jorail/PiedPiperS/docs/PiedPiperS_261_2026_03_25.pdf

# PiedPiperS

### smartphone speed control

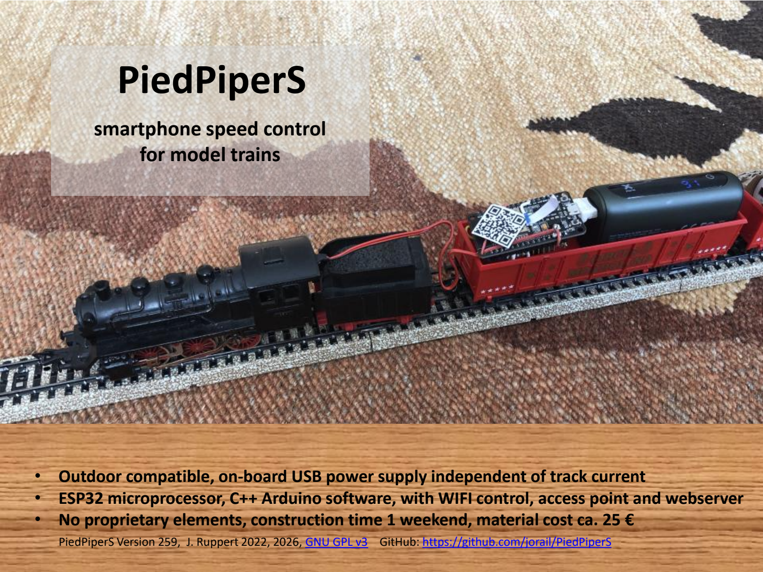
[picture p14: page 1]

### for model trains

- Outdoor compatible, on-board USB power supply independent of track current
- ESP32 microprocessor, C++ Arduino software, with WIFI control, access point and webserver
- No proprietary elements, construction time 1 weekend, material cost ca. 25 €

PiedPiperS Version 259, J. Ruppert 2022, 2026, GNU GPL v3 (https://www.gnu.org/licenses/gpl-3.0.en.html) GitHub: https://github.com/jorail/PiedPiperS

# PiedPiperS outdoor model train operation

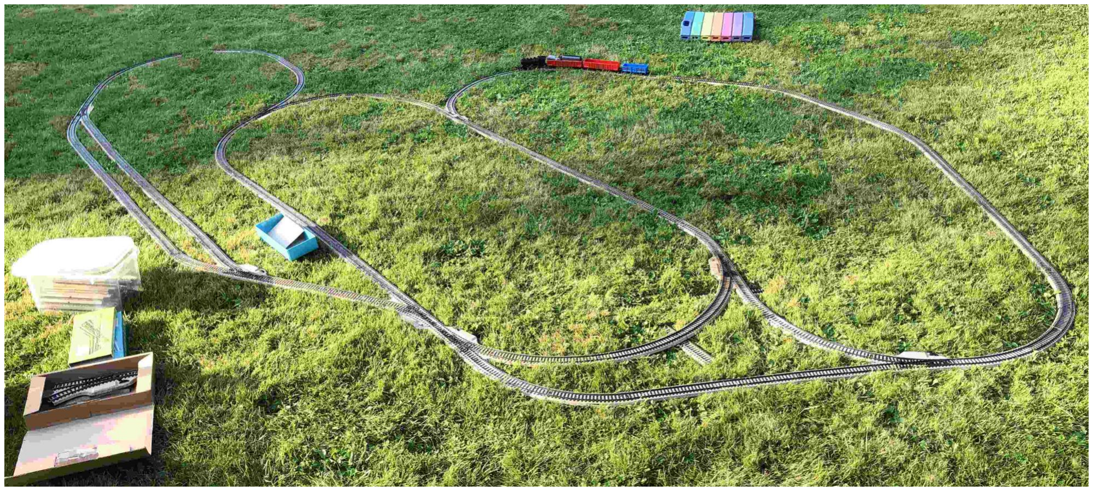
[picture p15: figure]

PiedPiperS (https://github.com/jorail/PiedPiperS) Version 244, J. Ruppert 2021-09-05, GNU GPL v3 (https://www.gnu.org/licenses/gpl-3.0.en.html)

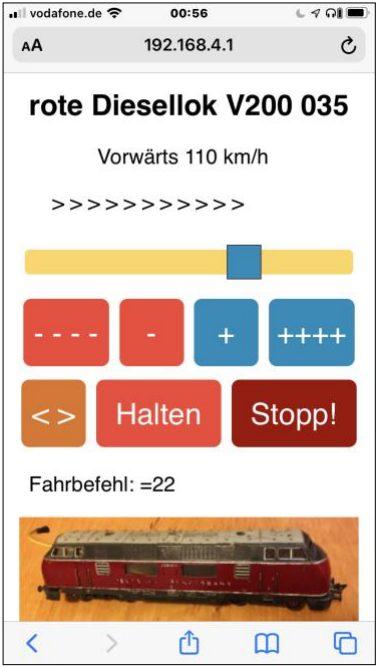
[picture p16: figure]

# Train control website on smartphone

- Compatible with every smartphone with WIFI
- ESP32 WIFI access point mounted on train
- Browser access to control panel via webserver
- Stable WIFI remote control for up to two users on HTML website with addition of simple JavaScript functions
- Additional manual control via touch pin
- Feedback from train operation on two LEDs
- Motor IC error handling, short cut protection
- ESP32 voltage spike and brownout protection
- Option for online power measurement and data display in tables and charts
- Option for true speed measurement by IR sensor detection of railway sleepers

PiedPiperS (https://github.com/jorail/PiedPiperS) Version 244, J. Ruppert 2021-09-05, GNU GPL v3 (https://www.gnu.org/licenses/gpl-3.0.en.html)

# PiedPiperS touch commands

Touch code | Command for speed level | Meaning
- | -- | decrease speed
•• | -------- | slow down
••• | -------------------------------- | brake to halt
•••• | 0 | fast brake and stop
••••• | 00< | fast stop, reverse direction
- ― | ++ | increase speed
- ― ― | ++++++++ | speed up
- ― ― ― | ++++++++++++++++ | go fast
― | 0 | fast brake and stop
― ― | 00 | fast brake and stop
| 00 | fast brake and stop
― ― ― | ? | info?

PiedPiperS (https://github.com/jorail/PiedPiperS) Version 244, J. Ruppert 2021-08-26, GNU GPL v3 (https://www.gnu.org/licenses/gpl-3.0.en.html)

# PiedPiper LED indicators

LEDs
Information on motor direction and speedlevel 0 to 32: • forward = 1 = blue LED + 0 to 16 short LED flashes • backward = 0 = red LED + 0 to 16 short LED flashes

Adjustment of motor speed: • 2 blue LED flash = speed level + 2; • 2 red LED flash = speed level - 2; • green & red LEDs long flash = fast brake, speed level = 0

Change of motor direction: • blue/red/blue + blue LED flash = forward = 1 • red/blue/red + red LED flash = backward = 0

Program running and main loop frequency: • orange flash after 5,000 main loop cycles, 200 times monitoring for input activity and up to 5 speed adjustments

PiedPiperS (https://github.com/jorail/PiedPiperS) Version 244, J. Ruppert 2021-08-26, GNU GPL v3 (https://www.gnu.org/licenses/gpl-3.0.en.html)

# PiedPiperS integrated version

## https://github.com/jorail/PiedPiperS

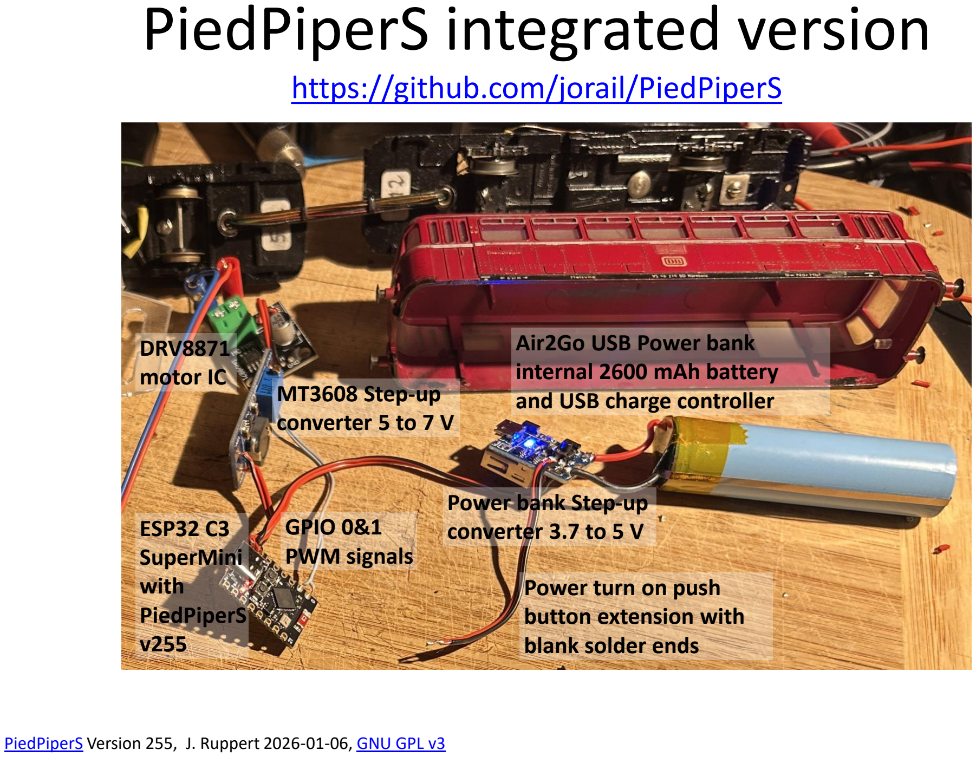
[picture p17: page 6]

PiedPiperS (https://github.com/jorail/PiedPiperS) Version 255, J. Ruppert 2026-01-06, GNU GPL v3 (https://www.gnu.org/licenses/gpl-3.0.en.html)

ESP32 C3
SuperMini
with
PiedPiperS
v255

DRV8871
motor IC
MT3608 Step-up
converter 5 to 7 V

Power bank Step-up
converter 3.7 to 5 V

Air2Go USB Power bank
internal 2600 mAh battery
and USB charge controller

Power turn on push
button extension with
blank solder ends

GPIO 0&1
PWM signals

# PiedPiperS integrated version

## https://github.com/jorail/PiedPiperS

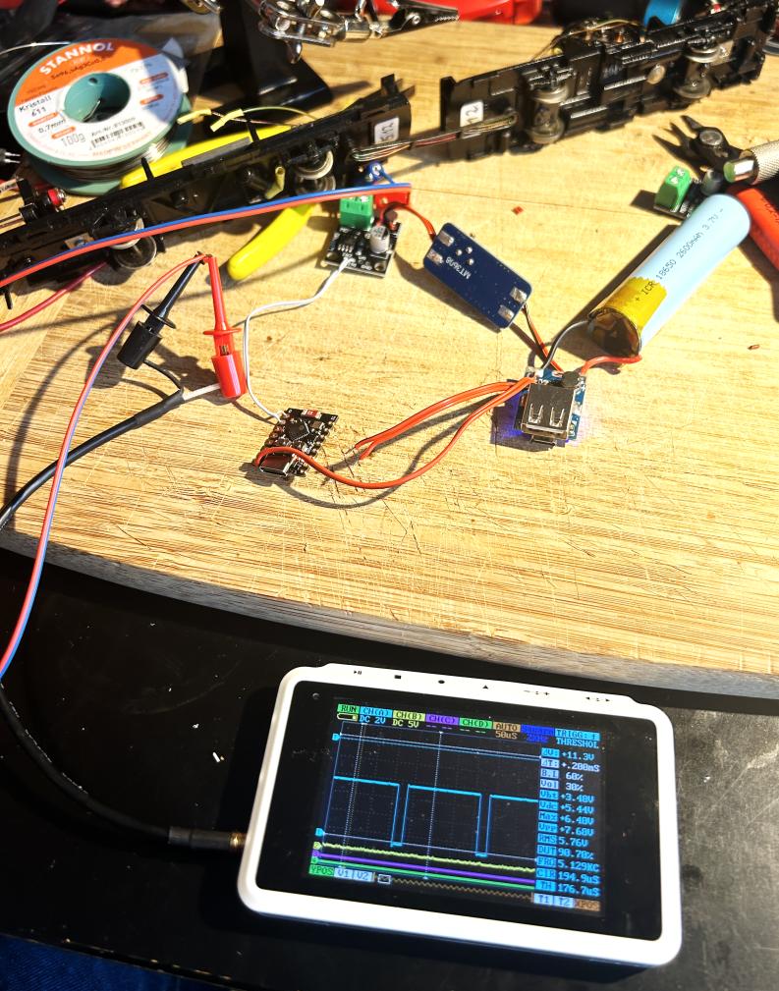
[picture p18: figure]

PiedPiperS (https://github.com/jorail/PiedPiperS) Version 255, J. Ruppert 2026-01-06, GNU GPL v3 (https://www.gnu.org/licenses/gpl-3.0.en.html)

PWM gesteuerte
Ausgangsspannung
der H-Brücke für
Motorregelung

# PiedPiperS v259 für Schienenbus VT 98

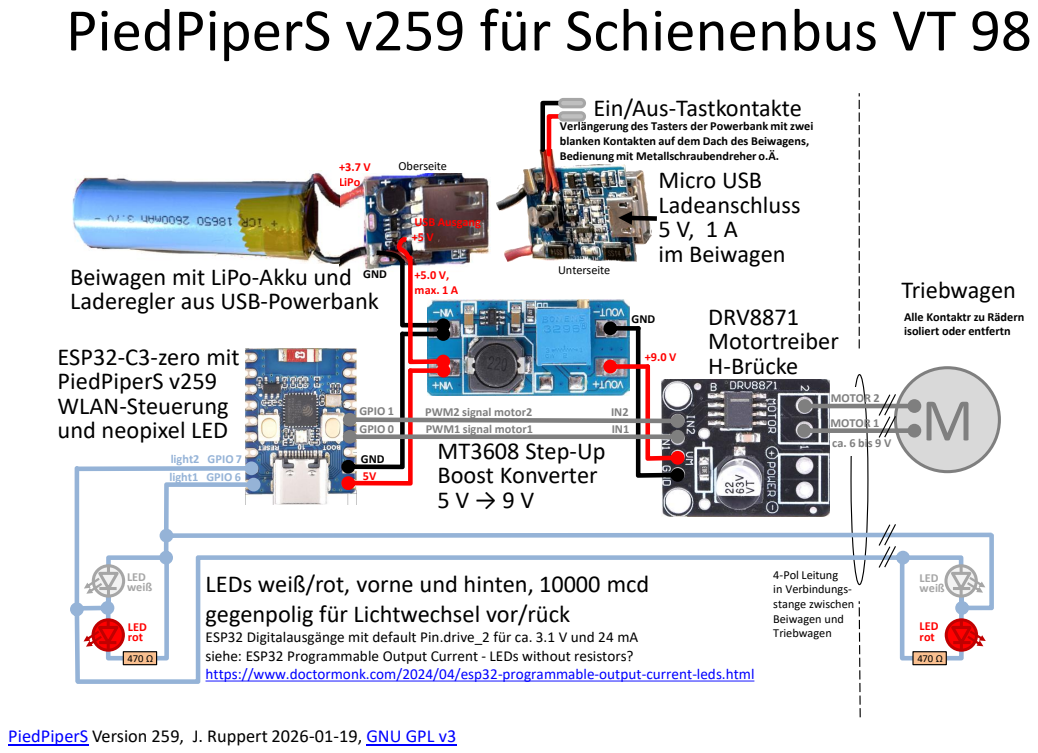
[picture p19: page 8]
GPIO 1 GPIO 0; GND 5V; PWM2 PWM1; signal signal; motor2 motor1; +5.0 V, max. 1 A; USB Ausgang +5 V; GND; +3.7 V LiPo; GPIO 7 GPIO 6; MOTOR 2; MOTOR 1; Micro USB Ladeanschluss 5 V, 1 A im Beiwagen; light2 light1; LED weiß; LED rot; ca. 6 bis 9 V; 4-Pol Leitung in Verbindungs- stange zwischen Beiwagen und Triebwagen; Triebwagen; DRV8871 Motortreiber H-Brücke; MT3608 Step-Up Boost Konverter 5 V → 9 V; Oberseite; Unterseite

Ein/Aus-Tastkontakte

Verlängerung des Tasters der Powerbank mit zwei
blanken Kontakten auf dem Dach des Beiwagens,
Bedienung mit Metallschraubendreher o.Ä.

Beiwagen mit LiPo-Akku und
Laderegler aus USB-Powerbank

Alle Kontaktr zu Rädern
isoliert oder entfertn

ESP32-C3-zero mit
PiedPiperS v259
WLAN-Steuerung
und neopixel LED

LEDs weiß/rot, vorne und hinten, 10000 mcd
gegenpolig für Lichtwechsel vor/rück
ESP32 Digitalausgänge mit default Pin.drive_2 für ca. 3.1 V und 24 mA
siehe: ESP32 Programmable Output Current - LEDs without resistors?
https://www.doctormonk.com/2024/04/esp32-programmable-output-current-leds.html

PiedPiperS (https://github.com/jorail/PiedPiperS) Version 259, J. Ruppert 2026-01-19, GNU GPL v3 (https://www.gnu.org/licenses/gpl-3.0.en.html)

# Schienenbus VT98 Beiwagen LiPo Akku und Steuerung eingebaut

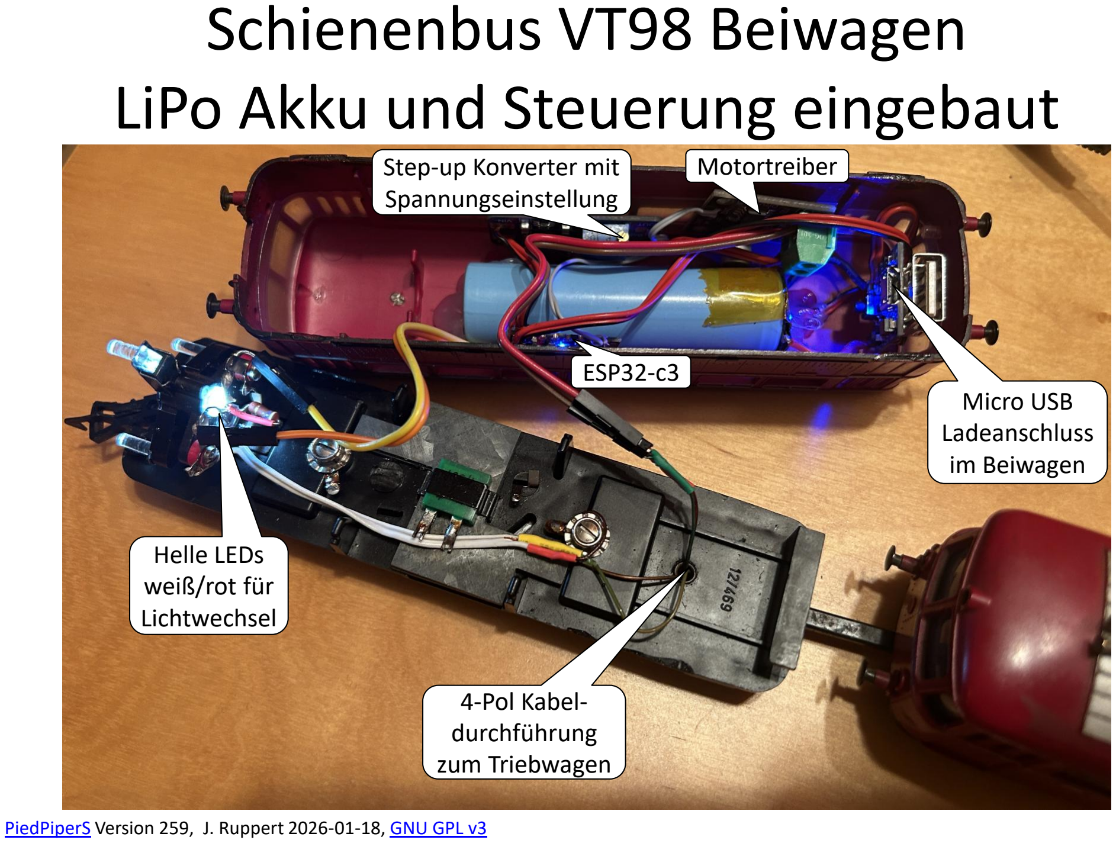
[picture p20: page 9]

PiedPiperS (https://github.com/jorail/PiedPiperS) Version 259, J. Ruppert 2026-01-18, GNU GPL v3 (https://www.gnu.org/licenses/gpl-3.0.en.html)

Micro USB
Ladeanschluss
im Beiwagen

4-Pol Kabel-durchführung
zum Triebwagen

Step-up Konverter mit
Spannungseinstellung

Motortreiber

ESP32-c3

Helle LEDs
weiß/rot für
Lichtwechsel

# Stirnlichter

## LED weiß/rot gegenpolig und mit Vorwiderstand für rote LED

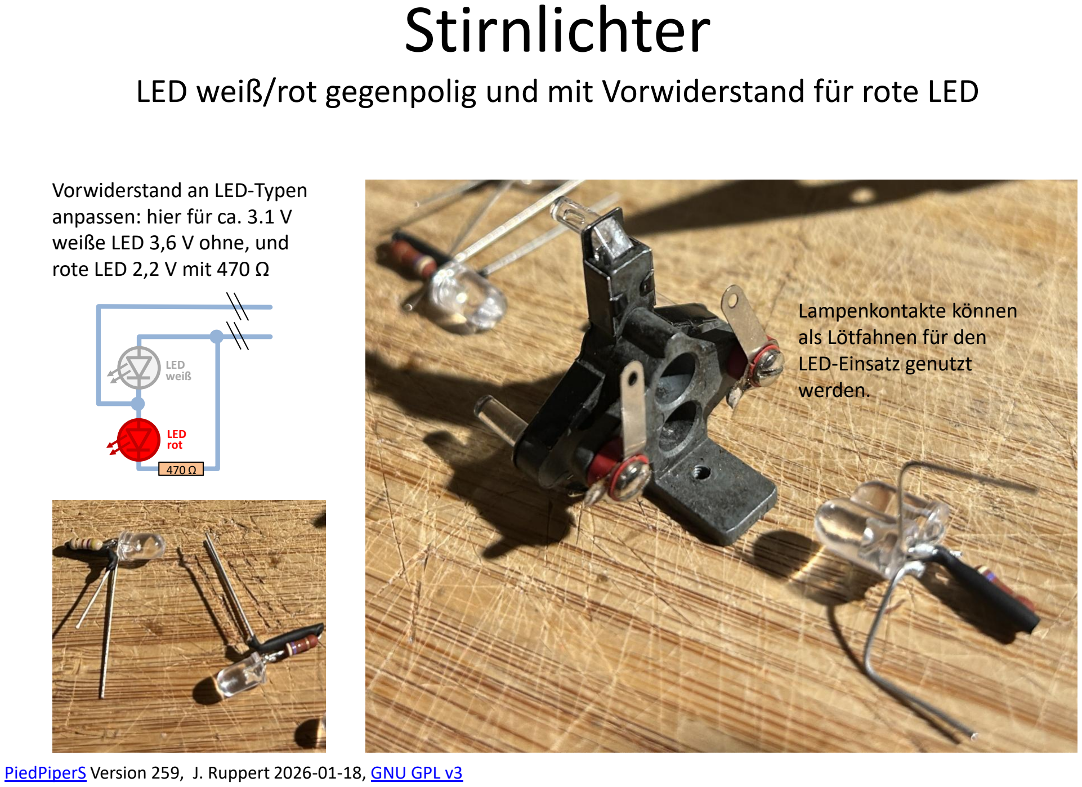
[picture p21: page 10]

470 Ω

LED
weiß

LED
rot

Vorwiderstand an LED-Typen anpassen: hier für ca. 3.1 V weiße LED 3,6 V ohne, und
rote LED 2,2 V mit 470 Ω

Lampenkontakte können
als Lötfahnen für den
LED-Einsatz genutzt
werden.

PiedPiperS (https://github.com/jorail/PiedPiperS) Version 259, J. Ruppert 2026-01-18, GNU GPL v3 (https://www.gnu.org/licenses/gpl-3.0.en.html)

# Schienenbus VT98 Triebwagen

# mit isolierten Radkontakten und LED-Beleuchtung

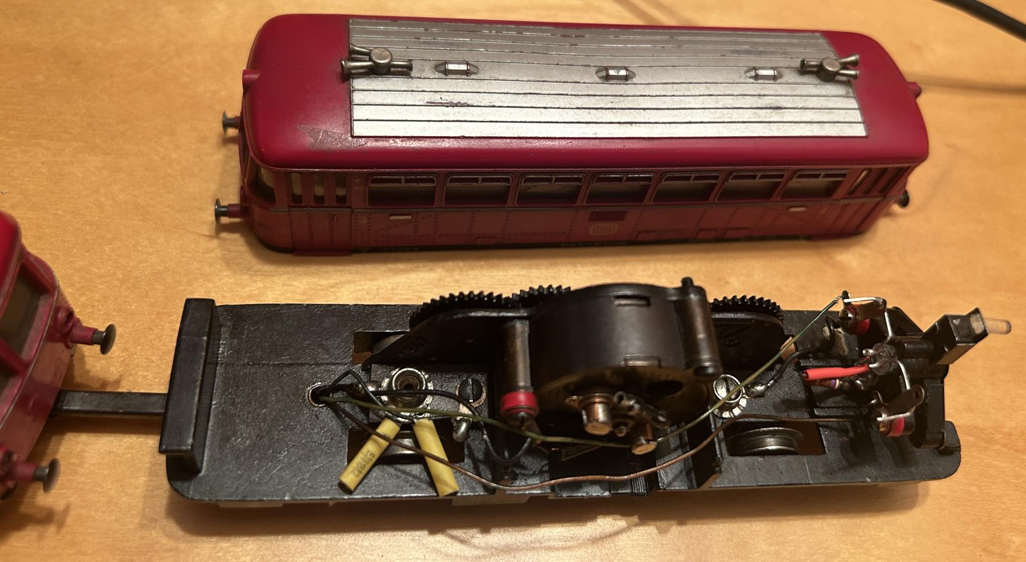
[picture p22: figure]

PiedPiperS (https://github.com/jorail/PiedPiperS) Version 259, J. Ruppert 2026-01-18, GNU GPL v3 (https://www.gnu.org/licenses/gpl-3.0.en.html)

# Schienenbus VT98 Beiwagen

# An/Aus durch Tastkontakt auf dem Dach

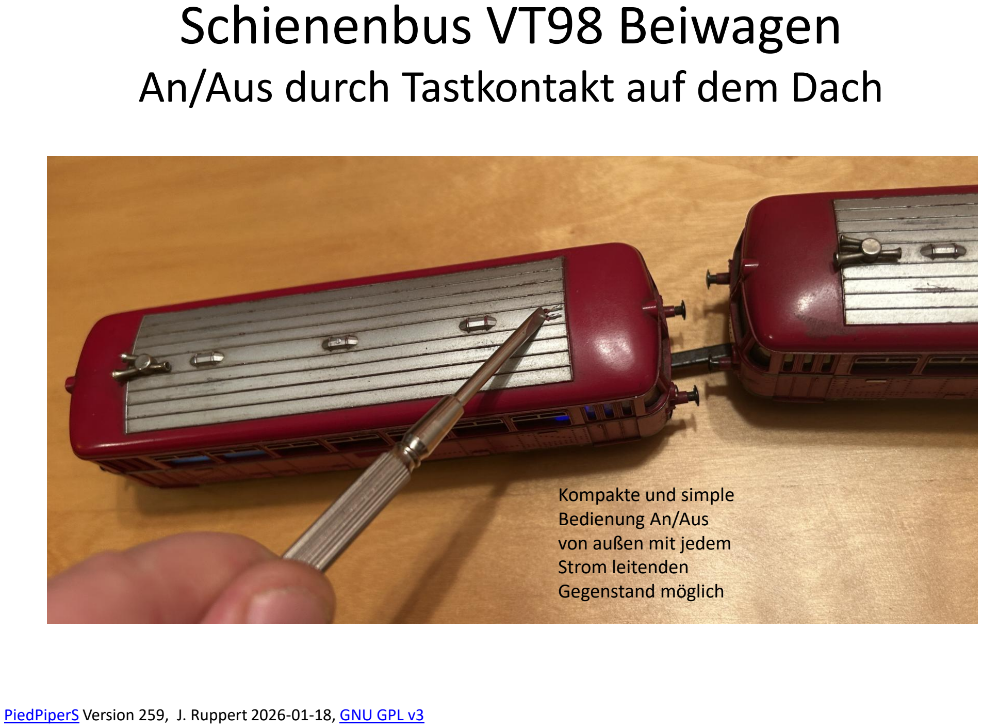
[picture p23: page 12]
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

Kompakte und simple
Bedienung An/Aus
von außen mit jedem
Strom leitenden
Gegenstand möglich

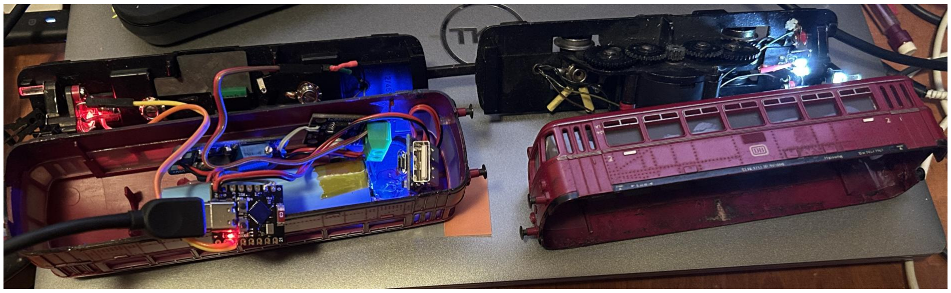
[picture p24: figure]
