jorail/PiedPiperS/docs/PiedPiperS_191_circuit.pdf

# PiedPiperS circuit

## ESP32 DevKit V1, step-up converter and TLE5206-2S

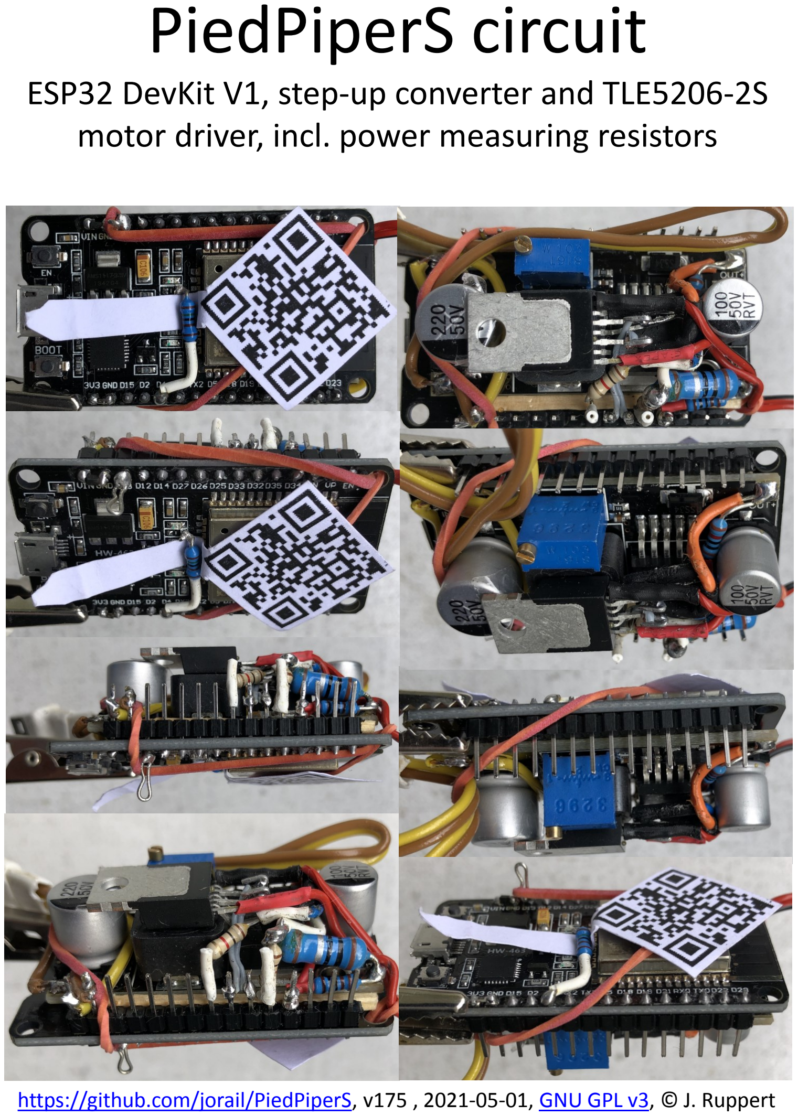
[picture p78: page 1]

## motor driver, incl. power measuring resistors

https://github.com/jorail/PiedPiperS, v175 , 2021-05-01, GNU GPL v3, (https://www.gnu.org/licenses/gpl-3.0.en.html) © J. Ruppert

# ESP32 & TLE5206-2S

integrated mounting and wiring with LDO protection,

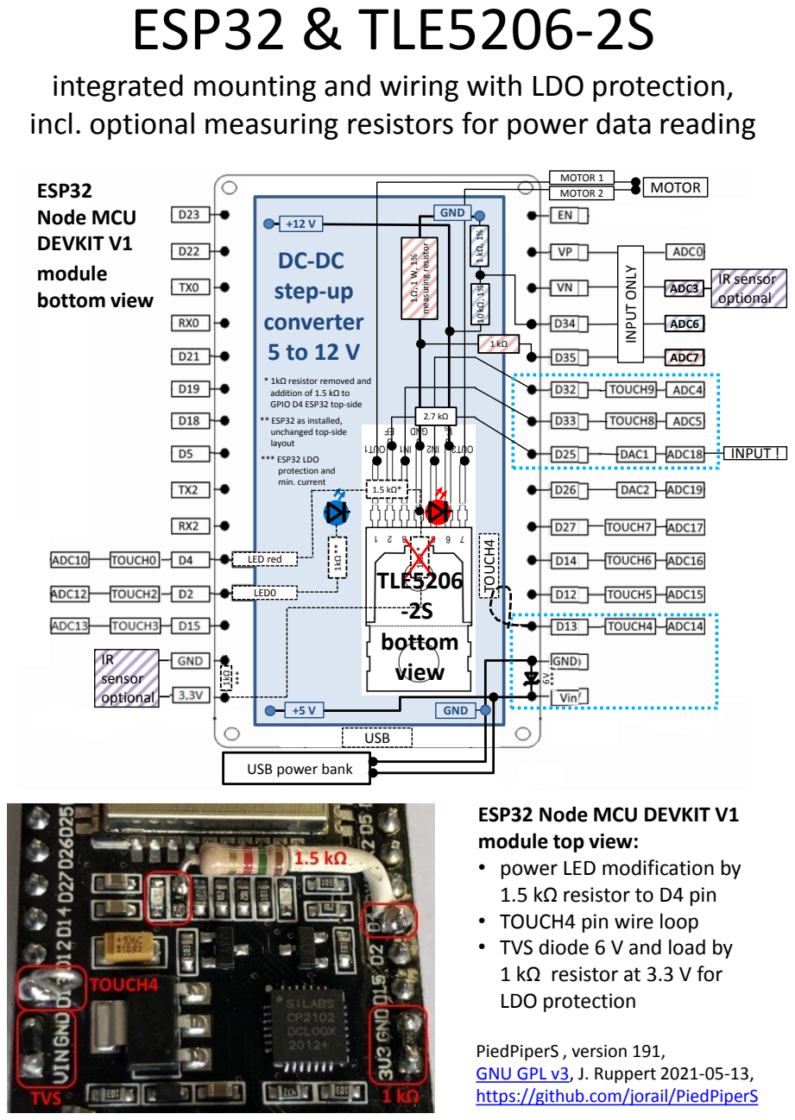
[picture p79: page 2]
ESP32 Node MCU DEVKIT V1 module bottom view; MOTOR; LED0; LED red; GND; DC-DC step-up converter; TOUCH4; TLE5206 -2S bottom view; INPUT !; MOTOR 1 MOTOR 2; USB; measuring resistor; ADC7; ADC6; IR sensor optional ADC3; IR sensor optional

incl. optional measuring resistors for power data reading
https://github.com/jorail/PiedPiperS INPUT ONLY

* 1kΩ resistor removed and
addition of 1.5 kΩ to
GPIO D4 ESP32 top-side
** ESP32 as installed,
unchanged top-side
layout
*** ESP32 LDO
protection and
min. current

USB power bank

ESP32 Node MCU DEVKIT V1
module top view:
• power LED modification by
1.5 kΩ resistor to D4 pin
• TOUCH4 pin wire loop
• TVS diode 6 V and load by
1 kΩ resistor at 3.3 V for
LDO protection

PiedPiperS , version 191,
GNU GPL v3, (https://www.gnu.org/licenses/gpl-3.0.en.html) J. Ruppert 2021-05-13,

# Reflective IR sensor optional

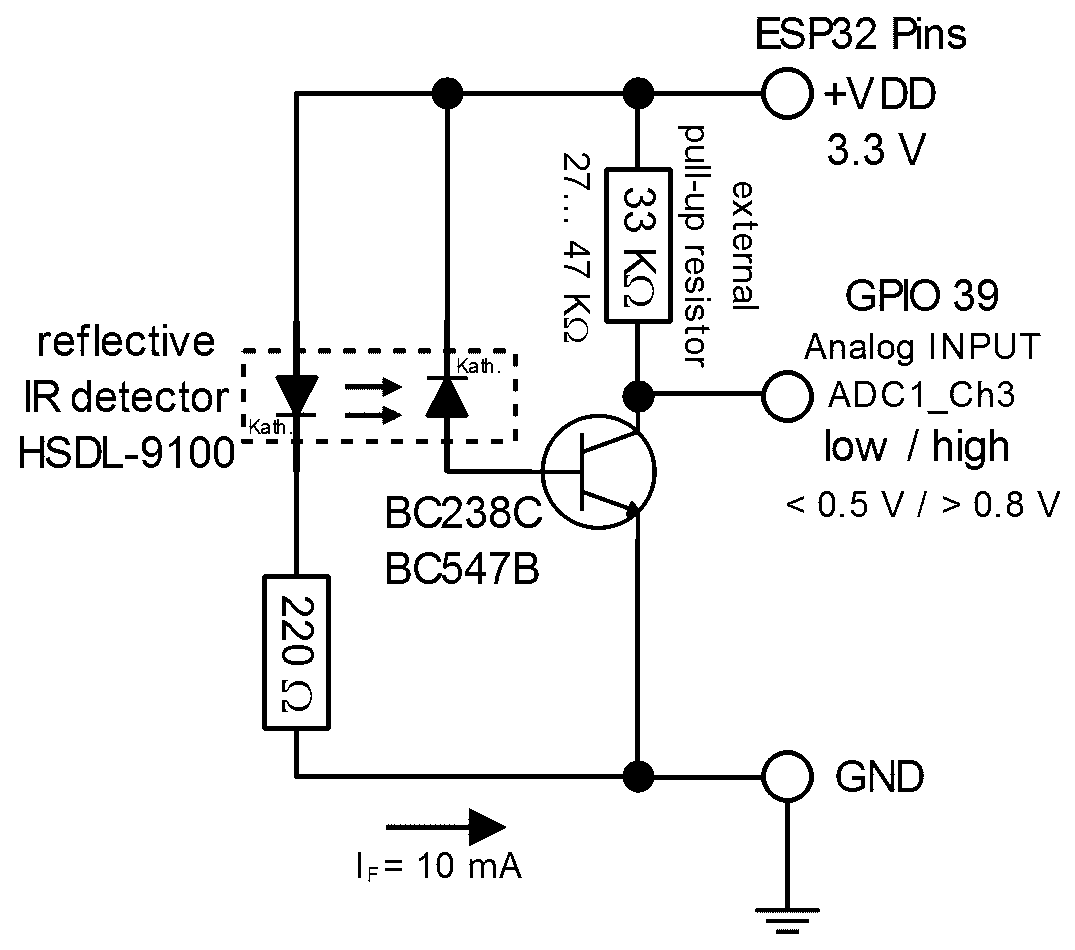
[picture p80: figure]

https://github.com/jorail/PiedPiperS, v191 , 2021-05-13, GNU GPL v3, (https://www.gnu.org/licenses/gpl-3.0.en.html) © J. Ruppert
