jorail/PiedPiperS/PiedPiperS/add_data/PiedPiper.pdf

# PiedPiper

# whistle speed control

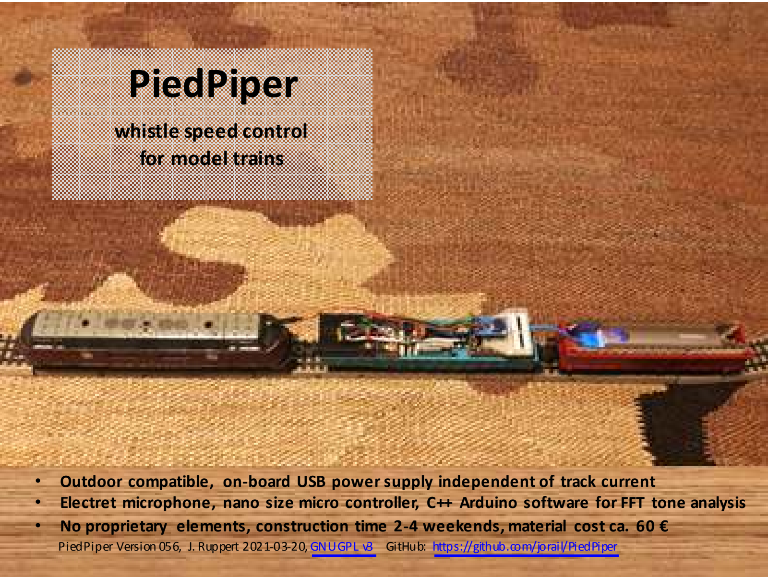
[picture p81: page 1]

# for model trains

## - Outdoor compatible, on-board USB power supply independent of track current

- Electret microphone, nano size micro controller, C++ Arduino software for FFT tone analysis

## - No proprietary elements, construction time 2-4 weekends, material cost ca. 60 €

PiedPiper Version 056, J. Ruppert 2021-03-20, GNU GPL v3 GitHub: https://github.com/jorail/PiedPiper

# Material demand

# for 1 train with whistle control

## Electronics

- Nano size microcontroller,
e.g. Teensy 4.0, but similar solutions are possible with other microcontrollers like Teensy 3.2, ESP32, etc.
– | 1 analogue in for microphone output
– | 2 PWM outputs for motor control
– | 2 digital outputs for LED indicators
– | 1 digital input for option 1 switch
- Compatible electret microphone module, 3.3 V, e.g. MAX9814, Amplifier with Auto Gain Control
- Step-up DC/DC converter module, 5 V to 12V … 16 V
- H-Bridge DC motor control IC, e.g. TLE5206-2S
- Small size USB power bank as 5 V DC power supply
it is good to have two, 2nd for replacement when 1stempty
- Small size breadboard, e.g. 170 contacts
- Solder IC pin contacts, single row, separable, total of ca. 50 contacts
- Shrink tube with diameter for holding two IC pin contacts
- Thin USB cable, old and used, but reliable for power connection
- LEDs: 1 green, 1 red, 2 yellow, 3 mm diameter
- 2 x 180 Ω resistors
- 1 kΩ resistor
- 2 pole cable, thin and flexible, ca. 40 cm, for connection to motor
- 3 pole isolated wire for microphone module, 10 cm
- 1 pole wires for breadboard and step up converter connections, ca. 60 cm in total

## Other material

- Model train locomotive with 12V … 16 V DC motor
- Flat wagon for electronics equipment
- Eaos high board open wagon for USB power bank
- Some paper cardboard
- Single and double sided adhesive tape

## Tools

- Single tone sound source: Whistle or flute, e.g. recorder
- Fine tip solder iron with equipment
- Cutter, fine pincers
- Multi-meter tool

## Option 1 addition

- Micro switch for testing and manual commands
- 10 kΩ resistor
- 1 pole wire, ca. 15 cm

## Option 2 addition

- Small left/right sound balance meter from old equipment, e.g. 270 Ω
- Suitable set of resistors, e.g. 10 kΩ + several 1 to 5 kΩ resistors
- 2 pole cable, thin and flexible, ca. 10 cm

## Estimated material cost ca. 60 € excl. other material, tools and additions

### PiedPiper Version 034, J. Ruppert 2020-11-17, GNU GPL v3

# Soldered IC base contacts and small breadboard

# Nano size micro

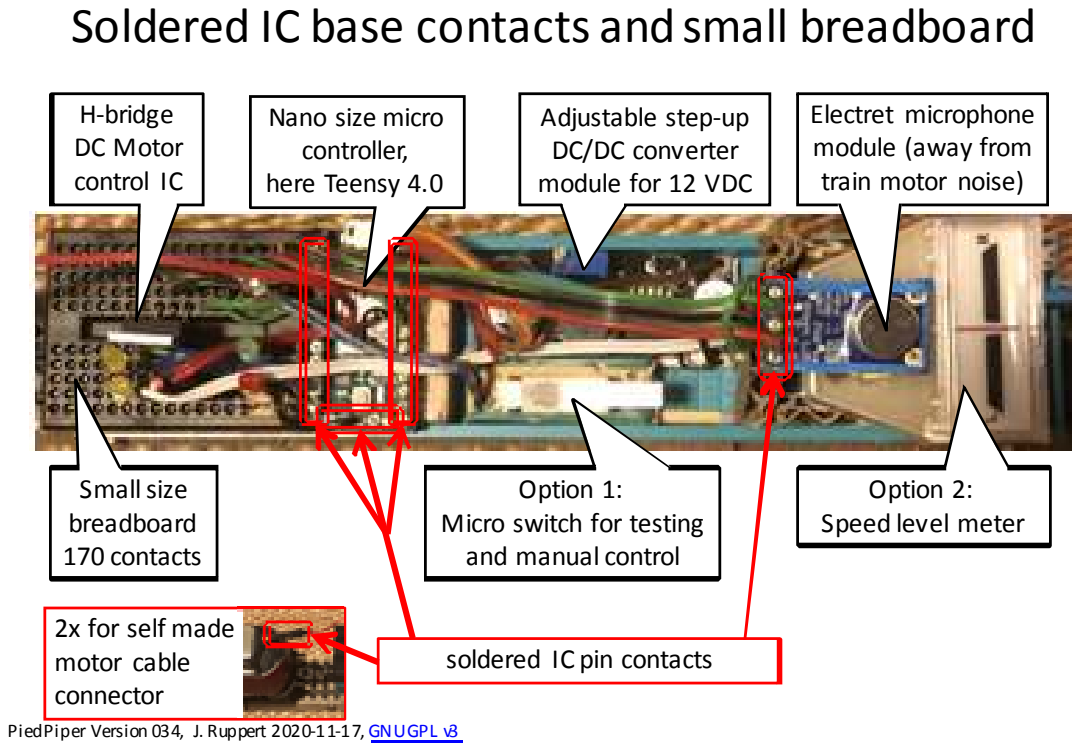
[picture p82: page 3]
controller, here Teensy 4.0; Option 1:; Small size breadboard 170 contacts; H-bridge DC Motor control IC

Electret microphone
module (away from
train motor noise)

Adjustable step-up
DC/DC converter
module for 12 VDC

Option 2:
Speed level meter

Micro switch for testing
and manual control

2x for self made
motor cable
connector

soldered IC pin contacts

# Circuit, parts and connections

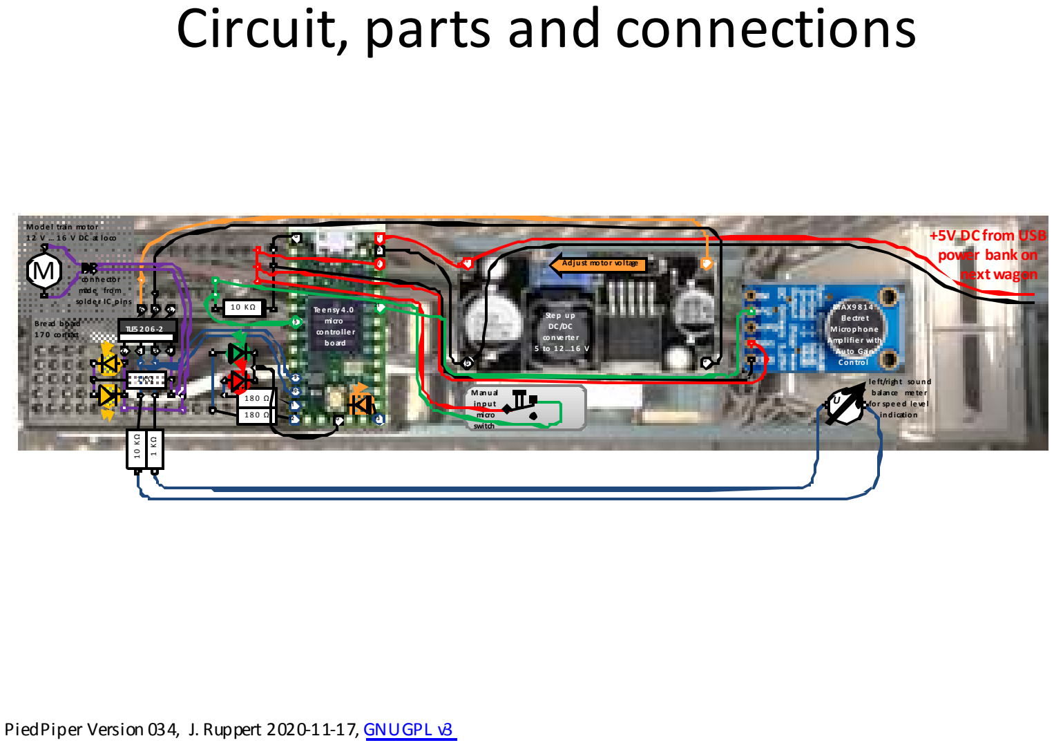
[picture p83: page 4]
TLE5 2 0 6 -2; M an u al in p u t micro switch

M o d e l train mo to r

+5V DC from USB
power bank on
next wagon

Ad ju st mo to r vo ltage

co n n e cto r
mad e fro m

Ele ctre t
M icro p h o n e
Amp lifie r with
Au to Gain
C o n tro l

micro
co n tro lle r
b o ard

Ste p u p
co n ve rte r

Bre ad b o ard
1 7 0 co n tact

le ft/righ t so u n d
b alan ce me te r
in d icatio n

# PiedPiper whistle tone commands

Morse code | Command for speed level | Meaning
- | -- | decrease speed
•• | -------- | slow down
••• | -------------------------------- | break to halt
•••• | 0 | fast brake and stop
••••• | 00< | fast stop, reverse direction
- ― | ++ | increase speed
- ― ― | ++++++++ | speed up
- ― ― ― | ++++++++++++++++ | go fast
― | 0 | fast brake and stop
― ― | 00 | fast brake and stop
| 00 fast brake and stop
― ― ― | ? | info?
? | ? | info?

# PiedPiper LED indicators

## LEDs

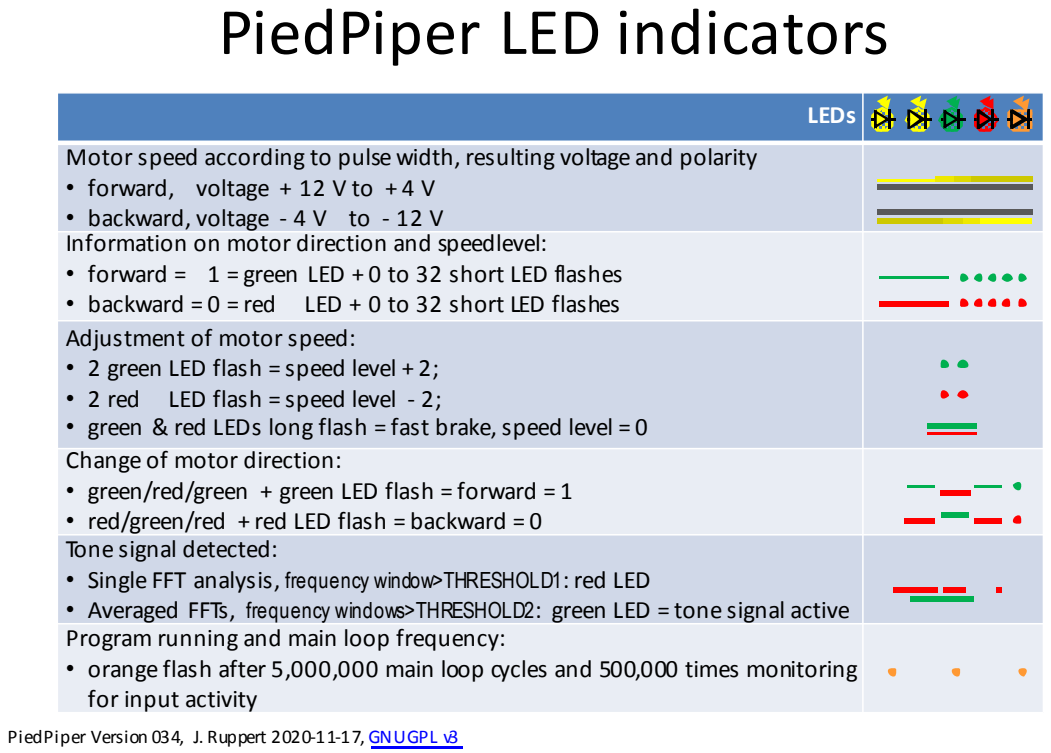
[picture p84: page 6]

Motor speed according to pulse width, resulting voltage and polarity • forward, voltage + 12 V to + 4 V • backward, voltage - 4 V to - 12 V

Information on motor direction and speedlevel: • forward = 1 = green LED + 0 to 32 short LED flashes • backward = 0 = red LED + 0 to 32 short LED flashes

Adjustment of motor speed: • 2 green LED flash = speed level + 2; • 2 red LED flash = speed level - 2; • green & red LEDs long flash = fast brake, speed level = 0

Change of motor direction: • green/red/green + green LED flash = forward = 1 • red/green/red + red LED flash = backward = 0

Tone signal detected: • Single FFT analysis, frequency window>THRESHOLD1: red LED • Averaged FFTs, frequency windows>THRESHOLD2: green LED = tone signal active

Program running and main loop frequency: • orange flash after 5,000,000 main loop cycles and 500,000 times monitoring for input activity

# Tone frequency table

Tone Hertz | Tone Hertz | Tone Hertz | Tone Hertz | Tone Hertz
''A 27,50 | C 65,41 | c' | 261,63 | c''' 1.046,50 | c''''' 4.186,01
''B 29,14 | Des 69,30 | des' 277,18 | des''' 1.108,73
''H 30,87 | D 73,42 | d' | 293,66 | d''' 1.174,66
'C 32,70 | Es 77,78 | es' 311,13 | es''' 1.244,51
'Des 34,65 | E 82,41 | e' | 329,63 | e''' | 1.318,51
'D 36,71 | F 87,31 | f' | 349,23 | f''' 1.396,91
'Es 38,89 | Ges 92,50 | ges' 369,99 | ges''' 1.479,98
'E 41,20 | G 98,00 | g' | 392,00 | g''' | 1.567,98
'F 43,65 | As 103,83 | as' 415,30 | as''' 1.661,22
'Ges 46,25 | A 110,00 | a' | 440,00 | a''' | 1.760,00
'G 49,00 | B 116,54 | b' | 466,16 | b''' 1.864,66
'As 51,91 | H 123,47 | h' | 493,88 | h''' 1.975,53
'A 55,00 | c 130,81 | c'' 523,25 | c'''' 2.093,00
'B 58,27 | des 138,59 | des'' 554,37 | des'''' 2.217,46
'H 61,74 | d 146,83 | d'' 587,33 | d'''' 2.349,32
es 155,56 | es'' 622,25 | es'''' 2.489,02
e 164,81 | e'' 659,26 | e'''' 2.637,02
f 174,61 | f'' 698,46 | f'''' 2.793,83
ges 185,00 | ges'' 739,99 | ges'''' 2.959,96
g 196,00 | g'' 783,99 | g'''' 3.135,96
as 207,65 | as'' 830,61 | as'''' 3.322,44
a 220,00 | a'' 880,00 | a'''' 3.520,00
b 233,08 | b'' 932,33 | b'''' 3.729,31
h 246,94 | h'' 987,77 =default h'''' 3.951,07
