jorail/PiedPiperS/docs/PiedPiperS_095_indoor_9398.JPG

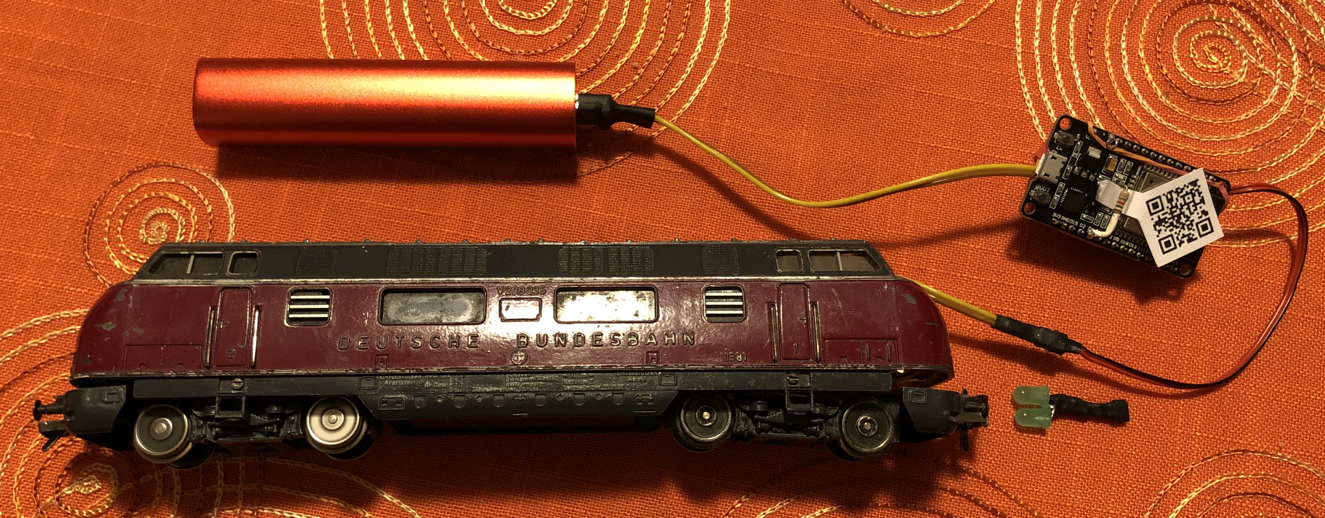
docs/PiedPiperS_095_indoor_9398.JPG
