jorail/PiedPiperS/docs/PiedPiperS_095_indoor_9456.JPG

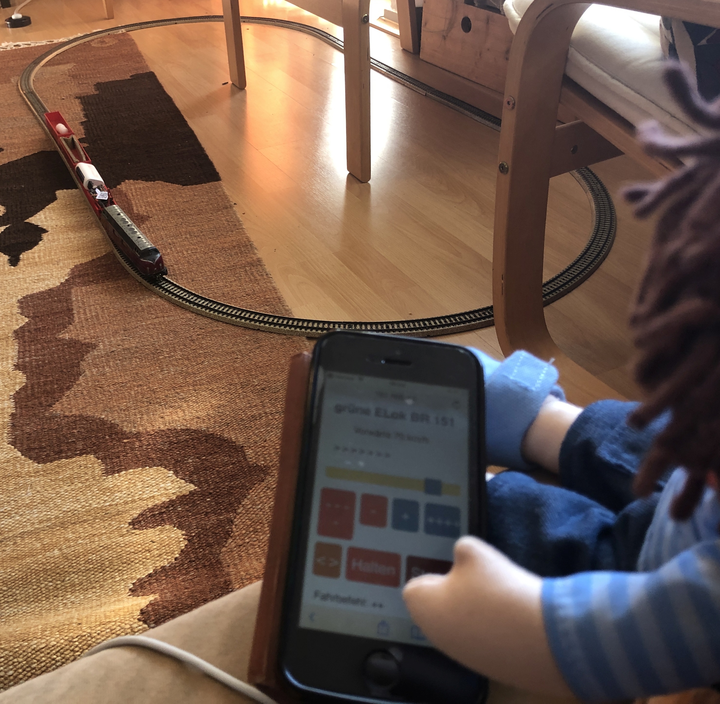
docs/PiedPiperS_095_indoor_9456.JPG
