jorail/PiedPiperS/docs/PiedPiperS_095_indoor_9461.JPG

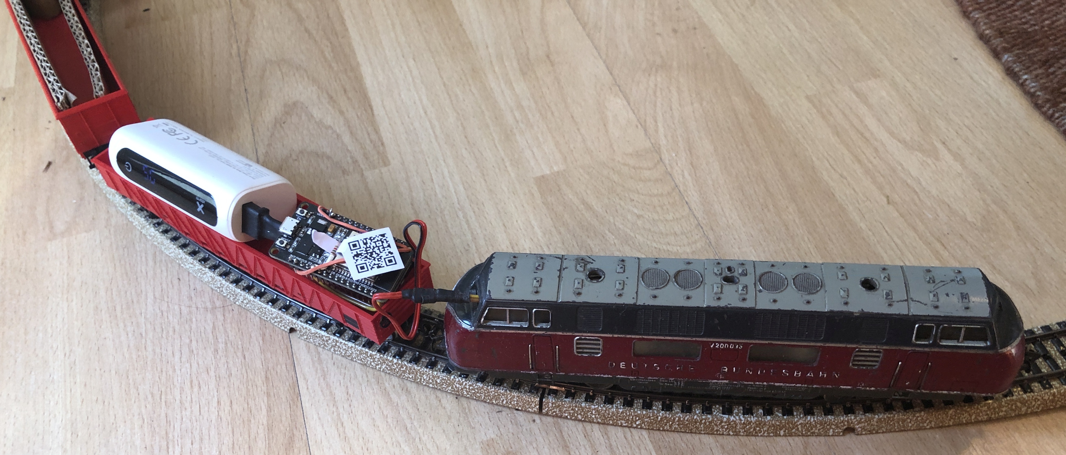
docs/PiedPiperS_095_indoor_9461.JPG
