jorail/PiedPiperS/docs/PiedPiperS_168_measuring_resistors.jpg

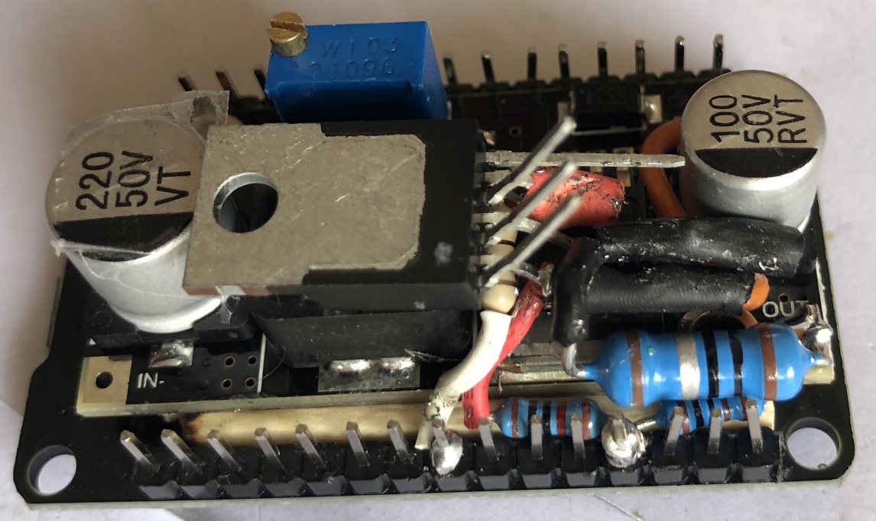
docs/PiedPiperS_168_measuring_resistors.jpg
