jorail/PiedPiperS/docs/PiedPiperS_168_uC_bottomview.jpg

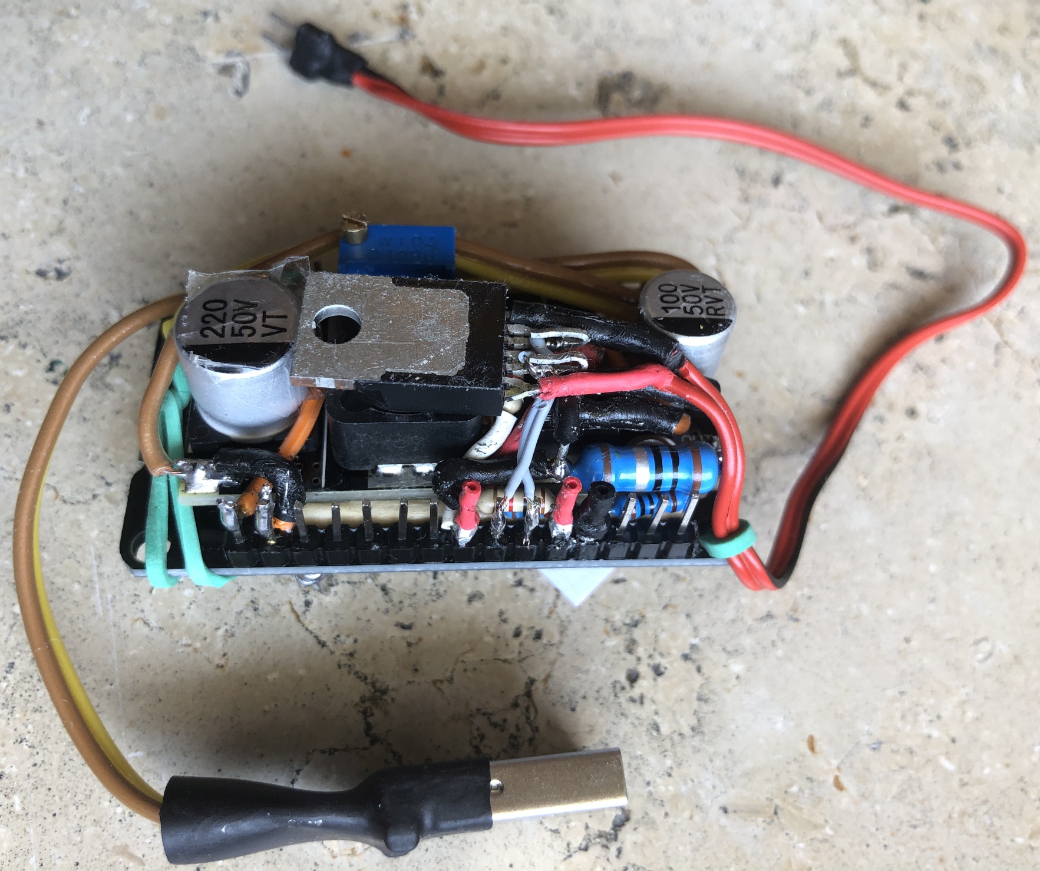
docs/PiedPiperS_168_uC_bottomview.jpg
