jorail/PiedPiperS/docs/PiedPiperS_168_uC_topview.jpg

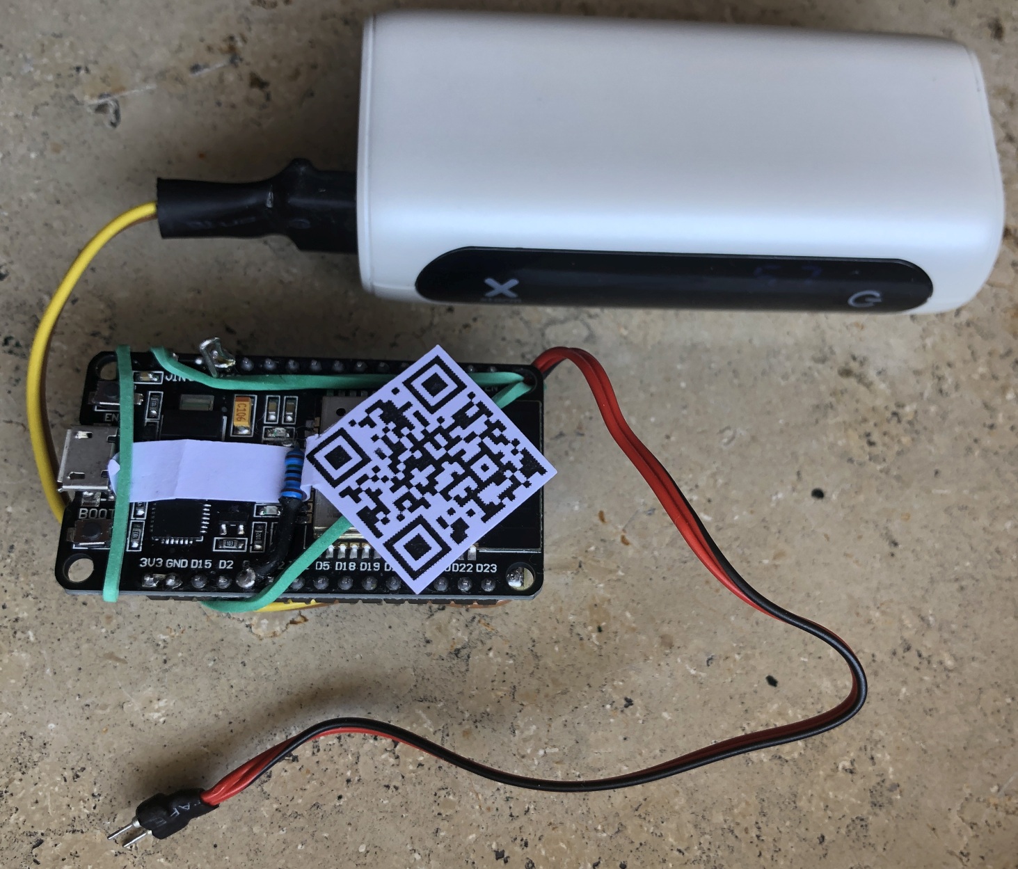
docs/PiedPiperS_168_uC_topview.jpg
