jorail/PiedPiperS/docs/PiedPiperS_173_3examples_bottom.jpg

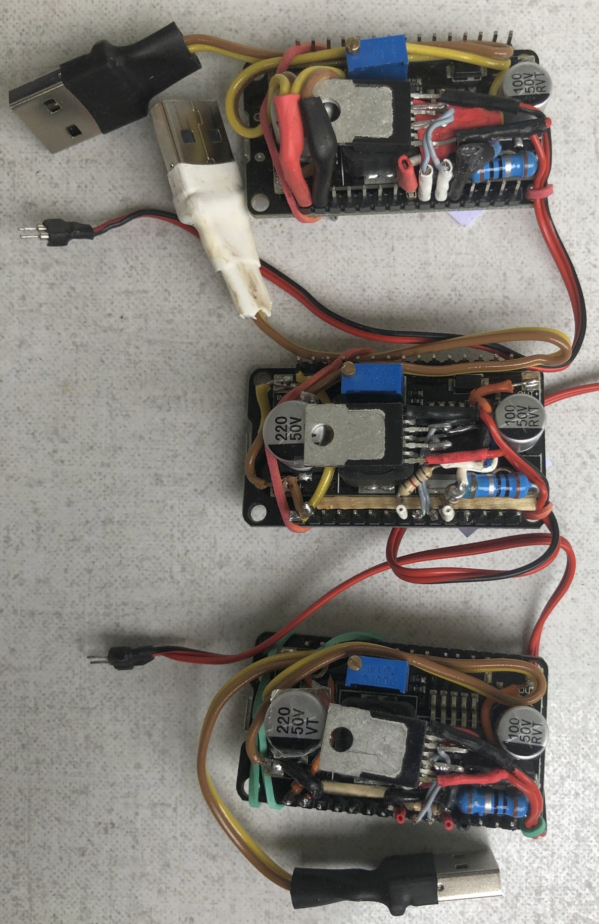
docs/PiedPiperS_173_3examples_bottom.jpg
