jorail/PiedPiperS/docs/PiedPiperS_173_3examples_top.jpg

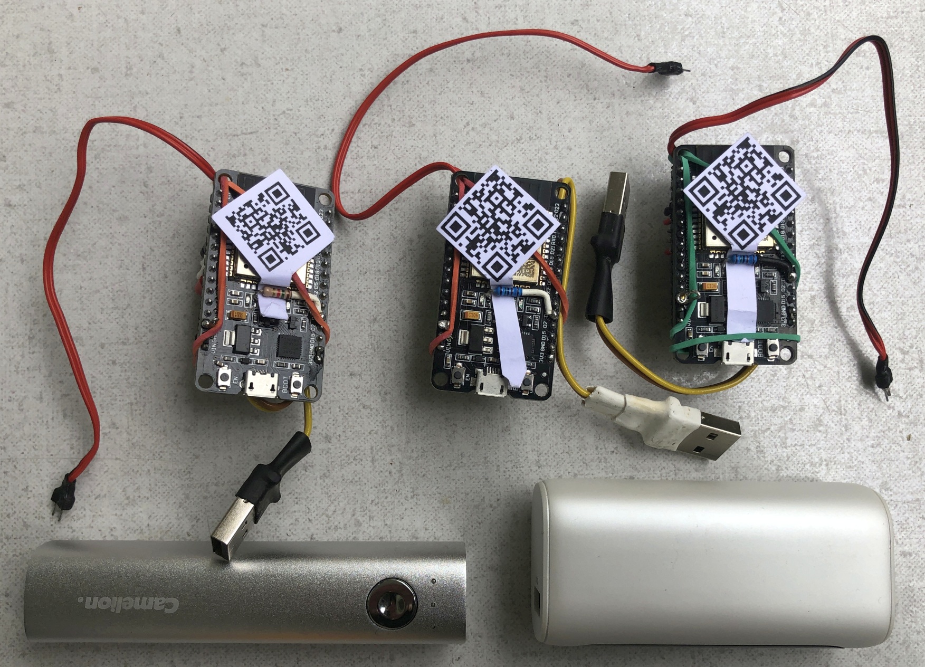
docs/PiedPiperS_173_3examples_top.jpg
