jorail/PiedPiperS/docs/PiedPiperS_175_indoor_9819.JPG

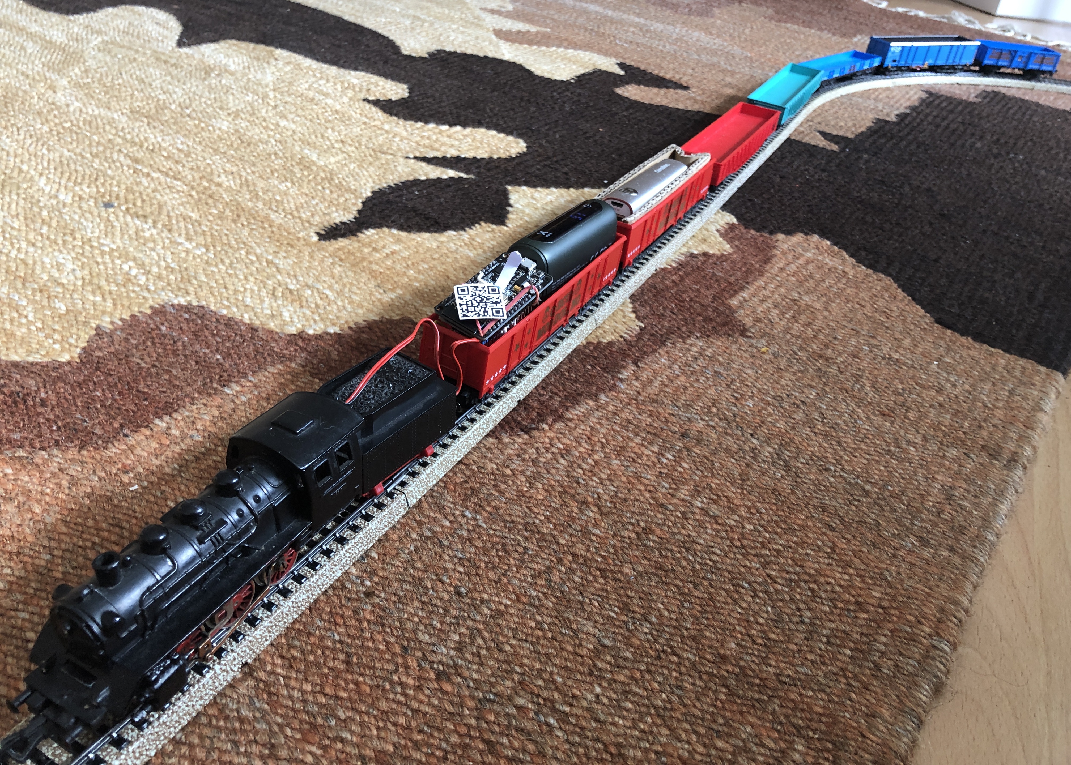
docs/PiedPiperS_175_indoor_9819.JPG
