jorail/PiedPiperS/docs/PiedPiperS_177_SteamLoco_9917.jpg

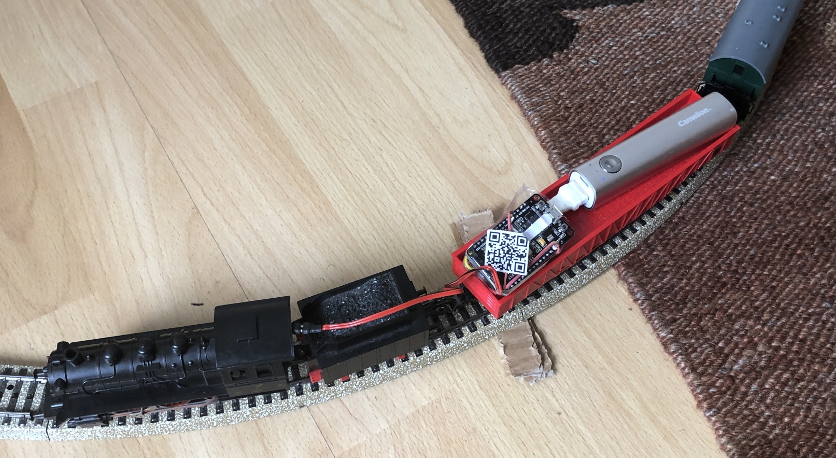
docs/PiedPiperS_177_SteamLoco_9917.jpg
