jorail/PiedPiperS/docs/PiedPiperS_177_SteamLoco_9927.jpg

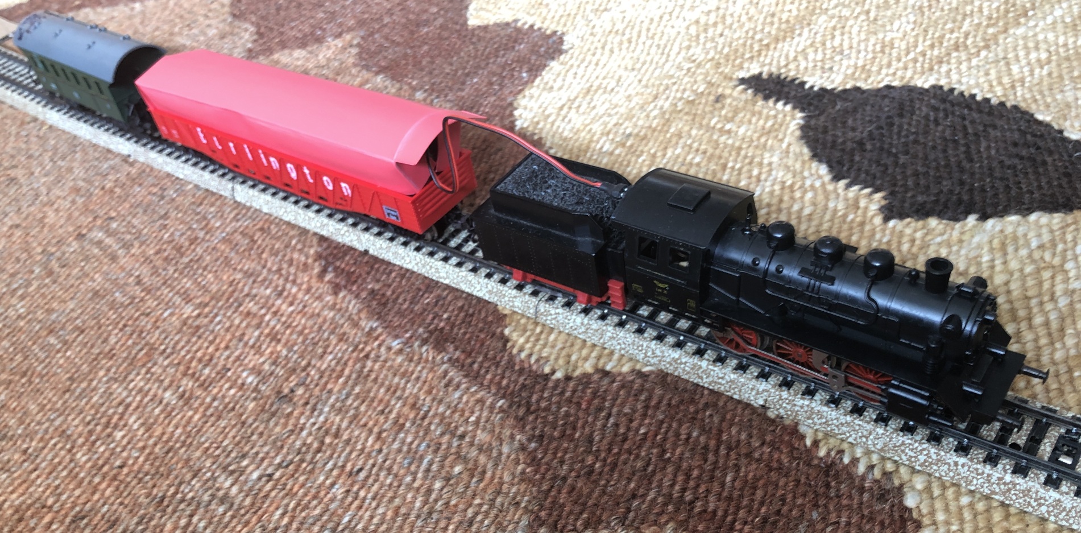
docs/PiedPiperS_177_SteamLoco_9927.jpg
