jorail/PiedPiperS/docs/PiedPiperS_192_circuit.jpg

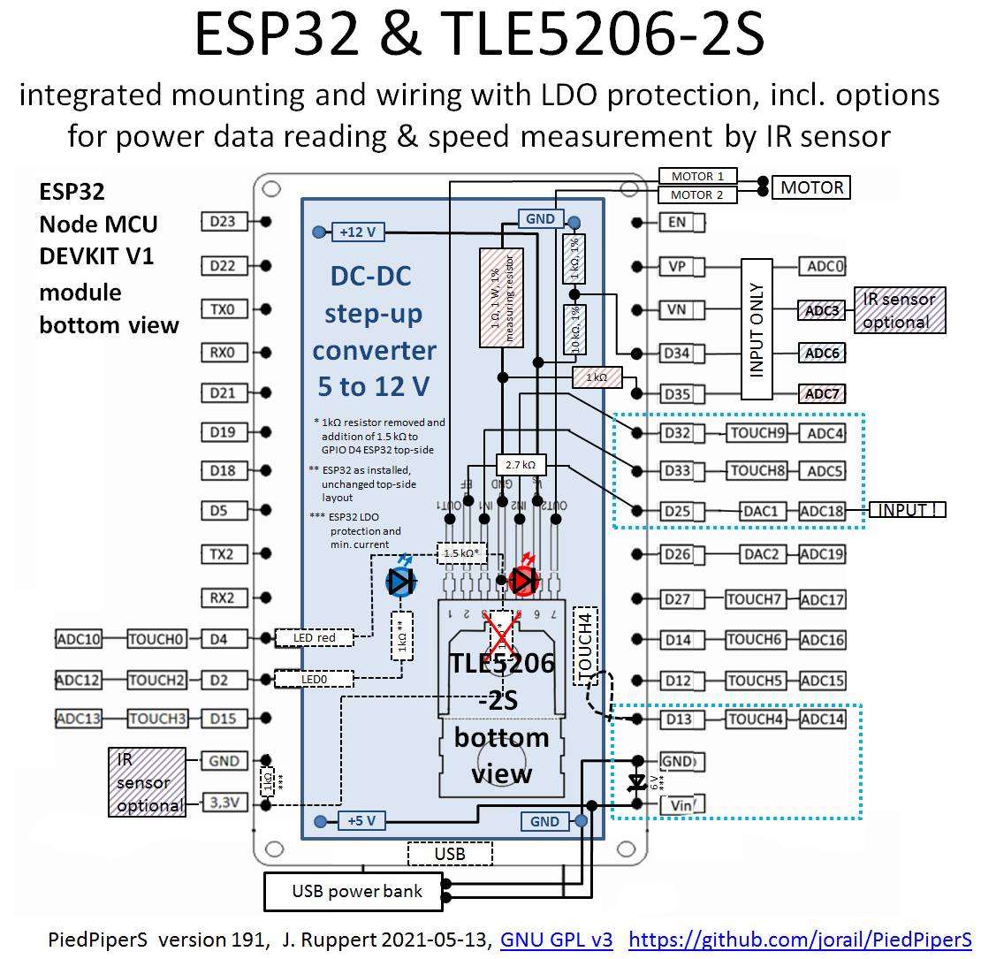
docs/PiedPiperS_192_circuit.jpg
