jorail/PiedPiperS/docs/PiedPiperS_244a.jpg

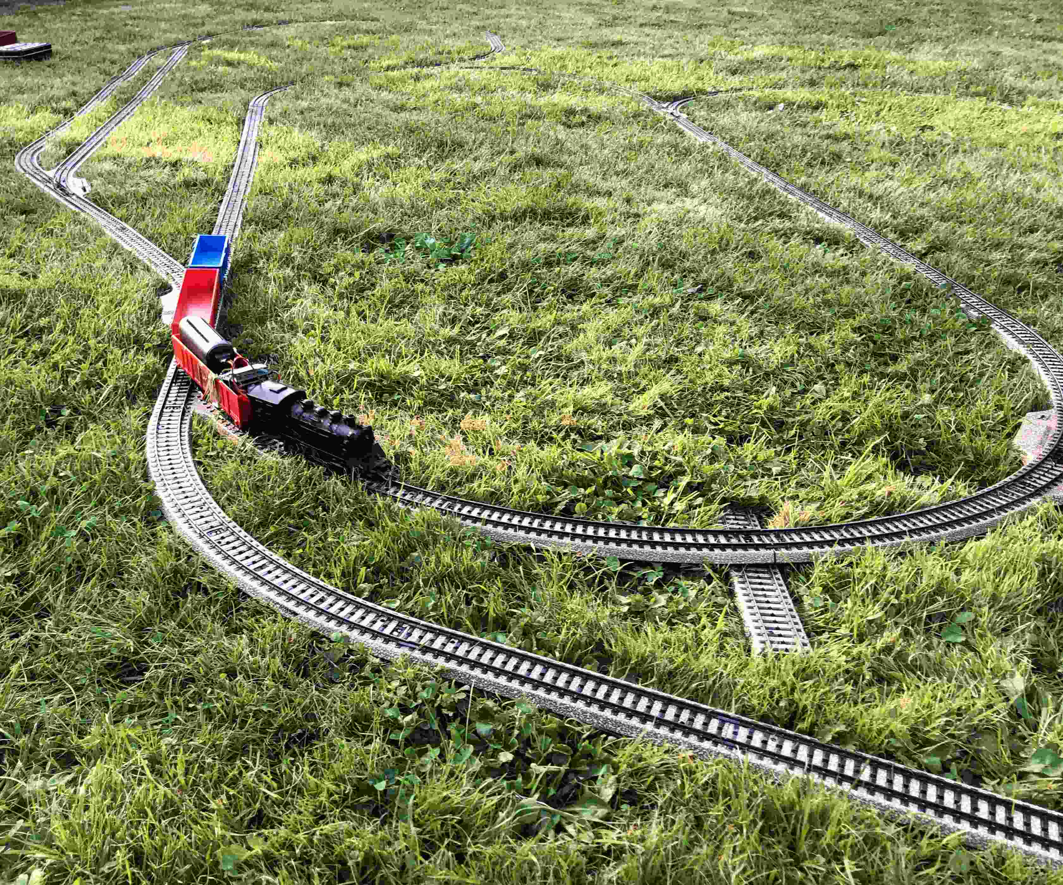
docs/PiedPiperS_244a.jpg
