jorail/PiedPiperS/docs/PiedPiperS_244c.jpg

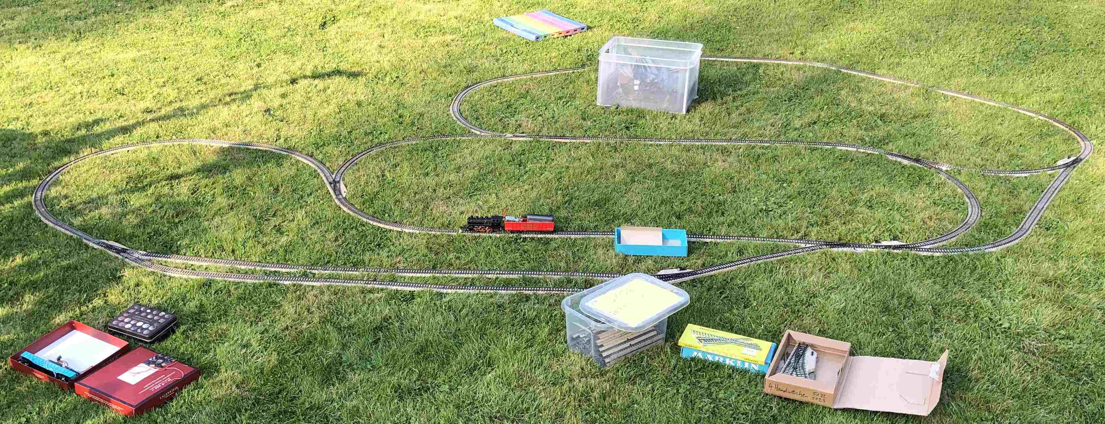
docs/PiedPiperS_244c.jpg
