jorail/PiedPiperS/PiedPiperS/add_data/image/002.jpg

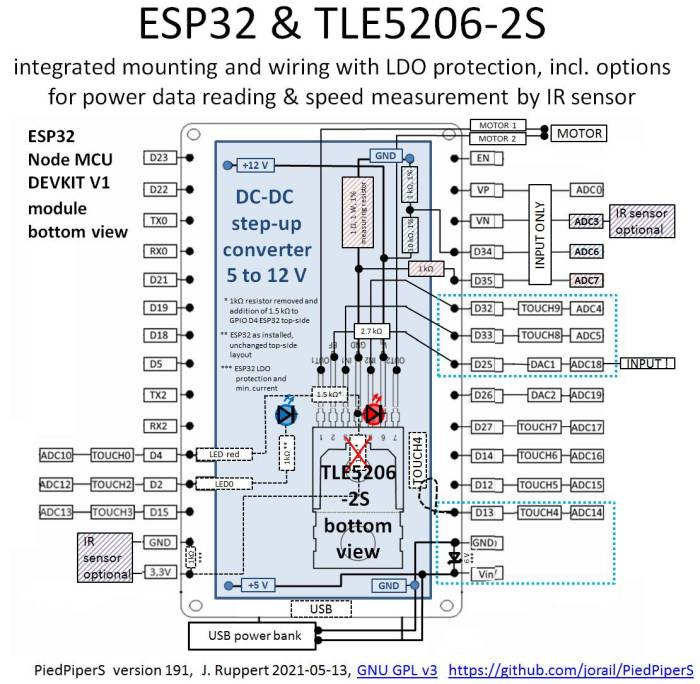
PiedPiperS/add_data/image/002.jpg
