jorail/PiedPiperS/PiedPiperS/add_data/image/005.jpg

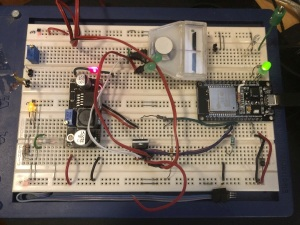
PiedPiperS/add_data/image/005.jpg
