jorail/PiedPiperS/PiedPiperS/add_data/image/006.jpg

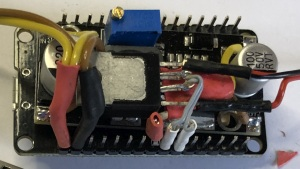
PiedPiperS/add_data/image/006.jpg
