jorail/PiedPiperS/PiedPiperS/add_data/image/007.jpg

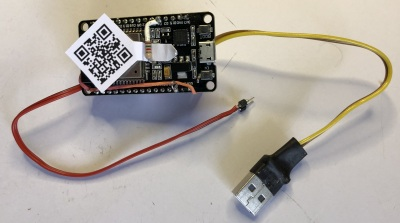
PiedPiperS/add_data/image/007.jpg
