jorail/PiedPiperS/PiedPiperS/add_data/image/009.jpg

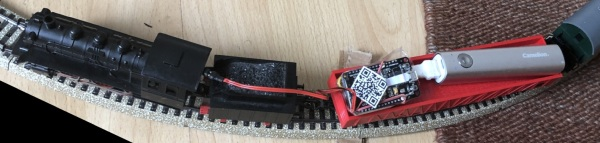
PiedPiperS/add_data/image/009.jpg
