jorail/PiedPiperS/PiedPiperS/add_data/IMG_7513-5.jpg

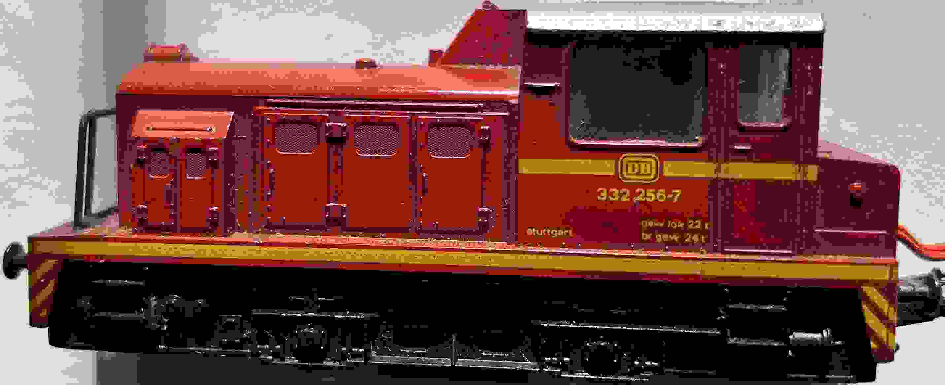
PiedPiperS/add_data/IMG_7513-5.jpg
