jorail/PiedPiperS/PiedPiperS/add_data/IMG_7513-5.png

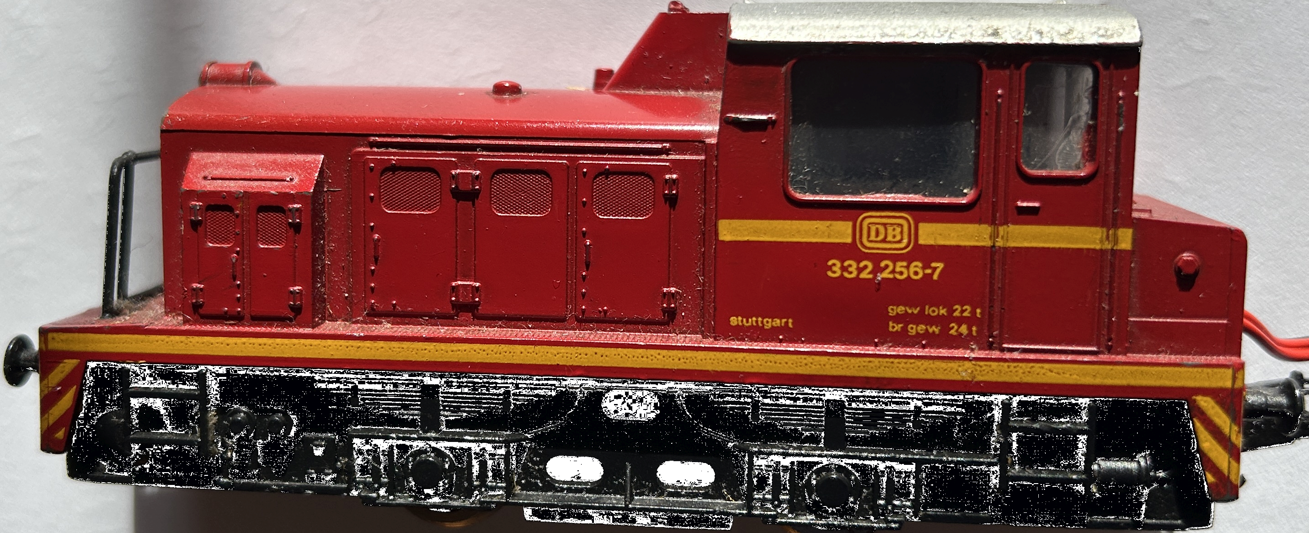
PiedPiperS/add_data/IMG_7513-5.png
