jorail/PiedPiperS/PiedPiperS/add_data/lok.png

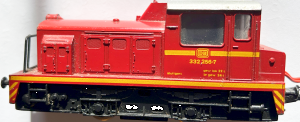
PiedPiperS/add_data/lok.png
