jorail/PiedPiperS/PiedPiperS/data/image/005.jpg

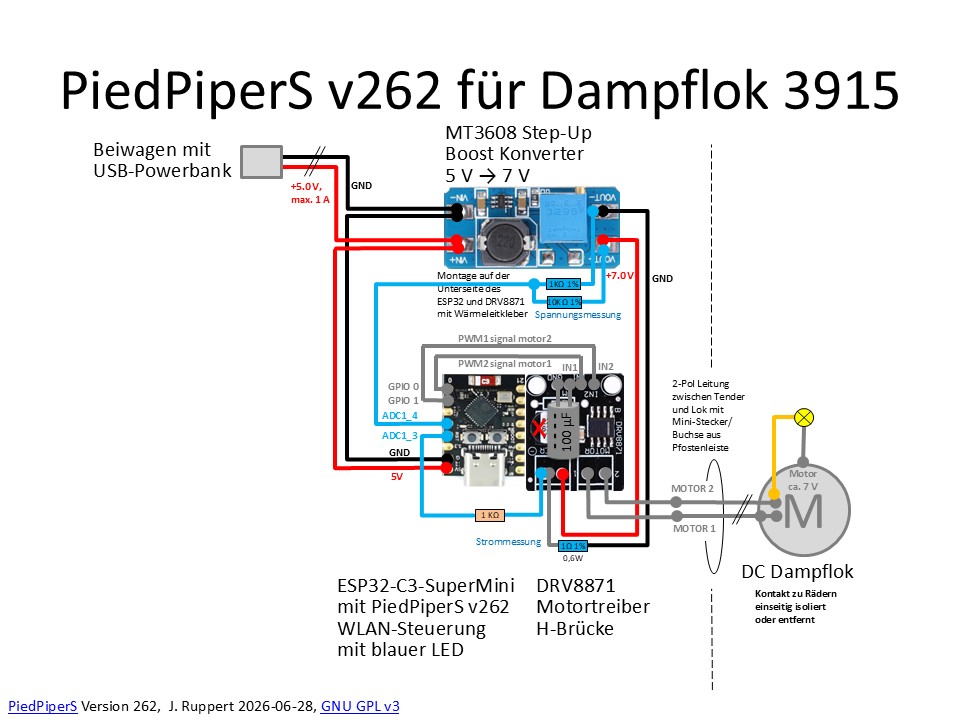
PiedPiperS/data/image/005.jpg
