jorail/PiedPiperS/PiedPiperS/data/image/006.jpg

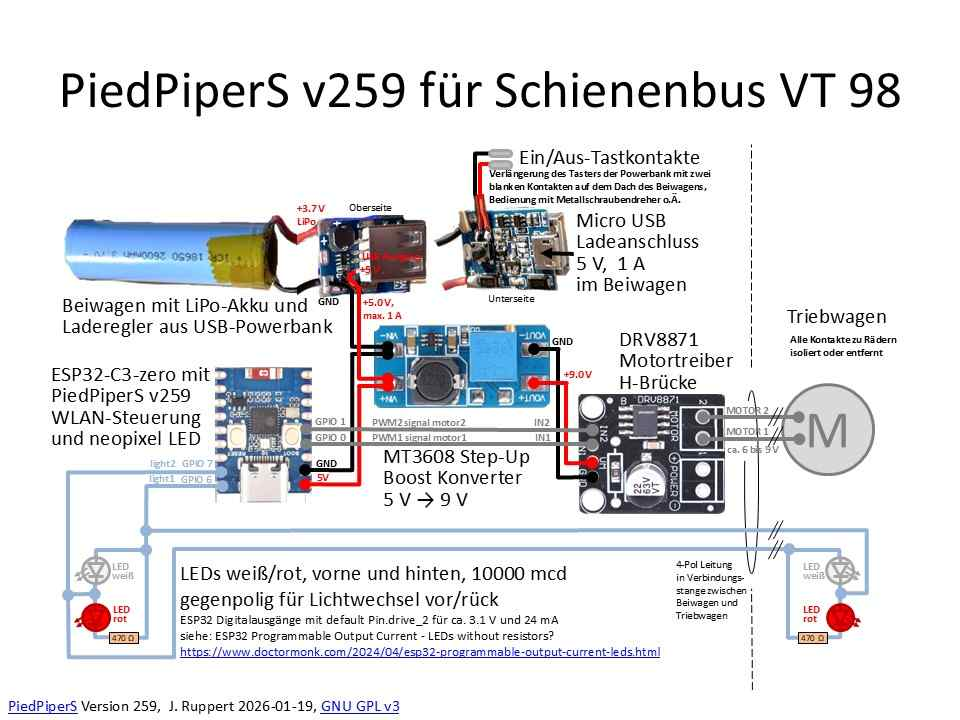
PiedPiperS/data/image/006.jpg
