jorail/PiedPiperS/PiedPiperS/data/image/007.jpg

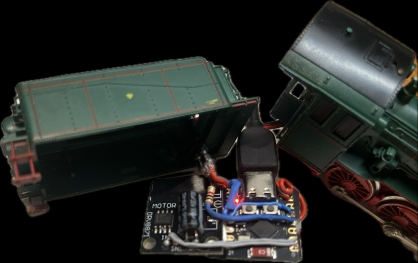
PiedPiperS/data/image/007.jpg
