jorail/PiedPiperS/PiedPiperS/data/image/008.jpg

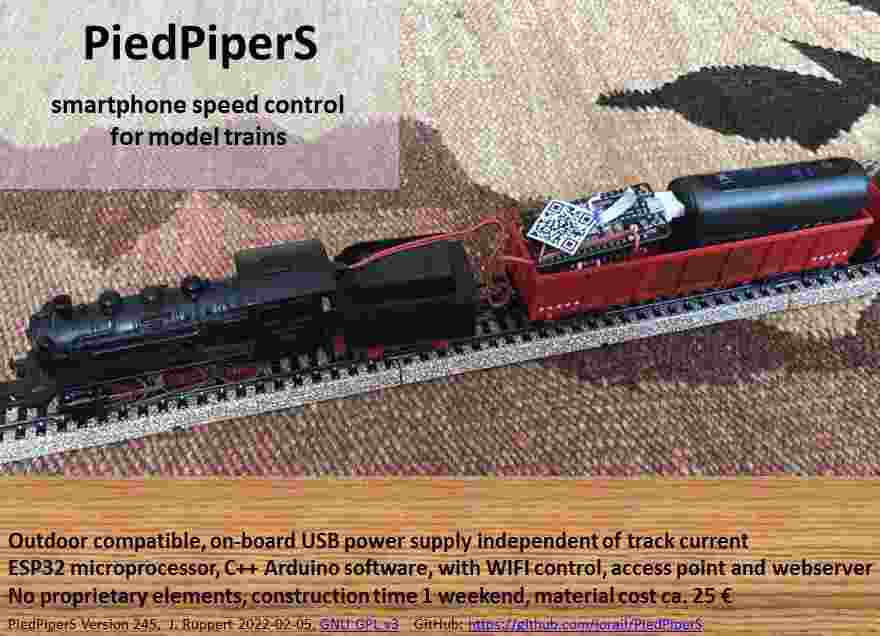
PiedPiperS/data/image/008.jpg
