jorail/PiedPiperS/PiedPiperS/data/qr_github.png

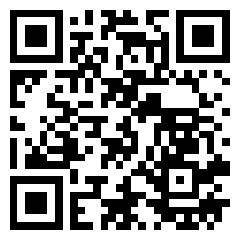
PiedPiperS/data/qr_github.png
