jorail/PiedPiperS/docs/PiedPiperS_175_Parts.jpg

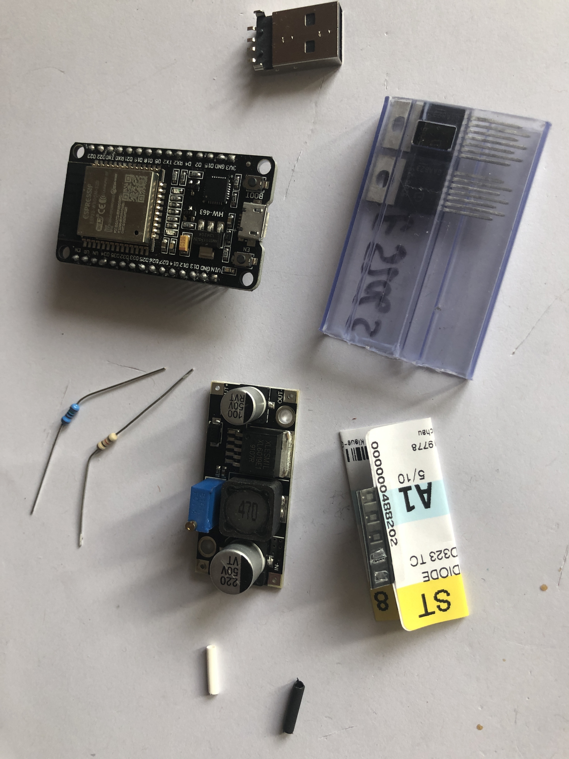
docs/PiedPiperS_175_Parts.jpg
