jorail/PiedPiperS/PiedPiperS_Instruction_v263_2026_07_04.pdf

# PiedPiperS

## smartphone speed control

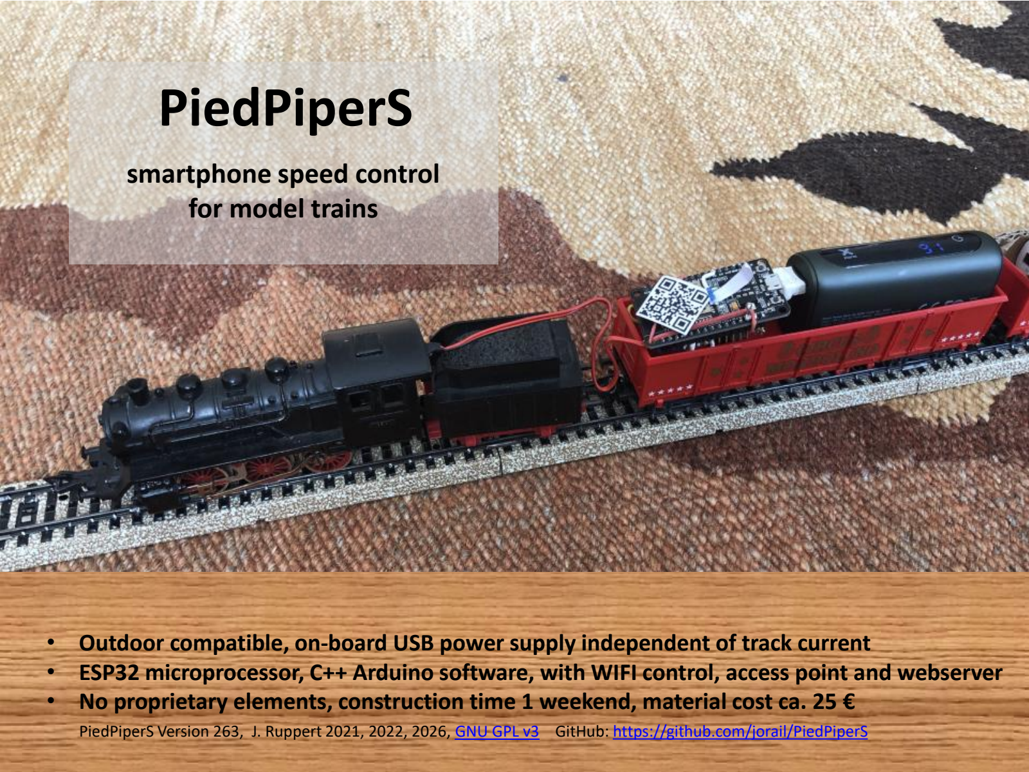
[picture p121: page 1]

## for model trains

## - Outdoor compatible, on-board USB power supply independent of track current

- ESP32 microprocessor, C++ Arduino software, with WIFI control, access point and webserver

## - No proprietary elements, construction time 1 weekend, material cost ca. 25 €

PiedPiperS Version 263, J. Ruppert 2021, 2022, 2026, GNU GPL v3 (https://www.gnu.org/licenses/gpl-3.0.en.html) GitHub: https://github.com/jorail/PiedPiperS

# PiedPiperS outdoor model train operation


PiedPiperS (https://github.com/jorail/PiedPiperS) Version 244, J. Ruppert 2021-09-05, GNU GPL v3 (https://www.gnu.org/licenses/gpl-3.0.en.html)


# Train control website on smartphone

## - Compatible with smartphones with WIFI - ESP32 WIFI access point mounted on train - Browser access to control panel via webserver - Stable WIFI remote control for up to two users on HTML website with addition of simple JavaScript functions

## - Option for online power measurement and data display in tables and charts

## - Option for true speed measurement by IR sensor detection of railway sleepers

## - Project information at additional HTML websites accessible via tap on loco image

PiedPiperS (https://github.com/jorail/PiedPiperS) Version 262, J. Ruppert 2026-06-30, GNU GPL v3 (https://www.gnu.org/licenses/gpl-3.0.en.html)

# PiedPiperS touch commands

Touch code | Command for speed level | Meaning
- | -- | decrease speed
•• | -------- | slow down
••• | -------------------------------- | brake to halt
•••• | 0 | fast brake and stop
••••• | 00< | fast stop, reverse direction
- ― | ++ | increase speed
- ― ― | ++++++++ | speed up
- ― ― ― | ++++++++++++++++ | go fast
― | 0 | fast brake and stop
― ― | 00 | fast brake and stop
| 00 | fast brake and stop
― ― ― | ? | info?

PiedPiperS (https://github.com/jorail/PiedPiperS) Version 244, J. Ruppert 2021-08-26, GNU GPL v3 (https://www.gnu.org/licenses/gpl-3.0.en.html)

# PiedPiper LED indicators

## LEDs

Information on motor direction and speedlevel 0 to 32: • forward = 1 = blue LED + 0 to 16 short LED flashes • backward = 0 = red LED + 0 to 16 short LED flashes

Adjustment of motor speed: • 2 blue LED flash = speed level + 2; • 2 red LED flash = speed level - 2; • green & red LEDs long flash = fast brake, speed level = 0

Change of motor direction: • blue/red/blue + blue LED flash = forward = 1 • red/blue/red + red LED flash = backward = 0

Program running and main loop frequency: • orange flash after 5,000 main loop cycles, 200 times monitoring for input activity and up to 5 speed adjustments

PiedPiperS (https://github.com/jorail/PiedPiperS) Version 244, J. Ruppert 2021-08-26, GNU GPL v3 (https://www.gnu.org/licenses/gpl-3.0.en.html)

# PiedPiperS integrated version

# https://github.com/jorail/PiedPiperS


PiedPiperS (https://github.com/jorail/PiedPiperS) Version 255, J. Ruppert 2026-01-06, GNU GPL v3 (https://www.gnu.org/licenses/gpl-3.0.en.html)

## ESP32 C3 SuperMini with PiedPiperS

v255

## DRV8871 motor IC MT3608 Step-up converter 5 to 7 V

## Power bank Step-up converter 3.7 to 5 V

## Air2Go USB Power bank internal 2600 mAh battery and USB charge controller

## Power turn on push button extension with blank solder ends

## GPIO 0&1 PWM signals

# PiedPiperS integrated version

# https://github.com/jorail/PiedPiperS


PiedPiperS (https://github.com/jorail/PiedPiperS) Version 255, J. Ruppert 2026-01-06, GNU GPL v3 (https://www.gnu.org/licenses/gpl-3.0.en.html)

## PWM gesteuerte Ausgangsspannung der H-Brücke für Motorregelung

# PiedPiperS v259 für Schienenbus VT 98

## Ein/Aus-Tastkontakte

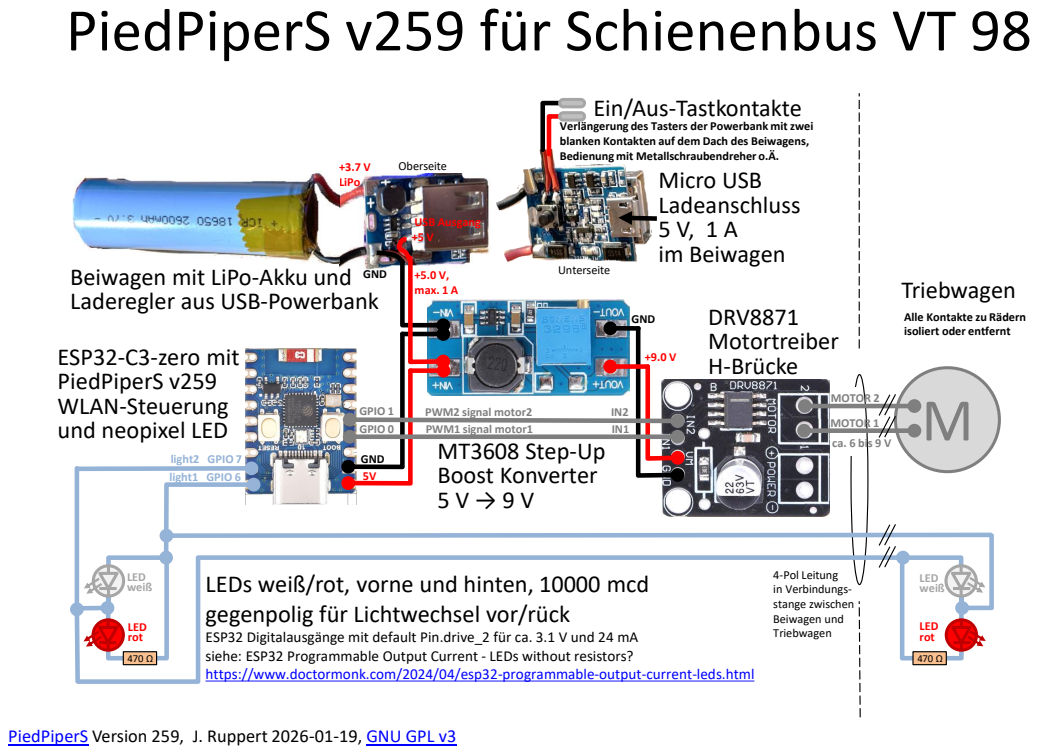
[picture p122: page 8]
GPIO 1 GPIO 0; GND 5V; PWM2 PWM1; signal signal; motor2 motor1; +5.0 V, max. 1 A; USB Ausgang +5 V; GND; +3.7 V LiPo; GPIO 7 GPIO 6; MOTOR 2; MOTOR 1; Micro USB Ladeanschluss 5 V, 1 A im Beiwagen; light2 light1; LED weiß; LED rot; ca. 6 bis 9 V; 4-Pol Leitung in Verbindungs- stange zwischen Beiwagen und Triebwagen; Triebwagen; DRV8871 Motortreiber H-Brücke; MT3608 Step-Up Boost Konverter 5 V → 9 V; Oberseite; Unterseite

Verlängerung des Tasters der Powerbank mit zwei
blanken Kontakten auf dem Dach des Beiwagens,
Bedienung mit Metallschraubendreher o.Ä.

Beiwagen mit LiPo-Akku und
Laderegler aus USB-Powerbank

Alle Kontakte zu Rädern
isoliert oder entfernt

ESP32-C3-zero mit
PiedPiperS v259
WLAN-Steuerung
und neopixel LED

LEDs weiß/rot, vorne und hinten, 10000 mcd
gegenpolig für Lichtwechsel vor/rück
ESP32 Digitalausgänge mit default Pin.drive_2 für ca. 3.1 V und 24 mA
siehe: ESP32 Programmable Output Current - LEDs without resistors?
https://www.doctormonk.com/2024/04/esp32-programmable-output-current-leds.html

PiedPiperS (https://github.com/jorail/PiedPiperS) Version 259, J. Ruppert 2026-01-19, GNU GPL v3 (https://www.gnu.org/licenses/gpl-3.0.en.html)

# Schienenbus VT98 Beiwagen LiPo Akku und Steuerung eingebaut


PiedPiperS (https://github.com/jorail/PiedPiperS) Version 259, J. Ruppert 2026-01-18, GNU GPL v3 (https://www.gnu.org/licenses/gpl-3.0.en.html)

## Micro USB Ladeanschluss im Beiwagen

## 4-Pol Kabeldurchführung zum Triebwagen

## Step-up Konverter mit Spannungseinstellung

## Motortreiber

## ESP32-c3

## Helle LEDs weiß/rot für Lichtwechsel

# Stirnlichter

# LED weiß/rot gegenpolig und mit Vorwiderstand für rote LED


470 Ω

LED
weiß

LED
rot

Vorwiderstand an LED-Typen anpassen: hier für ca. 3.1 V weiße LED 3,6 V ohne, und
rote LED 2,2 V mit 470 Ω

Lampenkontakte können
als Lötfahnen für den
LED-Einsatz genutzt
werden.

PiedPiperS (https://github.com/jorail/PiedPiperS) Version 259, J. Ruppert 2026-01-18, GNU GPL v3 (https://www.gnu.org/licenses/gpl-3.0.en.html)

# Schienenbus VT98 Triebwagen

# mit isolierten Radkontakten und LED-Beleuchtung


PiedPiperS (https://github.com/jorail/PiedPiperS) Version 259, J. Ruppert 2026-01-18, GNU GPL v3 (https://www.gnu.org/licenses/gpl-3.0.en.html)

# Schienenbus VT98 Beiwagen

# An/Aus durch Tastkontakt auf dem Dach

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

Kompakte und simple
Bedienung An/Aus
von außen mit jedem
Strom leitenden
Gegenstand möglich


# PiedPiperS v263 für Dampflok 3915

## MT3608 Step-Up

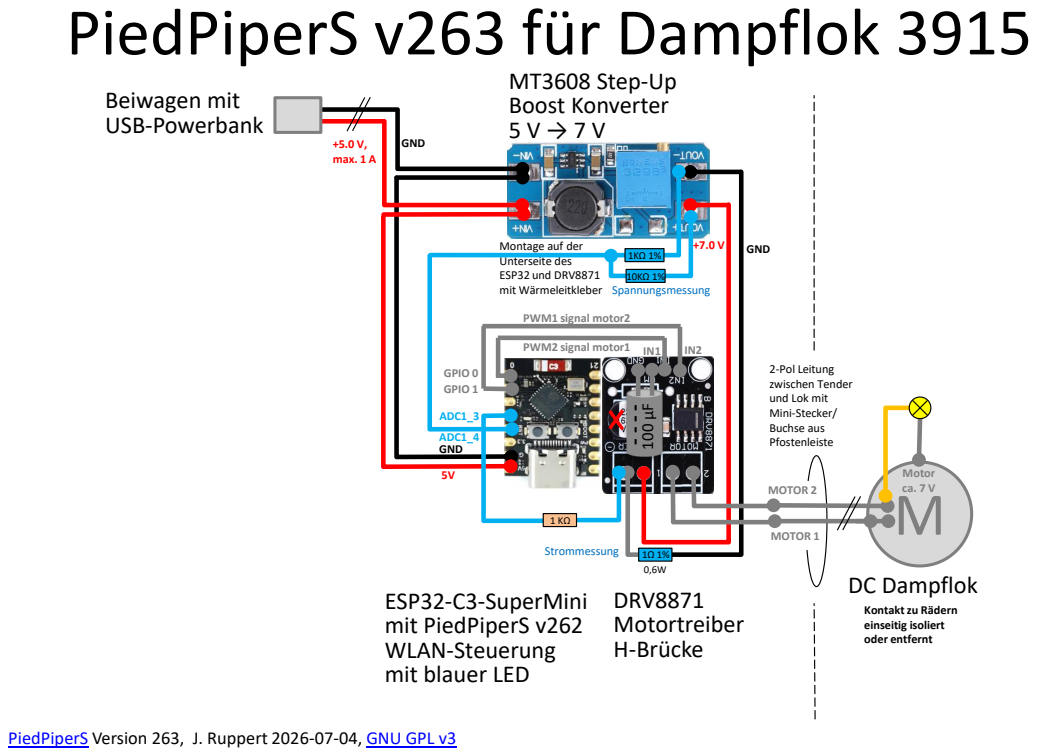
[picture p123: page 14]
GPIO 1; GPIO 0; GND; PWM2 signal motor1; PWM1 signal motor2; +5.0 V, max. 1 A; MOTOR 2; MOTOR 1; DC Dampflok DRV8871; Motortreiber H-Brücke; Boost Konverter 5 V → 7 V; Beiwagen mit USB-Powerbank; ADC1_3; ADC1_4; Strommessung; Spannungsmessung; Motor ca. 7 V

Montage auf der
Unterseite des
ESP32 und DRV8871
mit Wärmeleitkleber

2-Pol Leitung
zwischen Tender
und Lok mit
Mini-Stecker/
Buchse aus
Pfostenleiste

ESP32-C3-SuperMini
mit PiedPiperS v262
WLAN-Steuerung
mit blauer LED

Kontakt zu Rädern
einseitig isoliert
oder entfernt

PiedPiperS (https://github.com/jorail/PiedPiperS) Version 263, J. Ruppert 2026-07-04, GNU GPL v3 (https://www.gnu.org/licenses/gpl-3.0.en.html)

# PiedPiperS v262 für Dampflok 3915

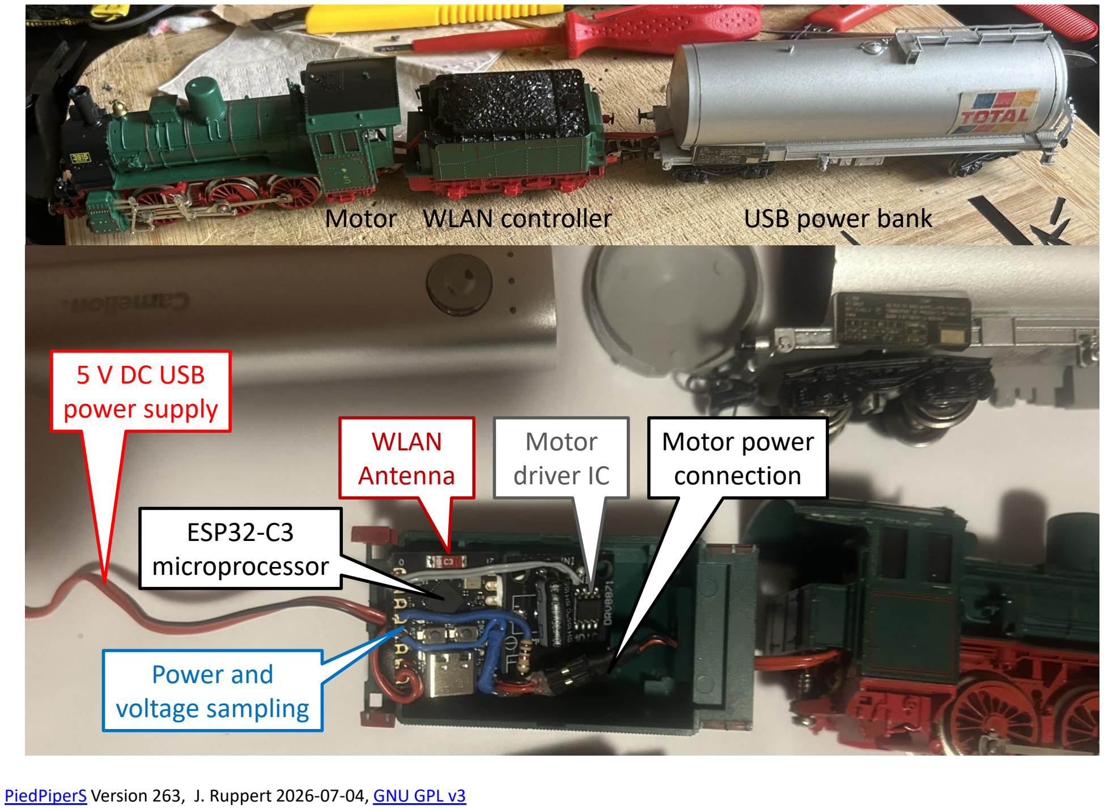
[picture p124: page 15]

PiedPiperS (https://github.com/jorail/PiedPiperS) Version 263, J. Ruppert 2026-07-04, GNU GPL v3 (https://www.gnu.org/licenses/gpl-3.0.en.html)

## WLAN Antenna

## Motor driver IC

## Power and voltage sampling

## 5 V DC USB power supply Motor power connection

Motor WLAN controller | USB power bank

## ESP32-C3 microprocessor

# PiedPiperS project development

# https://github.com/jorail/PiedPiperS

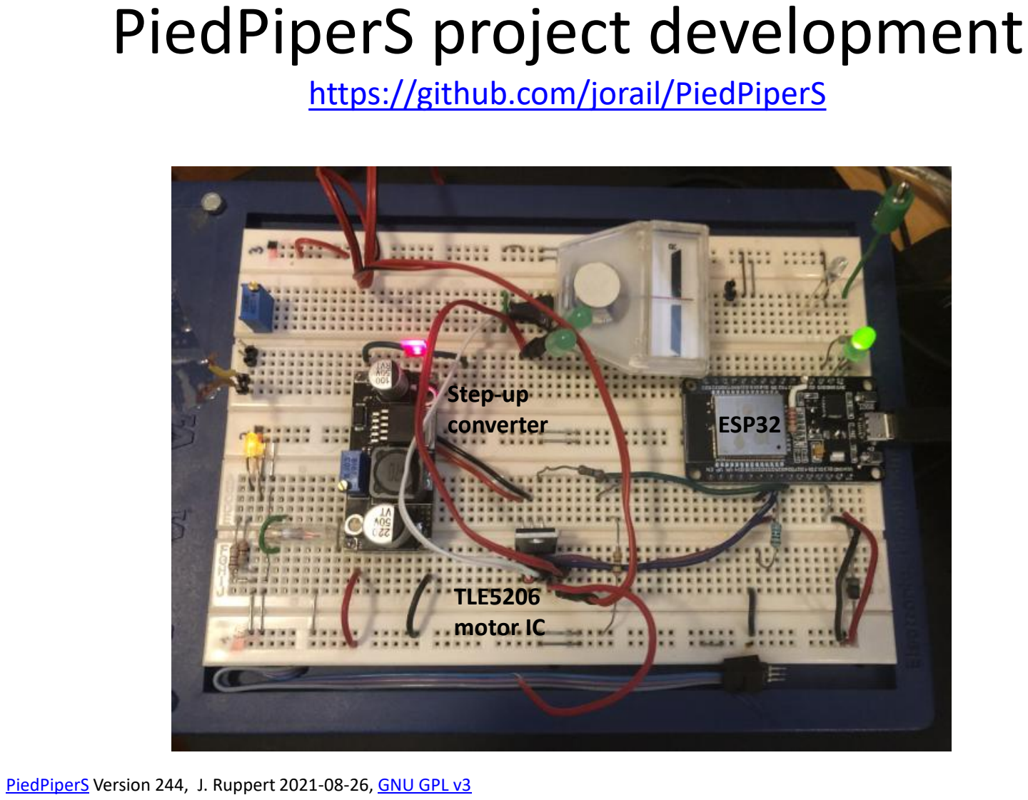
[picture p125: page 16]

## ESP32

## TLE5206 motor IC

## Step-up converter

PiedPiperS (https://github.com/jorail/PiedPiperS) Version 244, J. Ruppert 2021-08-26, GNU GPL v3 (https://www.gnu.org/licenses/gpl-3.0.en.html)

# Material demand

# for 1 train with WiFi control

## Electronics

- Nano size microcontroller with WiFi e.g. ESP32 DevKit V1, etc.
– | 2 PWM outputs for motor control
– | 2 digital outputs for LED indicators
– | 1 digital input for touch switch
– | 1 digital input for motor IC error flag
- Step-up DC/DC converter module, 5 V to 12V … 16 V
- H-Bridge DC motor control IC, e.g. TLE5206-2S
- Small size USB power bank as 5 V DC power supply
it is good to have two, 2nd for replacement when 1st empty
- Shrink tube with diameter for holding two IC pin contacts
- Thick USB cable, old and used, but reliable for power connection with small voltage drop
- Reuse of 2 on-board LEDs , by soldering 1.5 KΩ resistor from pin
(or alternatively LEDs: 1 blue, 1 red, 3 mm diameter plus 2 x 1.5 KΩ resistors)
- 2.7 kΩ resistor, protection for digital input
- 1 kΩ SMD resistor as artificial load after LDO
- 1 SMD TVS-diode, 5 V reverse working (standoff) voltage as protection of 5 V input from peak voltages of the Step-up converter
- 2 pole cable, thin and flexible, ca. 40 cm, for connection to motor
- 1 pole wires for breadboard and step up converter connections, ca. 20 cm in total

## Other material

- Model train locomotive with 12V … 16 V DC motor
- Flat wagon for electronics equipment
- Eaos high board open wagon for USB power bank
- Some paper cardboard
- Single and double sided adhesive tape

## Tools

- Very fine tip solder iron with equipment
- Cutter, fine pincers
- Multi-meter tool

## Option 1 addition

- ESP32 DevKit V1
– 2 analog inputs for voltage and current readings
- Measuring resistors 1 Ω, 1 kΩ, 10 kΩ, tolerance 1%
- 1 kΩ resistor, protection for analog input

## Option 2 addition

- ESP32 DevKit V1
– 1 analog input for amplified IR sensor voltage reading
- Suitable reflective IR sensor
- IR LED resistor
- Signal amplifier with small transistor and pullup resistor

Estimated material cost ca. 25 € excl. other material, tools and optional additions
More detailed information on electronic parts: https://github.com/jorail/PiedPiperS/blob/main/PiedPiperS/data/parts.html

PiedPiper Version 100, 175, 244 J. Ruppert 2021-08-27 GNU GPL v3 (https://www.gnu.org/licenses/gpl-3.0.en.html) https://github.com/jorail/PiedPiperS

# PiedPiperS-Bauteile 1/3

# Materialbedarf für einen Zug mit WLAN-Steuerung

## - Mikrocontroller mit WLAN, z.B. ESP32 Node MCU DevKit V1, oder anderer

– 2 PWM-Ausgänge für die Motorsteuerung mit TLE5206-2S und ESP32: GPIO 32 und GPIO 33 – 2 digital Ausgänge für die LED-Anzeigen, ESP32: GPIO 2 und GPIO 4 – 1 digitaler Eingang als Morse-Schalter, ESP32: Berührungssensor GPIO 13=TOUCH 4 – 1 digitaler Eingang für Fehleranzeige des Motor-ICs, ESP32: GPIO 25

## - Step-up DC/DC-Konverter-Modul, 5 V auf 8 V bis 16 V - IC mit H-Brücke zur Steuerung eines Gleichstrommotors, z.B. TLE5206-2S

- Kleine USB-Powerbank als 5 V DC Stromquelle. Es ist gut, 2 davon zu haben, die 2.

als Ersatz, wenn die 1. leer ist. Der WLAN-Betrieb des ESP32 Mikrocontrollers benötigt beim Start und zeitweise bis zu 600 mA Stromversorgung. 5 W Leistung aus einer klassischen kleinen USB-Powerbank (siehe Abbildung) sind für kleinere Lokomotiven und effiziente Gleichstrommotoren geeignet. Bei großen H0-Modellbahnlokomotiven oder bei Modellen mit älteren Motoren sind diese meist nicht ausreichend. Eine etwas teurere, kompakte USB-C-Powerbank für die Schnellladung mit ca. 15 W Leistung und 2 bis 3 A Stromquelle hat sich für diese Lokomotiven als ausreichend und im langen Fahrbetrieb als sehr gut geeignet

erwiesen.

# PiedPiperS-Bauteile 2/3

# Materialbedarf für einen Zug mit WLAN-Steuerung

Elektronik-Bauteile für ESP32-Modifikation - TVS-Diode mit 5 V-Arbeitsspannung (reverse standoff voltage) zum Schutz des 5 V Eingangs des Mikroprozessors vor Spannungsspitzen aus dem Step-up-Konverter - 1 kΩ SMD-Widerstand als künstliche Last nach dem Spannungsregler, kann nach sehr vorsichtigemen Auslöten eines Widerstands aus dem ESP32 Node MCU DevKit V1 wieder verwendet werden - Nutzung von 2 on-board SMD-LEDs durch einlöten eines 1,5 kΩ

Widerstands von GPIO 4 (alternativ zwei 3 mm LEDs: 1 blau, 1 rot,

# plus 2 x 1,5 kΩ Widerstände)

# Die Bauanleitung mit Fotos für das PiedPiperS-Projekt liegt im Internet unter https://github.com/jorail

# PiedPiperS-Bauteile 3/3

# Materialbedarf für einen Zug mit WLAN-Steuerung

Elektronik-Bauteile - 2,7 oder 1,0 kΩ Widerstand für die Übertragung des Fehlersignals vom Motro-IC - 2-poliges Kabel, dick, ca. 20 cm, 0,25 mm² Litze, für die Stromzufuhr mit bis zu 2,5 A von der USB-Powerbank mit wenig Spannungs- und Leistungsverlust der 5 V-Spannungsquelle Alternativ: USB-Kabel, ggf. alt und gebraucht, aber mit dicken Leitern (American wire gauge, AWG 22, 23 oder 24) und zuverlässig für die Stromverbindung mit geringem Spannungsverlust - USB-2.0 Typ A Stecker, möglichst kurz und mit Lötfahnen - 2-poliges Kabel, dünn und flexibel, ca. 30 cm, für die Verbindung zum Motor. Bei eine Versorgungsspannung für den Lokmotor von ca. 12 V sind Leiterquerschnitte

einer 0,14 mm² Litze ausreichend.

- 2 x 2-Pol-IC-Kontakte zum Selbstbau einer einfachen und sehr kleinen Steckverbindung in der Zuleitung zum Motor, kann einerseits als Stecker und andererseits als Buchse in die Doppellitze eingelötet werden und passt zur Stromstärke bis 1 A - Schrumpfschlauch, verschiedene Größen, u.a. mit einem Durchmesser, um 2-Pol-IC-Kontakte aufzunehmen

# PiedPiperS - Weitere Materialien

# Materialbedarf für einen Zug mit WLAN-Steuerung

- Modellbahn-Lokomotive mit 10 V bis 24 V Gleichstrommotor - Flachwagen für die elektronischen Bauteile - Eaos Hochbord offener Güterwagen für USB-Powerbank - Etwas weiße Pappe für den QR-Code - Einfaches und doppelseitiges Klebeband - Etwas Klebstoff - Ein Haushaltsgummi - USB-Datenkabel für die Programmierung des ESP32 Mikroprozessors

# PiedPiperS - Werkzeuge

# Materialbedarf für einen Zug mit WLAN-Steuerung

- Lötkolben mit sehr feiner Spitze, feiner Lötdraht und Zubehör - Schneidmesser - Seitenschneider - Werkzeug zum Abisolieren - Feine Flachzange - Feine Spitzzange - Spitze Pinzette für SMD-Lötarbeiten - Lupe für SMD-Lötarbeiten - Elektronik-Steckbrett für einen Test-Aufbau oder für eine Umsetzung der Schaltung ohne Löten. Ein kleines Steckbrett mit 170 Kontakten passt auf einen HO Modellbahnwagon. Siehe hierzu das PiedPiper-Projekt - Multimeter

# Main electronic parts

## USB A

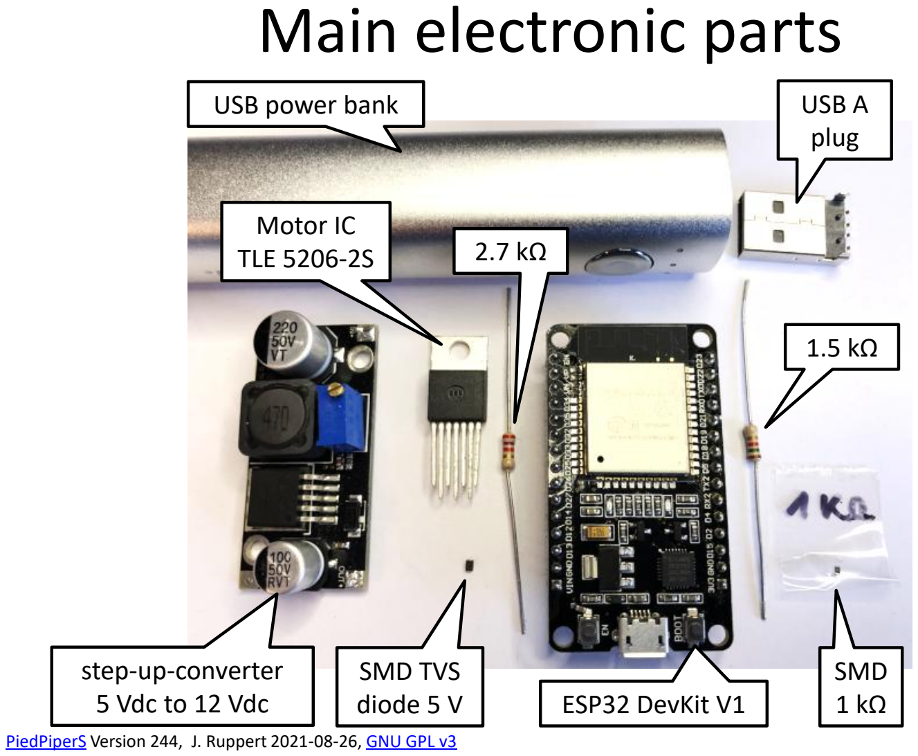
[picture p126: page 23]

## Motor IC TLE 5206-2S

1.5 kΩ

2.7 kΩ

## step-up-converter 5 Vdc to 12 Vdc

## plug

## USB power bank

## SMD TVS diode 5 V

## SMD

ESP32 DevKit V1 | 1 kΩ

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

# ESP32 & TLE5206-2S

## integrated mounting and wiring with LDO protection, v100

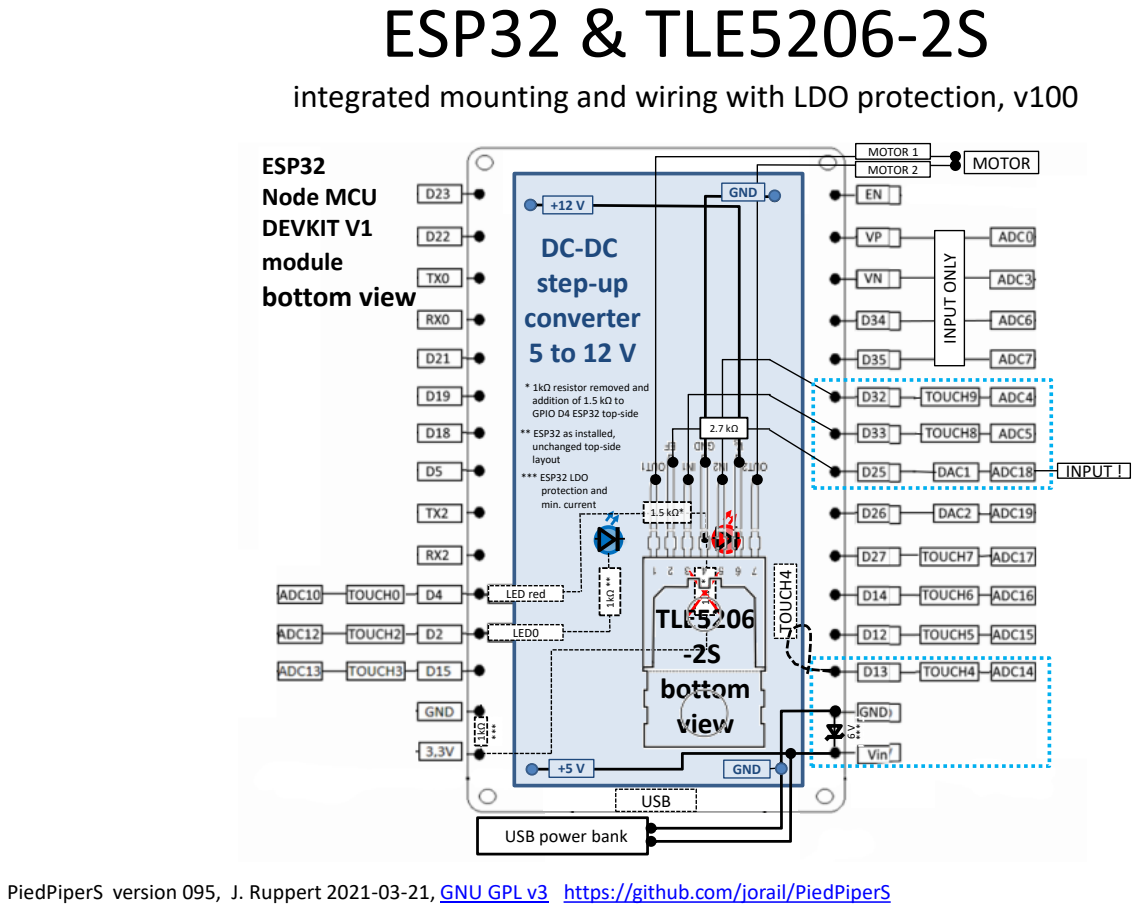
[picture p127: page 24]
ESP32 Node MCU DEVKIT V1 module bottom view; MOTOR; LED0; LED red; GND; DC-DC step-up converter 5 to 12 V1kΩ **; TOUCH4; INPUT ONLY; TLE5206 -2S bottom view; INPUT !; MOTOR 1 MOTOR 2; USB

* 1kΩ resistor removed and
addition of 1.5 kΩ to
GPIO D4 ESP32 top-side
** ESP32 as installed,
unchanged top-side
layout
*** ESP32 LDO
protection and
min. current

USB power bank

PiedPiperS version 095, J. Ruppert 2021-03-21, GNU GPL v3 (https://www.gnu.org/licenses/gpl-3.0.en.html) https://github.com/jorail/PiedPiperS

# Required tools

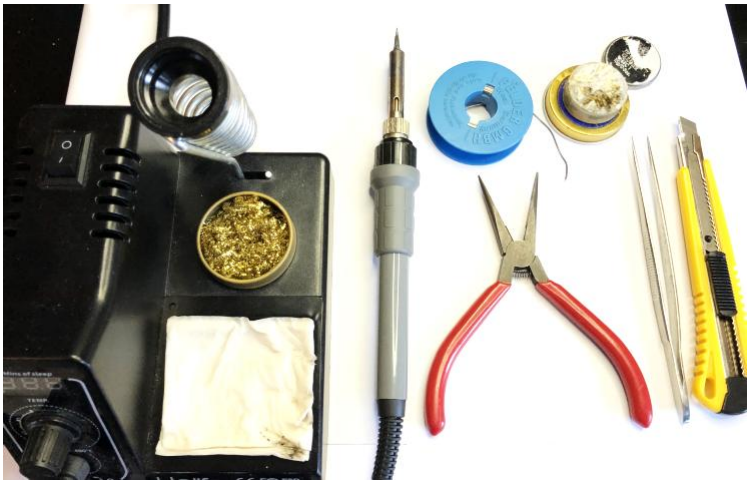
[picture p128: figure]
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

# Material for ESP32 topside adjustment

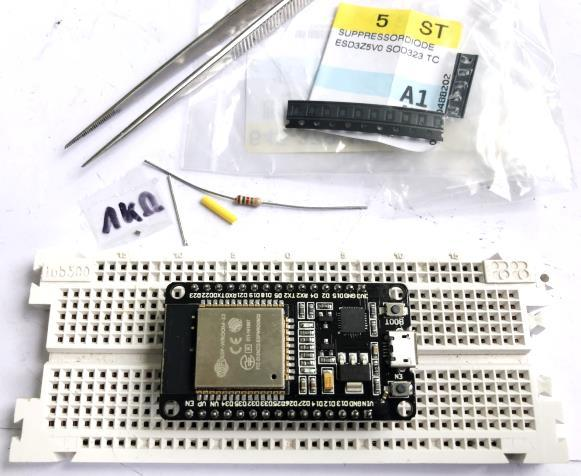
[picture p129: figure]
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

# SMD resistor and TVS diode at power pins

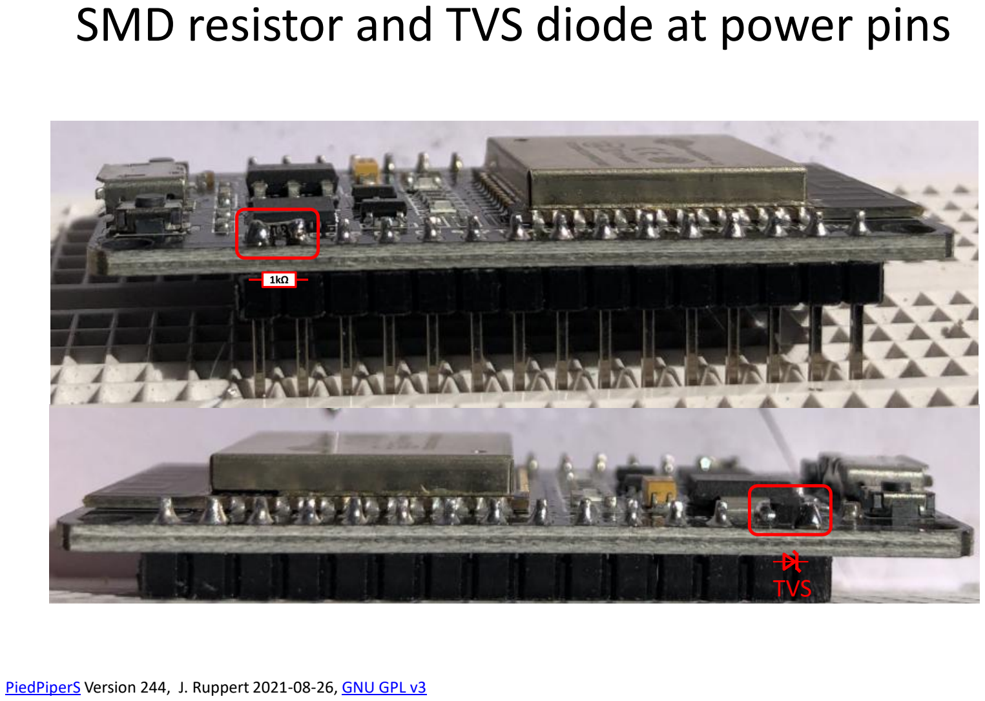
[picture p130: page 27]

## TVS

1kΩ

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

# Protecting ESP32 for power supply from USB power bank linked to step-up-converter

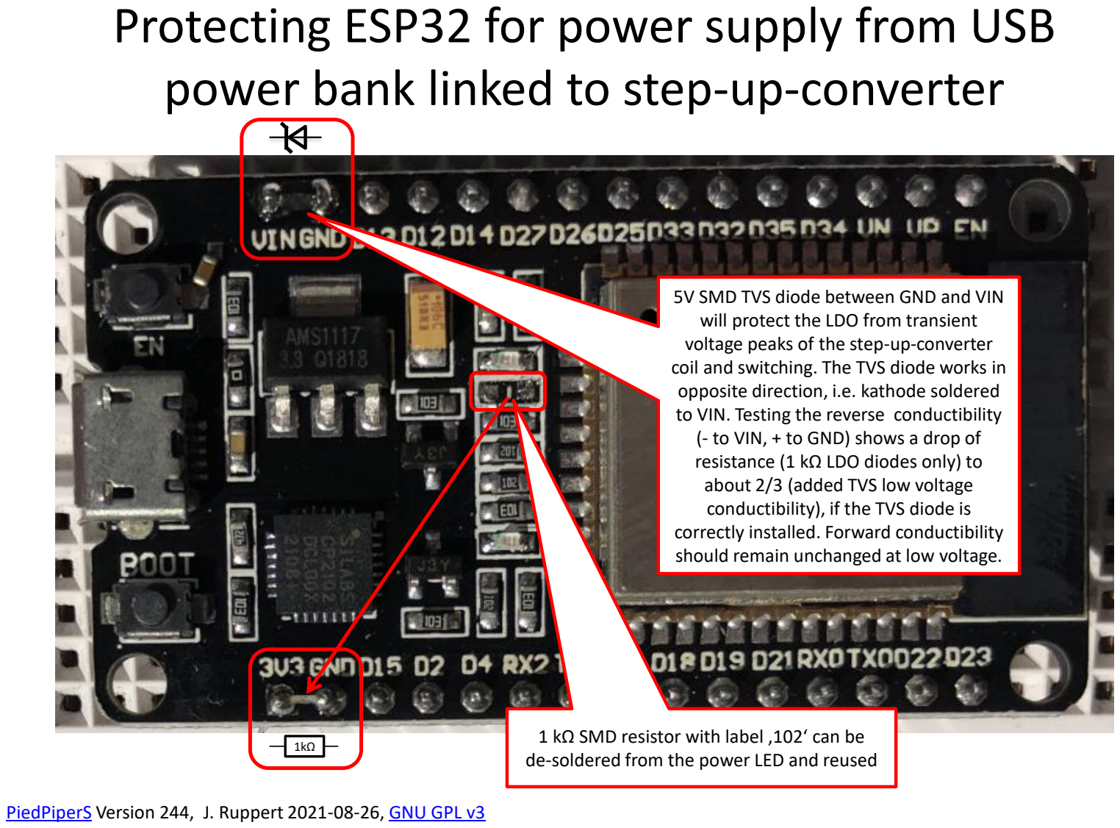
[picture p131: page 28]

5V SMD TVS diode between GND and VIN will protect the LDO from transient voltage peaks of the step-up-converter coil and switching. The TVS diode works in opposite direction, i.e. kathode soldered to VIN. Testing the reverse conductibility (- to VIN, + to GND) shows a drop of resistance (1 kΩ LDO diodes only) to about 2/3 (added TVS low voltage conductibility), if the TVS diode is correctly installed. Forward conductibility should remain unchanged at low voltage.

1kΩ | 1 kΩ SMD resistor with label ‚102‘ can be de-soldered from the power LED and reused

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

# Solder SMD elements at 5 V input and 3.3 V output

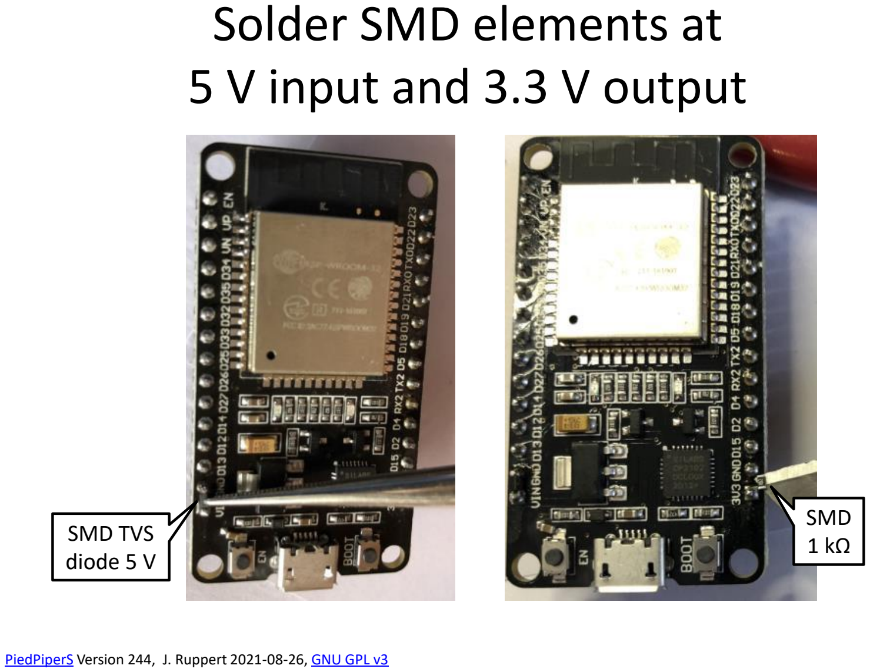
[picture p132: page 29]

## SMD

1 kΩ

## SMD TVS diode 5 V

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

# Soldering 1 kΩ resistor assuring LDO load and protection

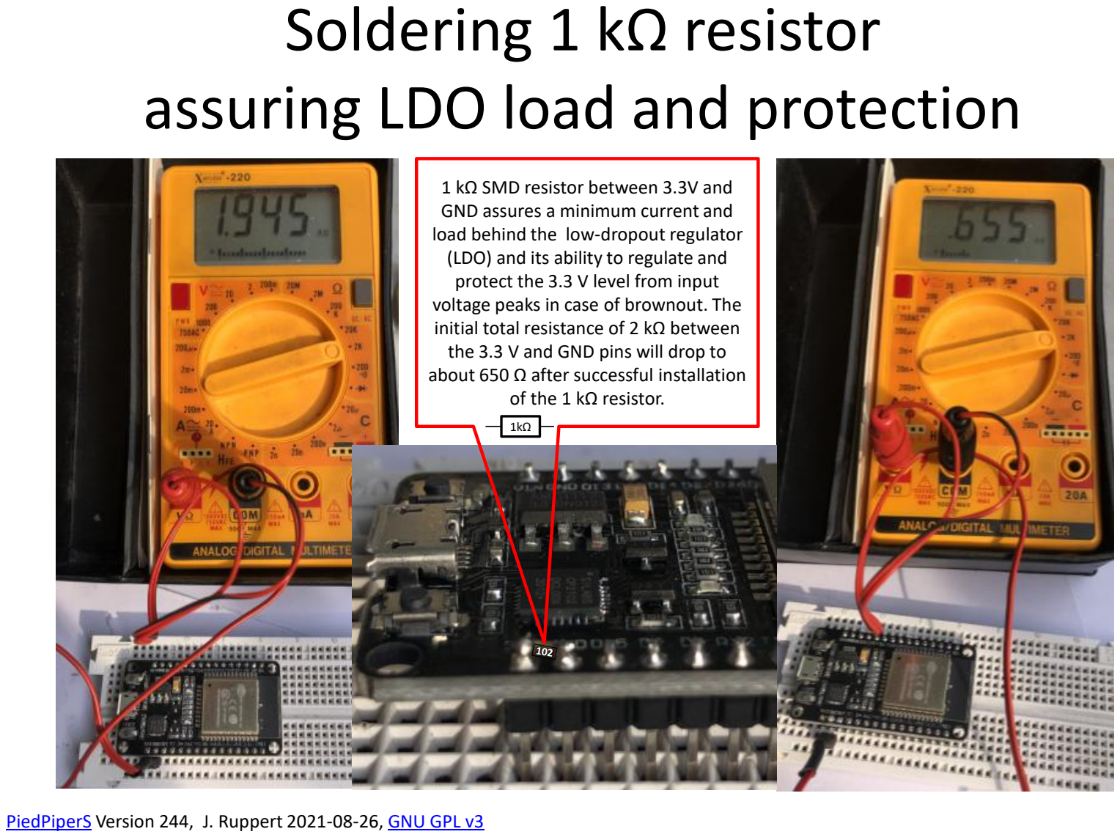
[picture p133: page 30]

1 kΩ SMD resistor between 3.3V and GND assures a minimum current and load behind the low-dropout regulator (LDO) and its ability to regulate and protect the 3.3 V level from input voltage peaks in case of brownout. The initial total resistance of 2 kΩ between the 3.3 V and GND pins will drop to about 650 Ω after successful installation of the 1 kΩ resistor.

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

1kΩ

# Connecting red LED to GPIO pin D4

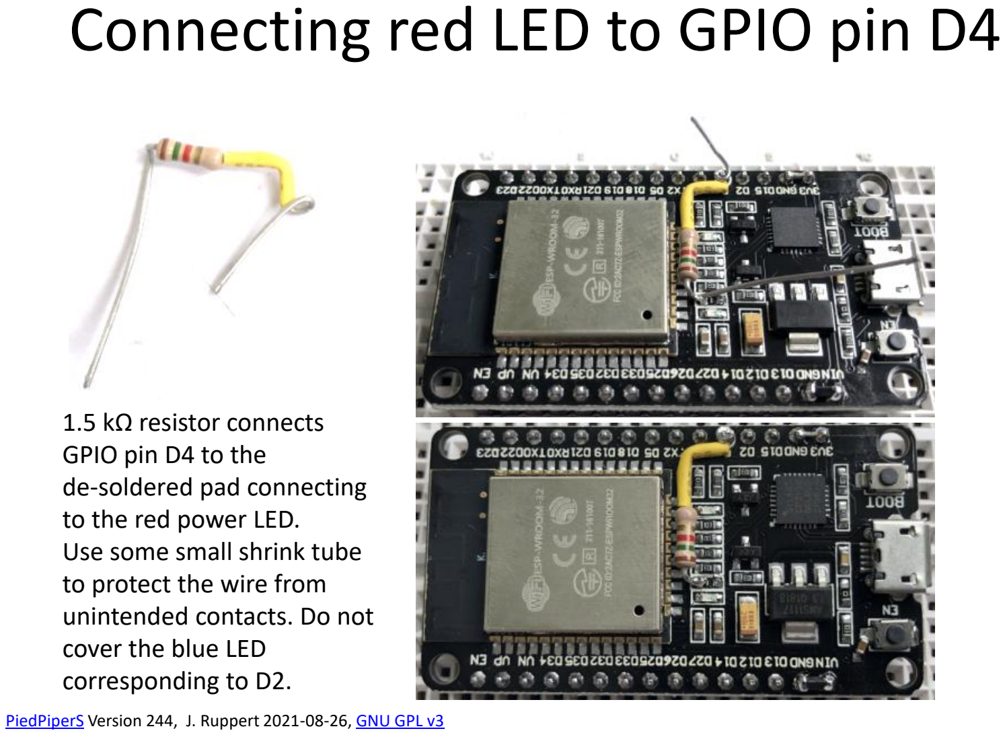
[picture p134: page 31]

## 1.5 kΩ resistor connects GPIO pin D4 to the de-soldered pad connecting

to the red power LED.

## Use some small shrink tube to protect the wire from unintended contacts. Do not cover the blue LED

corresponding to D2.

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

# Installing a manual Touch input

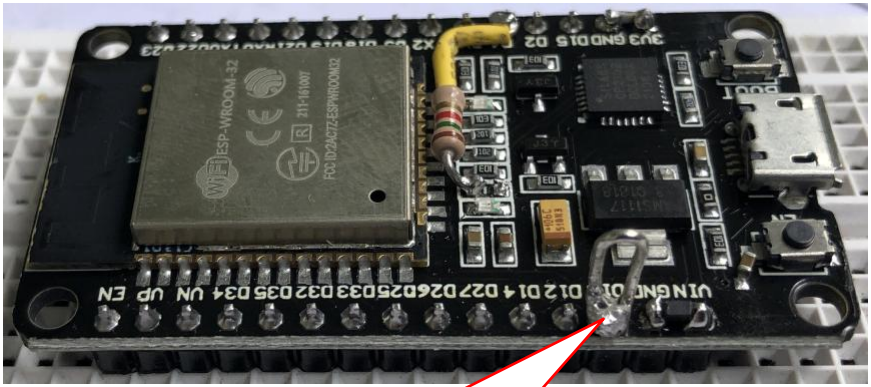
[picture p135: figure]

Solder a very small loop of strong wire to GPIO pin D13 as TOUCH4 input for manual commands to the model train (instead of a manual switch)

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

# ESP32 DEVKIT V1 top view

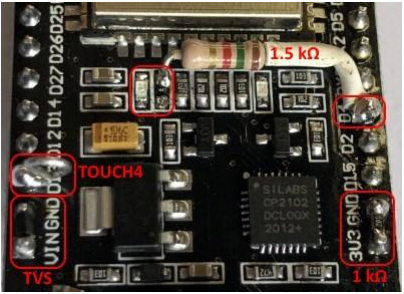
[picture p136: figure]

## - power LED modification by 1.5 kΩ resistor to D4 pin - TOUCH4 pin wire loop - TVS diode 5 V and load by 1 kΩ resistor at 3.3 V for LDO protection

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

# Materials for motor control

# step-up-converter and motor IC fitting at ESP32 bottom

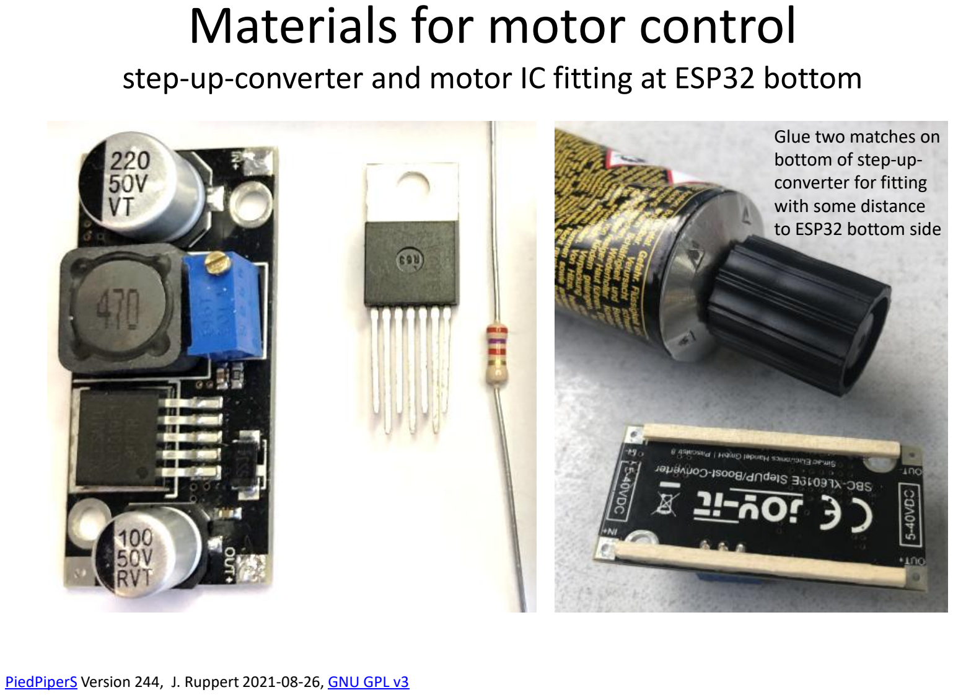
[picture p137: page 34]

Glue two matches on
bottom of step-upconverter for fitting
with some distance
to ESP32 bottom side

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

# Mounting motor power control IC

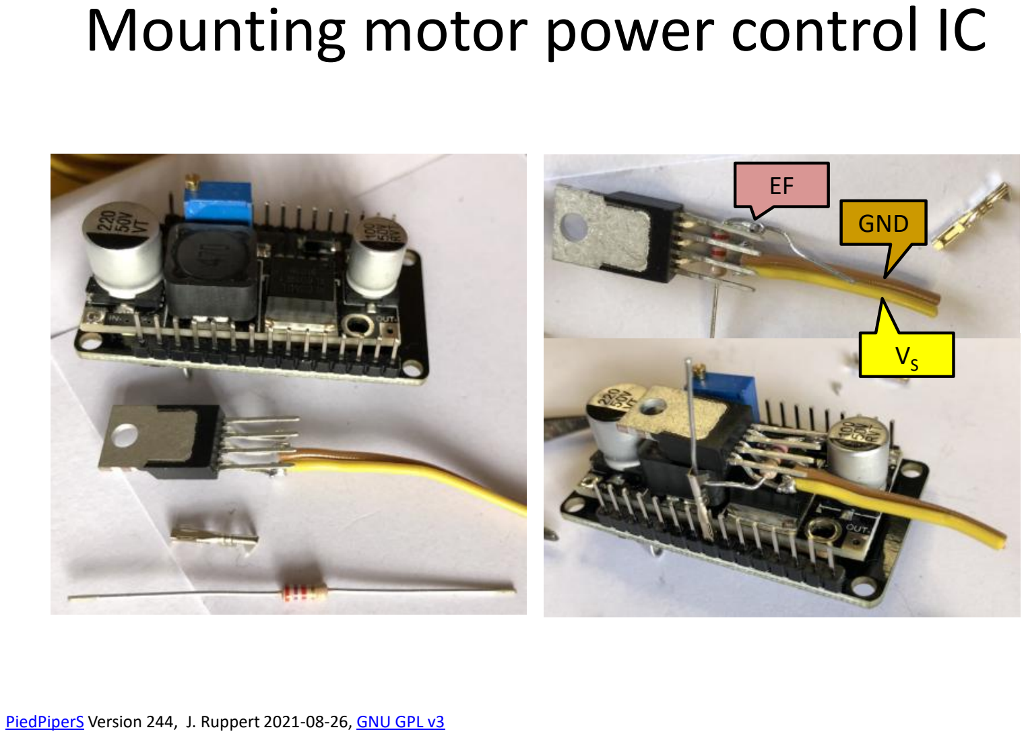
[picture p138: page 35]

VS

## GND

EF

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

Out +12…16 Vdc | GND

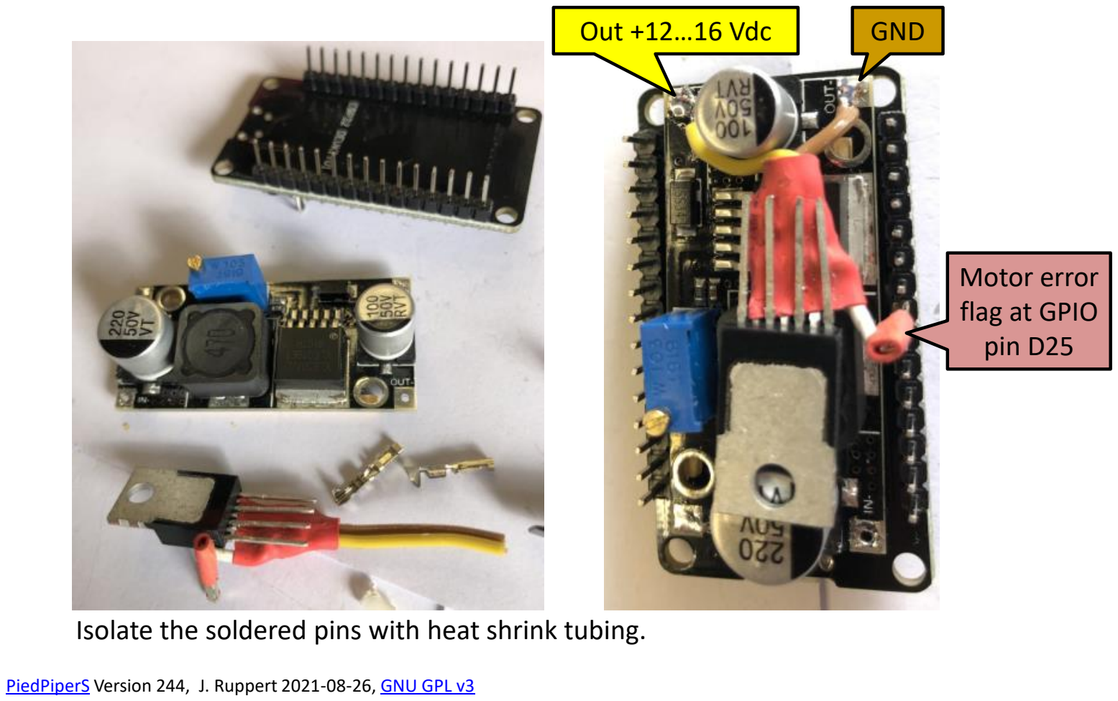
[picture p139: page 36]

## Motor error flag at GPIO pin D25

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

Isolate the soldered pins with heat shrink tubing.

# Connect ESP32 GPIO pins D33 and D32 to motor IC IN1 and IN2

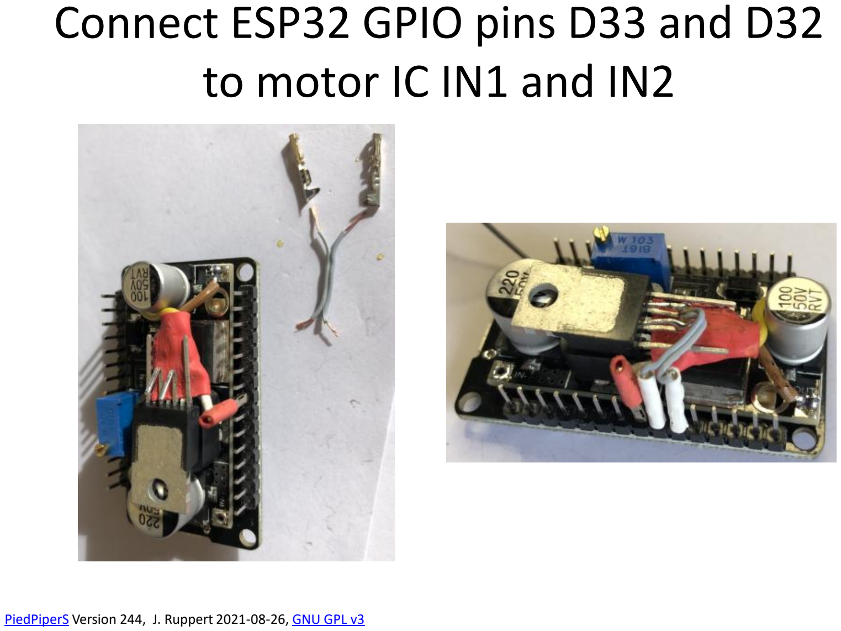
[picture p140: page 37]
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

# Connect USB power bank to ESP32 VDD, GND and In+, In- of Step-up-converter

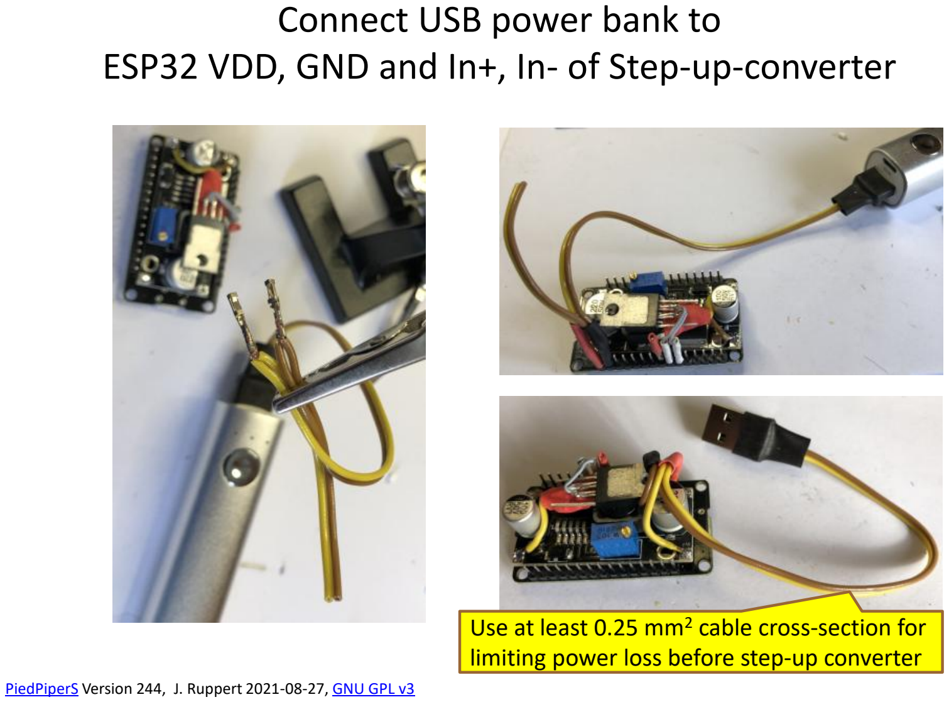
[picture p141: page 38]

PiedPiperS (https://github.com/jorail/PiedPiperS) Version 244, J. Ruppert 2021-08-27, GNU GPL v3 (https://www.gnu.org/licenses/gpl-3.0.en.html)

## Use at least 0.25 mm² cable cross-section for limiting power loss before step-up converter

# Cable with self-made mini plug for connection to locomotive motor

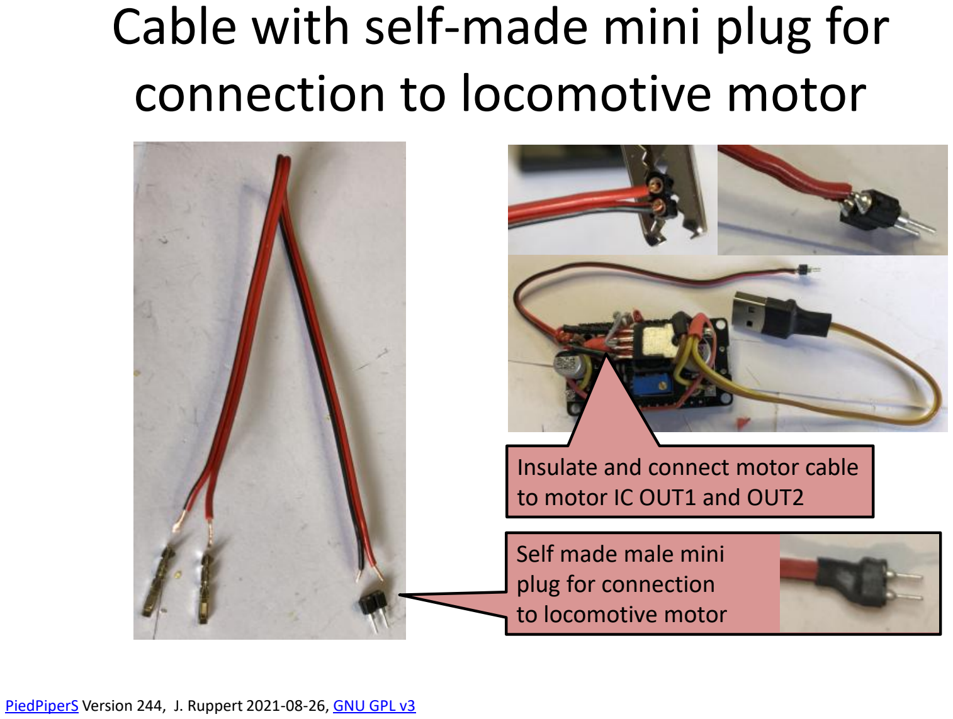
[picture p142: page 39]

## Self made male mini plug for connection to locomotive motor

## Insulate and connect motor cable to motor IC OUT1 and OUT2

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

# Completing ESP32 motor control module

## printed QR-Code for easy

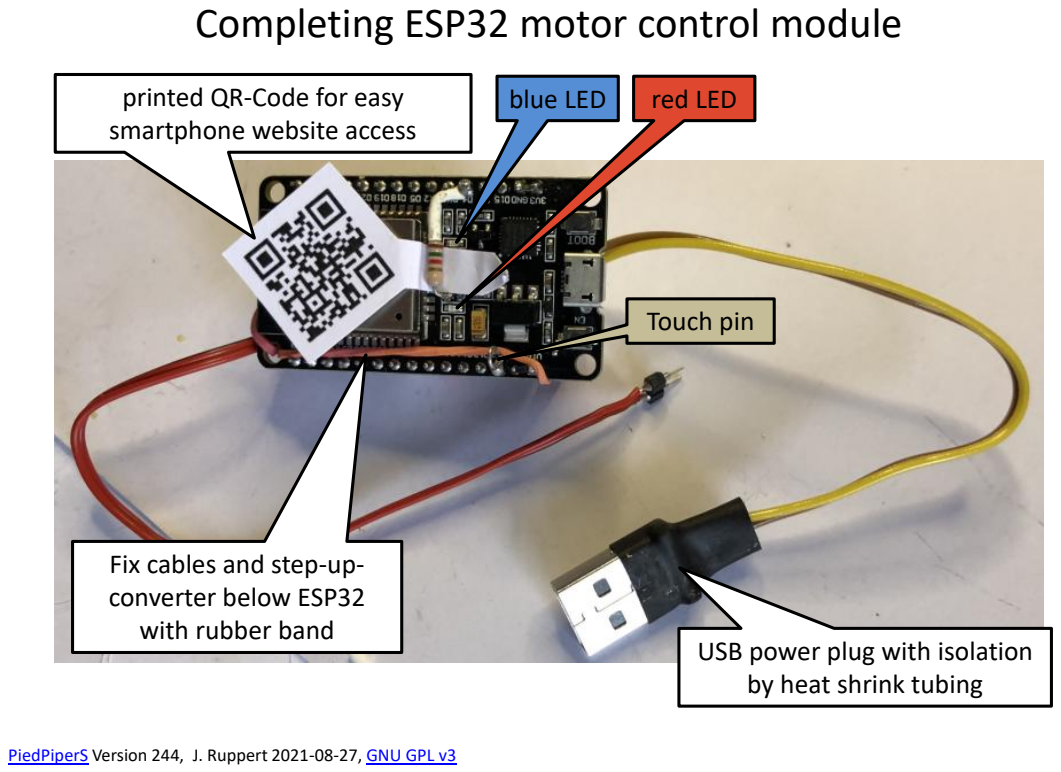
[picture p143: page 40]
blue LED; red LED; Touch pin

smartphone website access

Fix cables and step-up-
converter below ESP32
with rubber band

USB power plug with isolation
by heat shrink tubing

PiedPiperS (https://github.com/jorail/PiedPiperS) Version 244, J. Ruppert 2021-08-27, GNU GPL v3 (https://www.gnu.org/licenses/gpl-3.0.en.html)

# Upload the PiedPiperS sketch and test the motor control

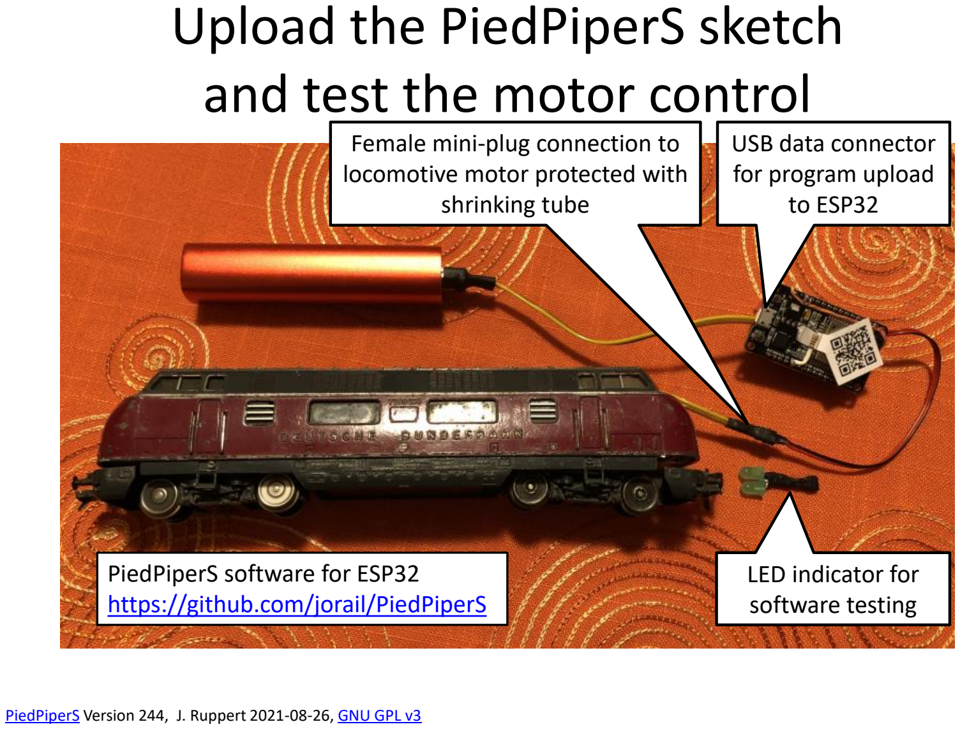
[picture p144: page 41]

## LED indicator for software testing

## Female mini-plug connection to locomotive motor protected with shrinking tube

## USB data connector for program upload to ESP32

## PiedPiperS software for ESP32 https://github.com/jorail/PiedPiperS

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

# Complete mounting on first wagon behind locomotive

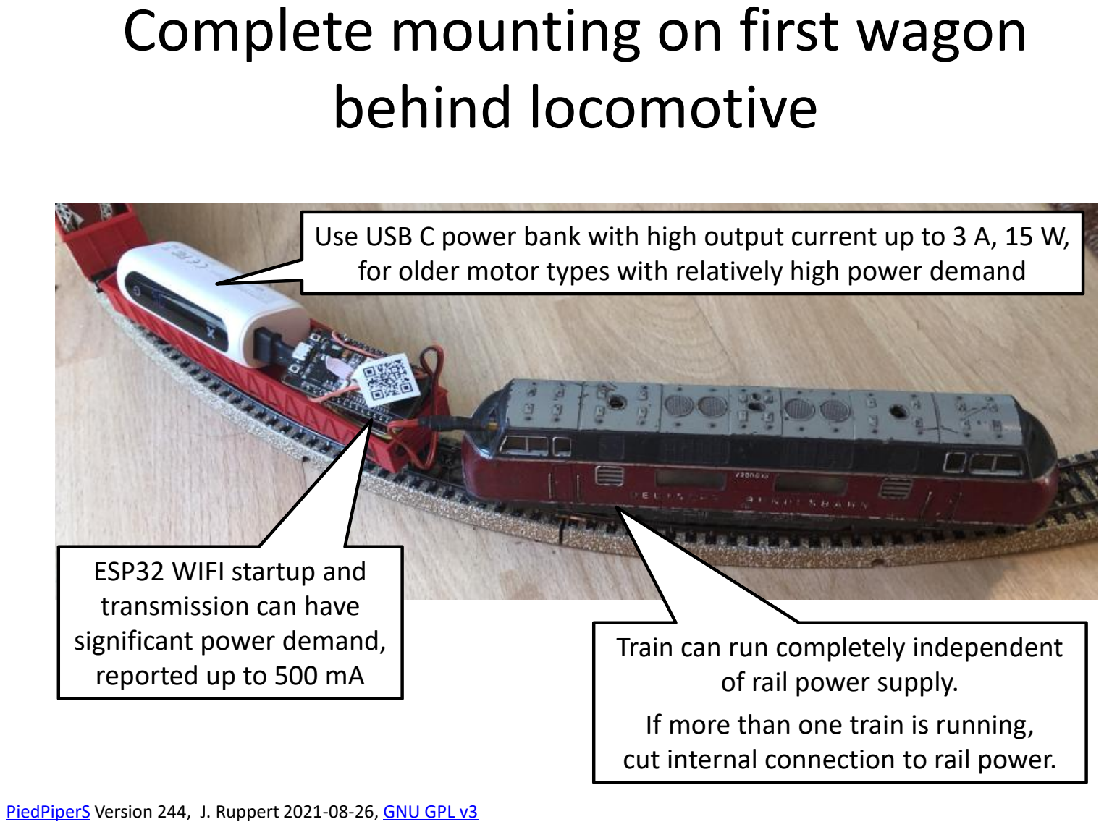
[picture p145: page 42]

Use USB C power bank with high output current up to 3 A, 15 W,

## for older motor types with relatively high power demand

## ESP32 WIFI startup and transmission can have

significant power demand,

## reported up to 500 mA

## Train can run completely independent

of rail power supply.
If more than one train is running, cut internal connection to rail power.

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

# Alternative implementation with motor IC L293D

# ESP32 & L293D

# integrated mounting and wiring

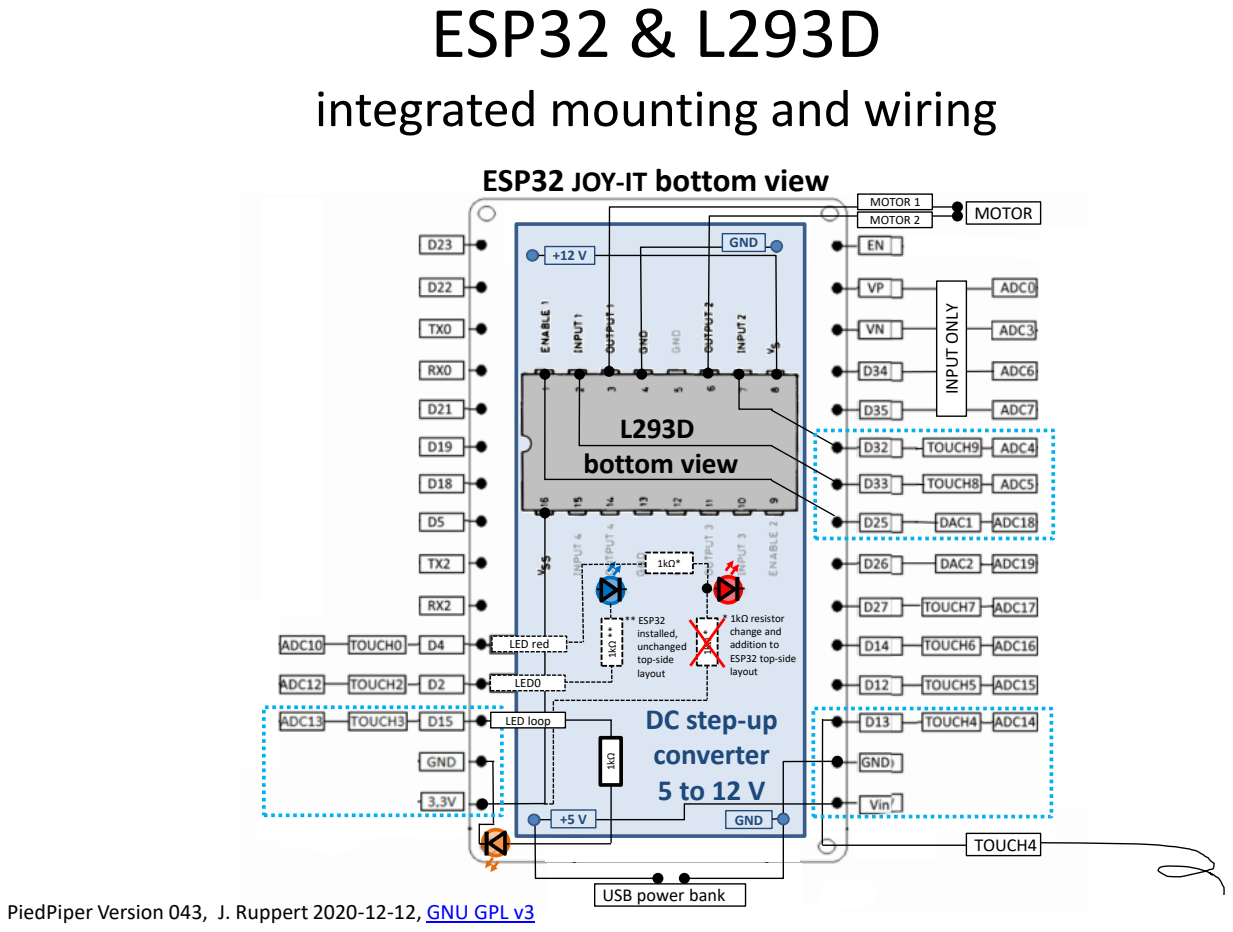
[picture p146: page 44]
GND; MOTOR; LED0; LED red; L293D bottom view; ** ESP32 installed, unchanged top-side layout; TOUCH4; LED loop; MOTOR 1 MOTOR 2; INPUT ONLY

ESP32 JOY-IT bottom view

* 1kΩ resistor
change and
addition to
ESP32 top-side
layout
DC step-up
converter

USB power bank

PiedPiper Version 043, J. Ruppert 2020-12-12, GNU GPL v3 (https://www.gnu.org/licenses/gpl-3.0.en.html)

# ESP32 & L293D integrated mounting and wiring

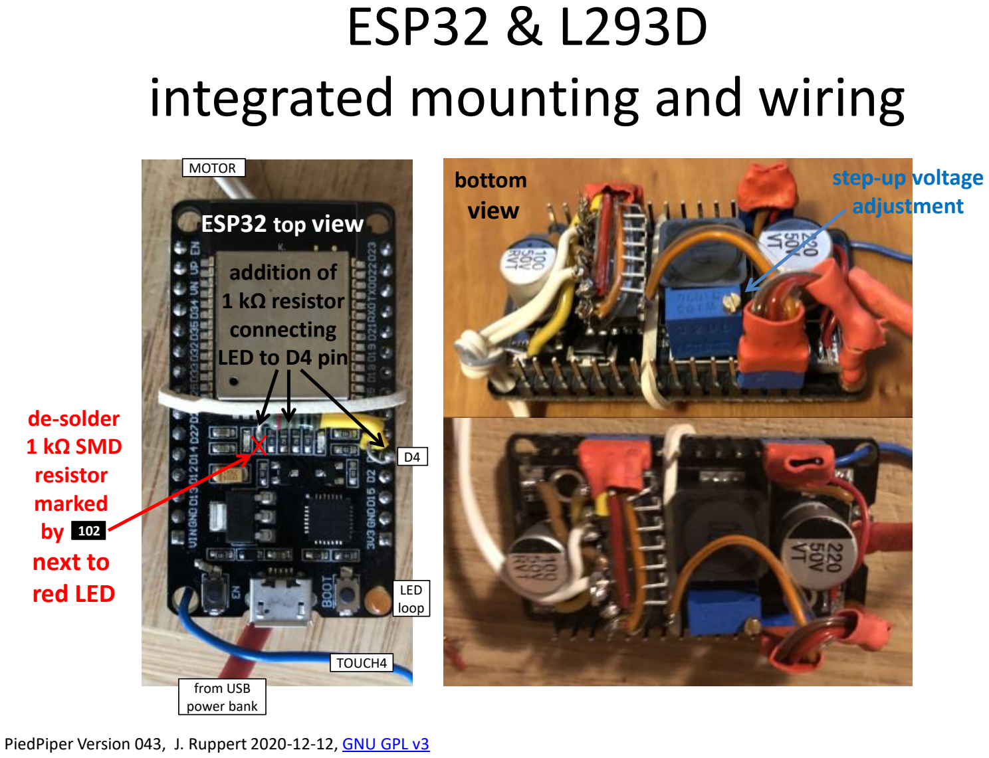
[picture p147: page 45]

## de-solder 1 kΩ SMD resistor marked

by

## next to red LED

## ESP32 top view

## bottom

## view

## step-up voltage adjustment

## addition of 1 kΩ resistor connecting LED to D4 pin

D4

102

TOUCH4
from USB
power bank

MOTOR

LED
loop

PiedPiper Version 043, J. Ruppert 2020-12-12, GNU GPL v3 (https://www.gnu.org/licenses/gpl-3.0.en.html)

# Option 1: Power measurement

# by reading current and voltage on measuring resistors

# PiedPiperS-Bauteile (Option 1)

# Materialbedarf für einen Zug mit WLAN-Steuerung

Messwiderstände Zur Beobachtung der Motorleistung können der effiktive Motorstrom und die Versorgungsspannung an zwei Analogen Eingängen des Mikrocontrollers während der Fahrt gemessen werden. Die Messwiderstände sollten dafür eine niedrige Toleranz aufweisen, z.B. Metallschichtwiderstände. Der 1,00 Ω Messwiderstand für den Motorstrom muss hinsichtlich seiner Leistung (in Watt) an die maximale Stromstärke

(in Ampere) angepasst werden.

- 1,00 Ω Messwiderstand für die Strommessung, 1 % Toleranz, 1 W ist geeignet für übliche H0-Modellbahnlokomotiven mit weniger als 1 A maximaler Stromaufnahme Für 1:11 Spannungsteiler - 1,00 kΩ Messwiderstand, 1 % Toleranz, 0,5 W - 10,0 kΩ Messwiderstand, 1 % Toleranz, 0,5 W - 1 kΩ Widerstand, 0,25 W, zum Schutz des analogen Messeingangs des Mikrocontrollers vor Spannungsspitzen aus der Strommessung im Leistungsteil der Motorsteuerung - Schrumpfschlauch, sehr dünn, zur teilweisen Isolierung der Anschlussdrähte der Widerstände

# ESP32 & TLE5206-2S

integrated mounting and wiring with LDO protection,

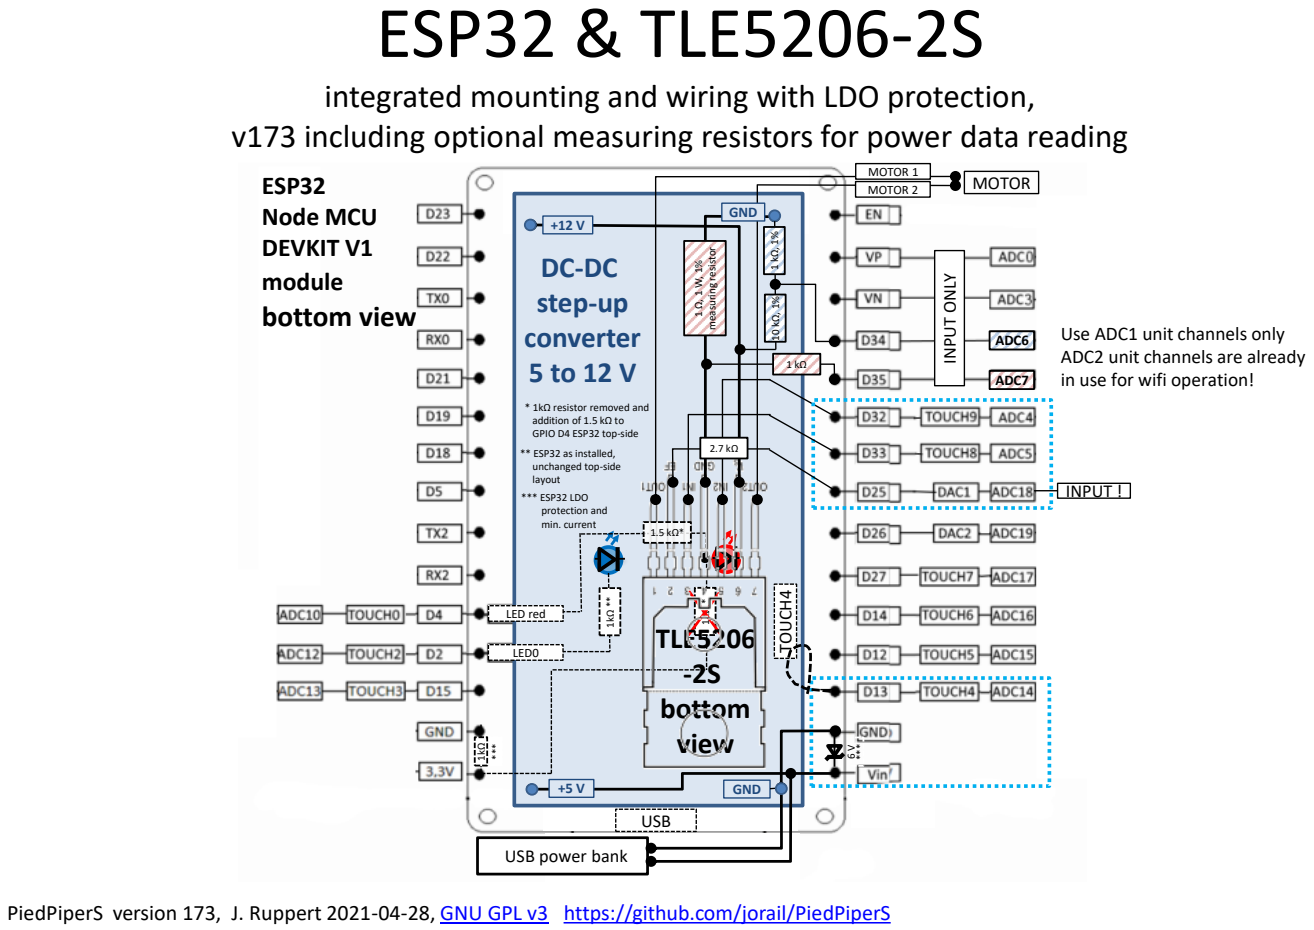
[picture p148: page 48]
ESP32 Node MCU DEVKIT V1 module bottom view; MOTOR; LED0; LED red; GND; DC-DC step-up converter 5 to 12 V1kΩ **; TOUCH4; INPUT ONLY; TLE5206 -2S bottom view; INPUT !; MOTOR 1 MOTOR 2; USB; measuring resistor; ADC7; ADC6; Use ADC1 unit channels only

v173 including optional measuring resistors for power data reading

ADC2 unit channels are already
in use for wifi operation!

* 1kΩ resistor removed and
addition of 1.5 kΩ to
GPIO D4 ESP32 top-side
** ESP32 as installed,
unchanged top-side
layout
*** ESP32 LDO
protection and
min. current

USB power bank

PiedPiperS version 173, J. Ruppert 2021-04-28, GNU GPL v3 (https://www.gnu.org/licenses/gpl-3.0.en.html) https://github.com/jorail/PiedPiperS

# Voltage measruement from devider between OUT+ and OUT- of step-up-converter consisting of 10.0 kΩ and 1.00 kΩ measuring

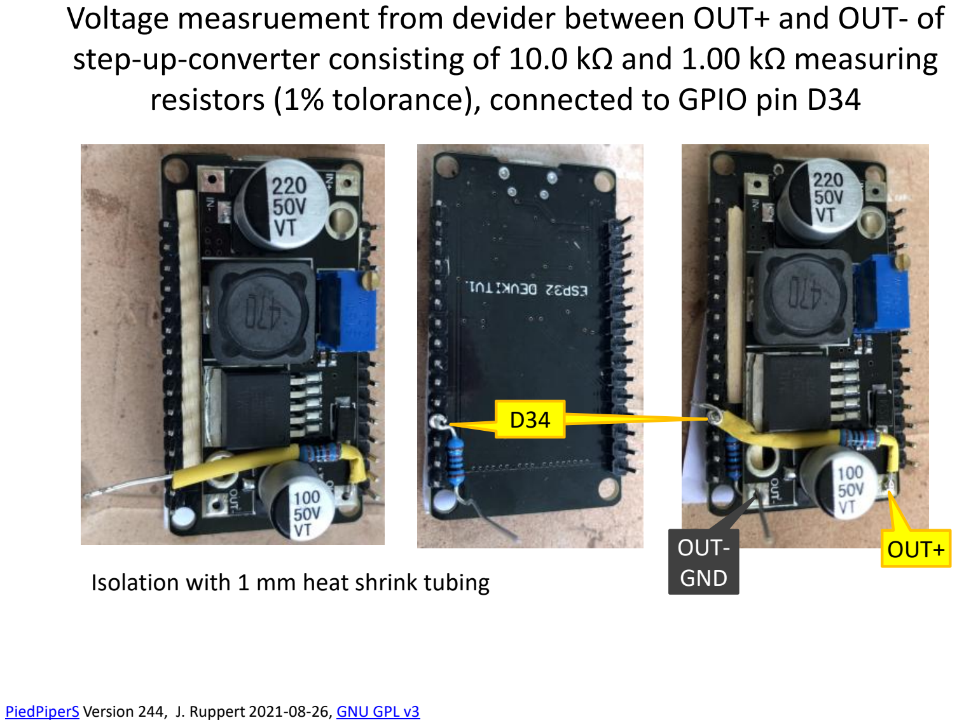
[picture p149: page 49]

# resistors (1% tolorance), connected to GPIO pin D34

## Isolation with 1 mm heat shrink tubing

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

OUT- | OUT+

## GND

D34

# Mounting 2.7 kΩ resistor for motor IC error flag EF as input to GPIO pin D25

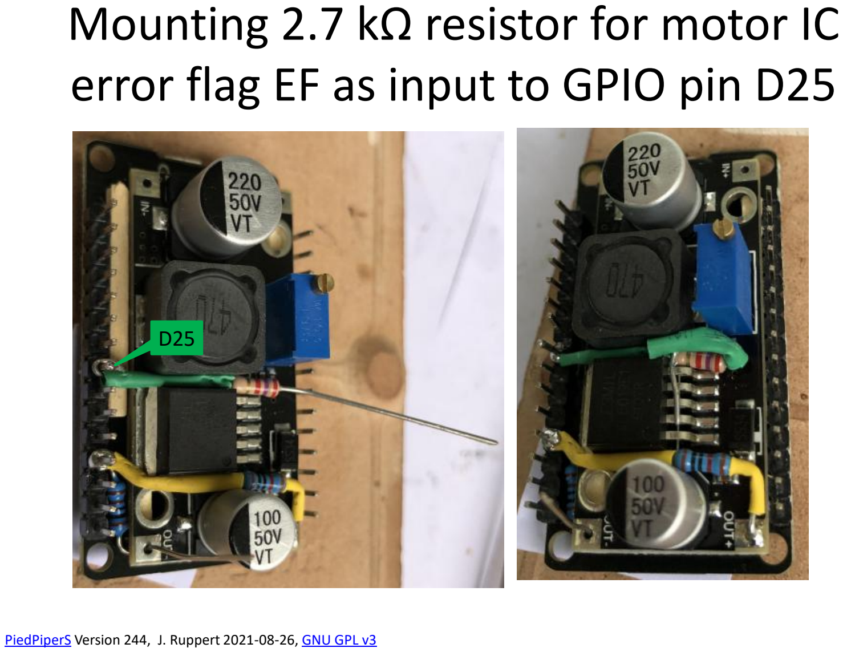
[picture p150: page 50]
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

D25

# 1 kΩ resistor for transfer of motor current measurment to GPIO pin D35

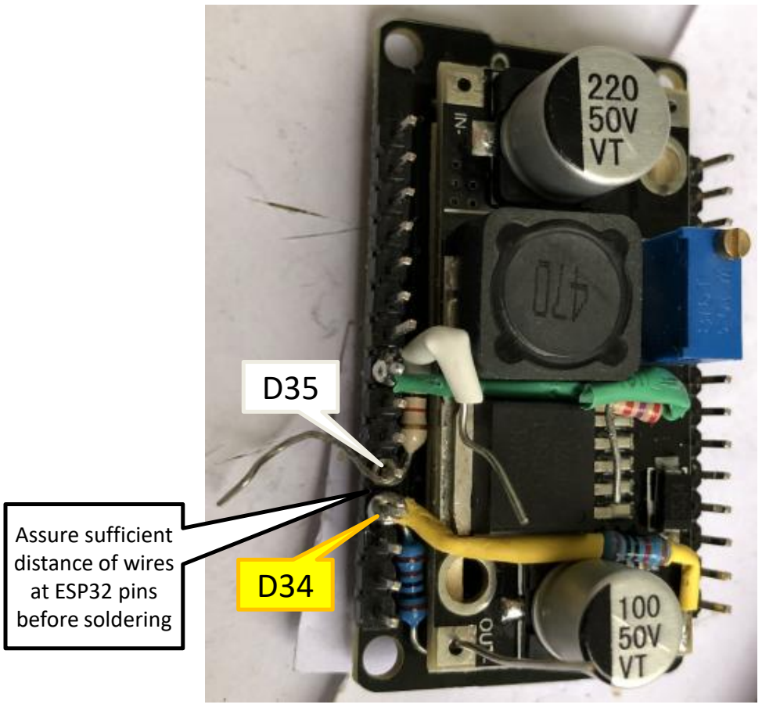
[picture p151: figure]
Assure sufficient distance of wires at ESP32 pins before soldering

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

# Motor IC power connection

VS

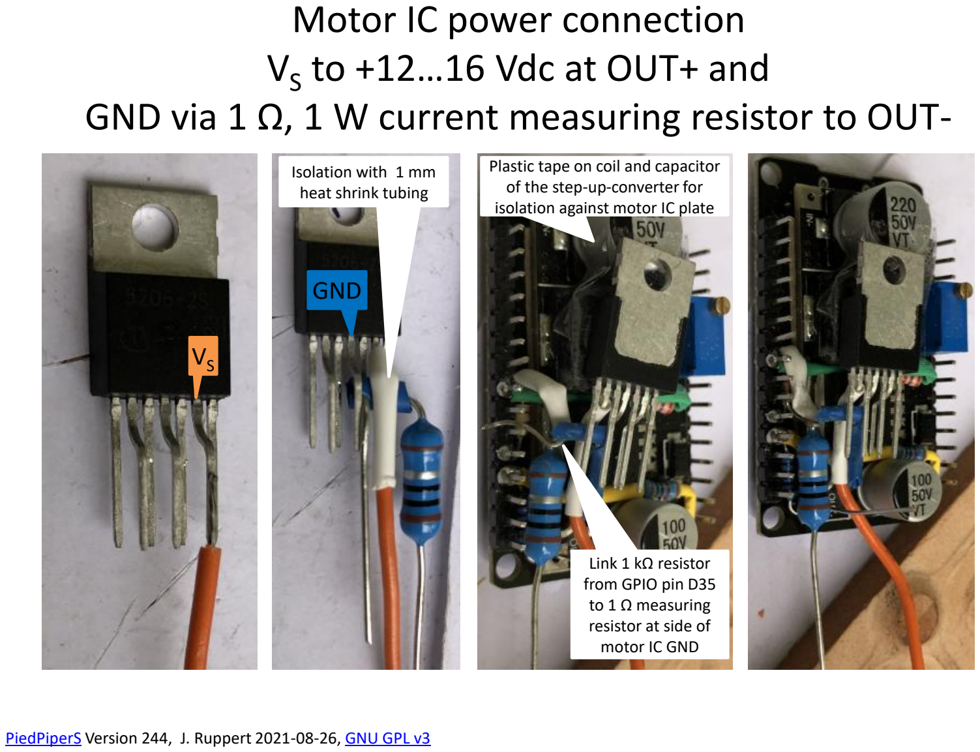
[picture p152: page 52]

# to +12…16 Vdc at OUT+ and GND via 1 Ω, 1 W current measuring resistor to OUT-

VS

## GND

Link 1 kΩ resistor
from GPIO pin D35
to 1 Ω measuring
resistor at side of
motor IC GND

Plastic tape on coil and capacitor of the step-up-converter for isolation against motor IC plate

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

Isolation with 1 mm
heat shrink tubing

# Connect 2.7 k resistor to motor IC EF

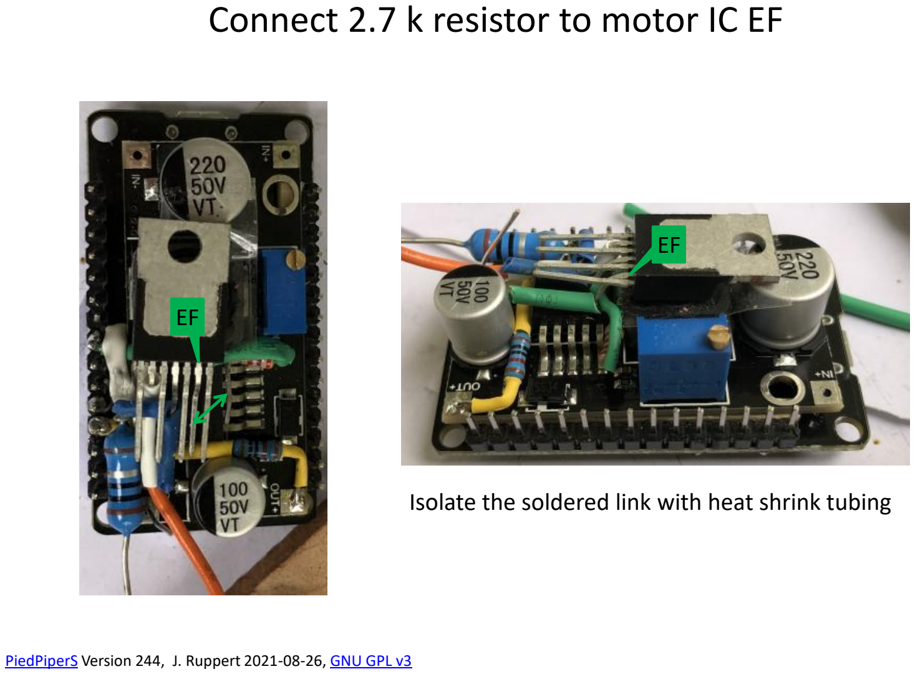
[picture p153: page 53]

EF

EF

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

## Isolate the soldered link with heat shrink tubing

# Connect motor IC to step-up converter output

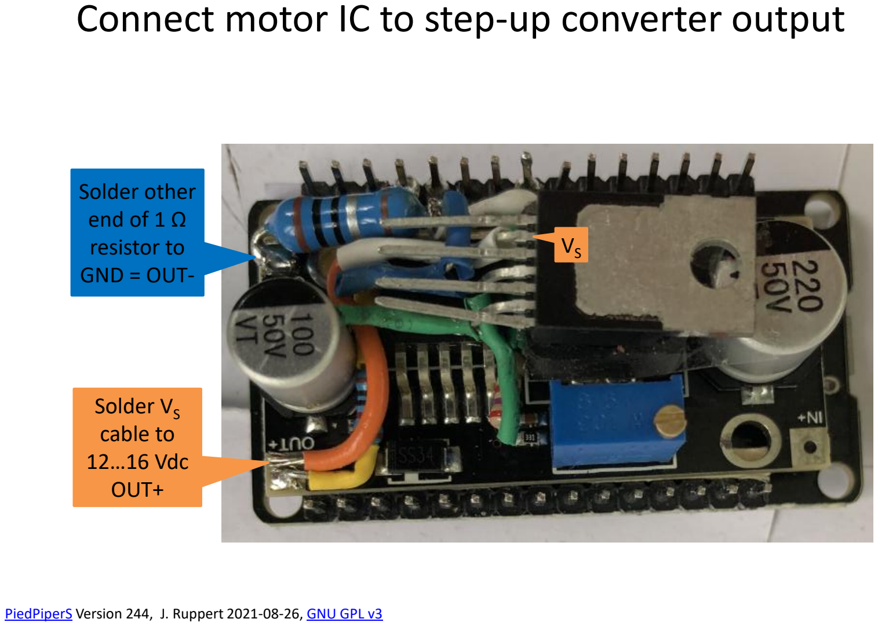
[picture p154: page 54]

## Solder other end of 1 Ω resistor to GND = OUT-

## Solder VS cable to 12…16 Vdc OUT+

VS

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

# Connect IN1 and IN2 to GPIO pins D33 and D32

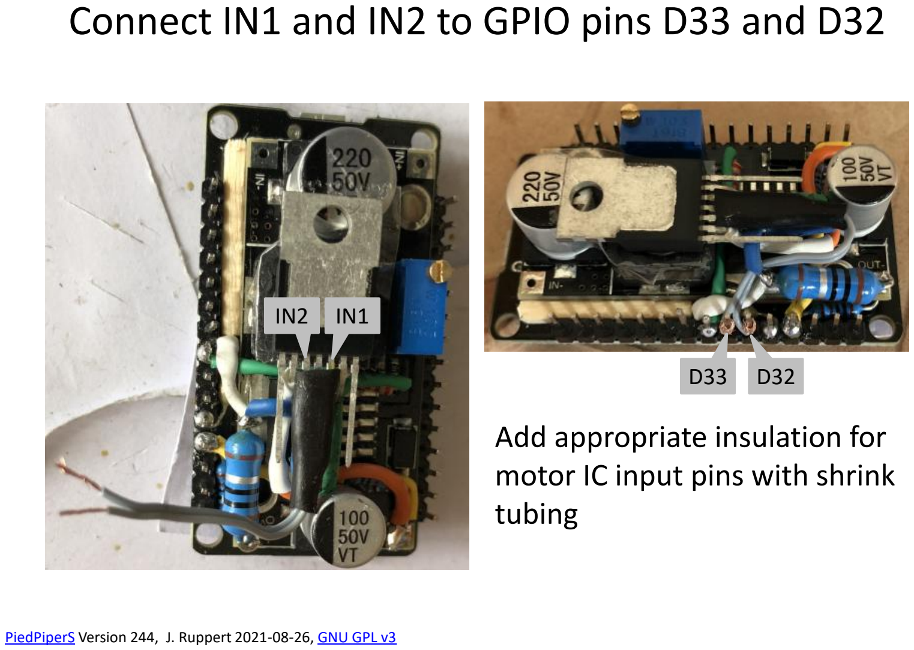
[picture p155: page 55]

# Add appropriate insulation for motor IC input pins with shrink tubing

## IN2 IN1

D33 D32

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

# Connect 5 Vdc power input of ESP32 and step-up

converter to short USB power supply cable.

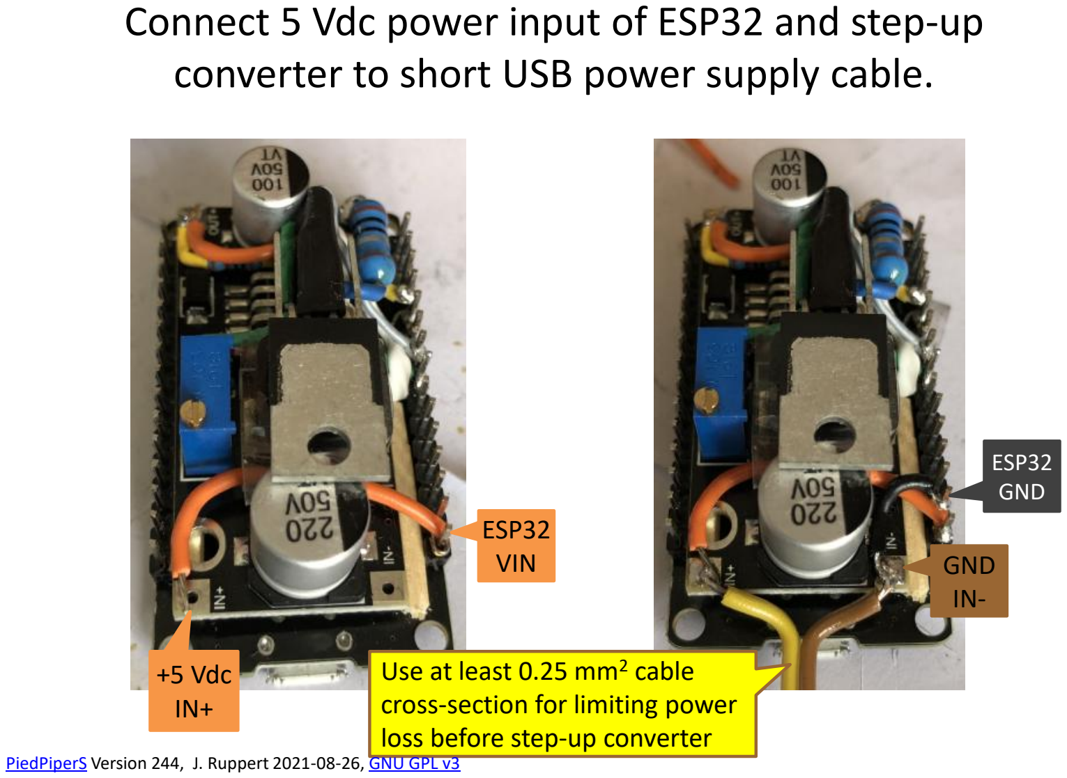
[picture p156: page 56]

## ESP32 VIN

## +5 Vdc

IN+

## ESP32 GND

## GND

IN-

## Use at least 0.25 mm² cable cross-section for limiting power loss before step-up converter

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

# Install short USB A plug with insulation for connection to USB power bank

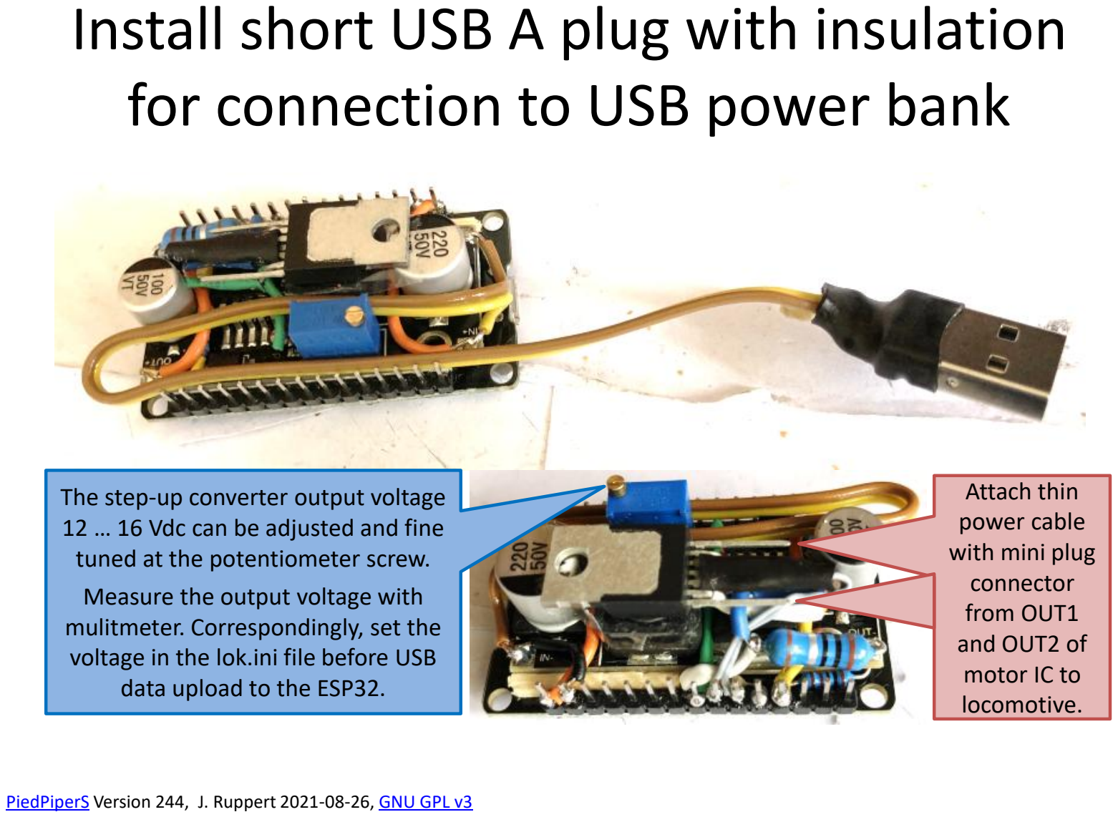
[picture p157: page 57]

## The step-up converter output voltage 12 … 16 Vdc can be adjusted and fine

tuned at the potentiometer screw.

## Measure the output voltage with mulitmeter. Correspondingly, set the voltage in the lok.ini file before USB

data upload to the ESP32.

## Attach thin power cable with mini plug connector from OUT1 and OUT2 of motor IC to

locomotive.

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

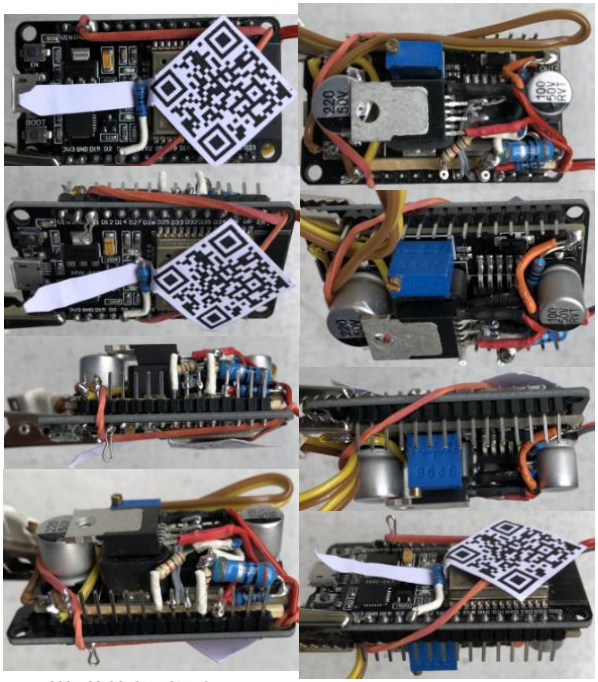
[picture p158: figure]
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

# Fixing cable and electrical conection to locomotive motor

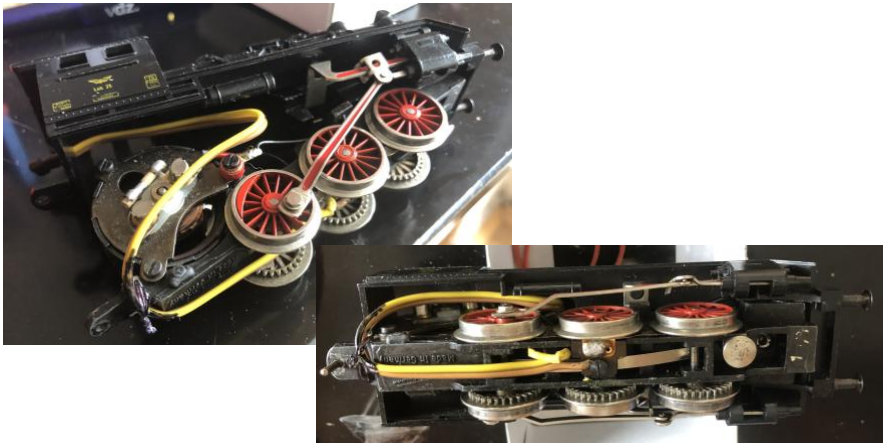
[picture p159: figure]
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

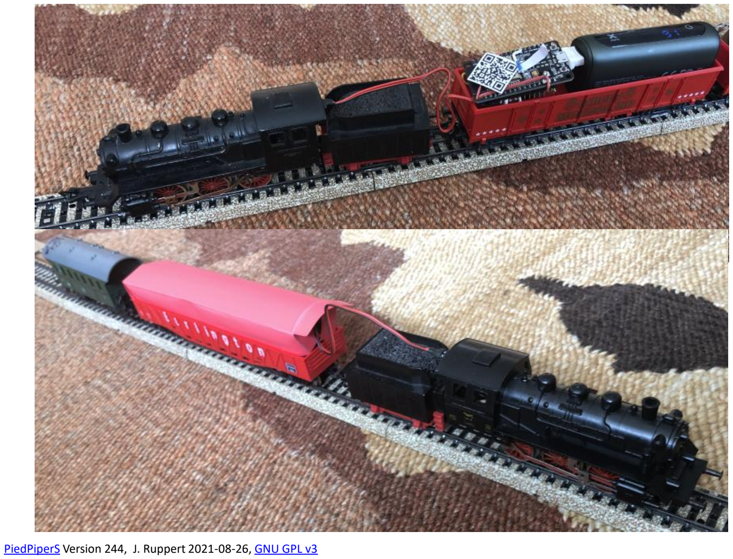
[picture p160: page 60]
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

# Option 2: Speed measurement

# by counting railway sleepers with reflective IR sensor

# Developed in PiedPiperS branch 'speedo', version 191 to 244 (https://github.com/jorail/PiedPiperS/tree/speedo)

# Geschwindigkeitsmessung (Option 2)

Für eine Geschwindigkeitsmessung vom fahrenden Zug aus (d.h.

kontinuierlich und online) werden die schwarzen oder dunklen Schienenschwellen der Modellbahnschinen beim Überfahren durch einen Infrarot-Sensor erfasst. Die Schienenschwellen haben gleichmäßige Abstände. Aus der Zeit, die der Zug bis zur nächsten Schwelle benötigt, und der Frequenz des Überfahrens kann dann die wahre Geschwindigkeit der Fahrt über die Schiene in Meter pro Sekunde (m/s) bestimmt werden. Die Geschwindigkeit wird regelmäß gemessen, in km/h entsprechend dem Modellmaßstab umgerechnet und in der Loksteuerung online angezeigt. Außerdem können die Ergebnisse der Geschwindigkeitsmessung in einem Diagramm auf der zusätzlichen Webseite speed.html verfolgt werden. Die Daten werden hierzu jede Sekunde über get /speeddata vom ESP32-Webserver

angefordert.

# Geschwindigkeitsmessung (Option 2) Elektronik-Bauteile

Für diese Geschwindigkeitsmessung wereden wenige zusätzliche Bauteile und eine sehr einfache elektrische Schaltung gebraucht. Eine Infrarot-(IR)-Reflexlichtschranke dient als Sensor zur Erkennung der Schienenschwellen unter dem Waagen. In der elektrischen Schaltung wird die Signalspannung für den Microprozessor verstärkt. Die unten abgebildete Schaltung ist in den Projektdokumenten (https://github.com/jorail/PiedPiperS/tree/main/docs)

### beschrieben und besteht aus folgenden Bauteilen:

- Infrarot-(IR)-Reflexlichtschranke und Näherungssensor für ca. 5 mm Abstand,

### z.B. Typ HSDL-9100, mit IR-LED als Sender und Fotodiode als Empfänger oder Typ SFH 9201 mit IR-LED als Sender und Fototransistor als Empfänger - 220 Ω Vorwiderstand für die Einstellung des Stroms durch die IR-LED IF bei 10 mA

- Signalverstärker aus einfachem NPN-Kleintransistor mit hoher Verstärkung, z.B. BC 238C, BC 548C,

### BC 547B, BC 848C, BC 846B

- 39 kΩ oder 39 kΩ Pull-up-Widerstand für die Erzeugung des analogen Eingangssignals.

### Der Widerstand kann zwischen 27 kΩ und 47 kΩ so gewählt werden, so dass sich eine gute

Erkennung der dunklen Schwellen ergibt.
- Bei Bedarf ca. 15 kΩ Bypass-Widerstand für Einstellung des Signalpegels eines hochohmigen

### Fototransistors

Geschätzte zusätzliche Materialkosten für Elektronik ca. 3 €. Die Bauanleitung mit Fotos für das

### PiedPiperS-Projekt liegt im Internet unter https://github.com/jorail

PiedPiperS version 244, J. Ruppert 2021-09-04, GNU GPL v3 (https://www.gnu.org/licenses/gpl-3.0.en.html) https://github.com/jorail/PiedPiperS

# Geschwindigkeitsmessung (Option 2)

## Die verstärkte Signalspannung wird über den analogen Eingang am Pin GPIO 39 und den Analog-Digital-Wandler ADC1_CH3 des Microprozessors erfasst. Die laufende Erkennung der Schienenschwellen im PiedPiperS-Programm kann unmittelbar durch die blaue LED auf dem Microprozessor

angezeigt werden.

## Um eine Mehrfachzählung einzelner Schwellen bei kontinuierlich zu- und abnehmender Signalspannung zu verhindern, ist zwischen dem niedrigen Spannungsniveau (< 0,5 V, heller Grund, reflektierend, keine Bahnschwelle)

und dem hohen Sannungsniveau (ca. 1,5 V, > 0,8 V, dunkle Bahnschwelle,

Transistor sperrt) ein ausreichend großes Totband (hier z.B. 0,3 V zwischen dem nidrigen und hohen Spannungsniveau) als Verzögerung (Hysterese) erforderlich. Letztlich müssen die Erkennung der Bahnschwellen in der Praxis entsprechend der Eigenschaften des Modellbahngleises und IR-Sensors erprobt und der Pull-up-Widerstand und die Grenzwerte für die Signalerkennung dazu passend eingestellt werden. Die Grenzwerte des niedrigen und hohen Spannungsniveaus können bei Bedarf ähnlich wie die Motorspannung

in der lok.ini-Datei angepasst werden.

# ESP32 & TLE5206-2S

## integrated mounting and wiring with LDO protection, incl. options

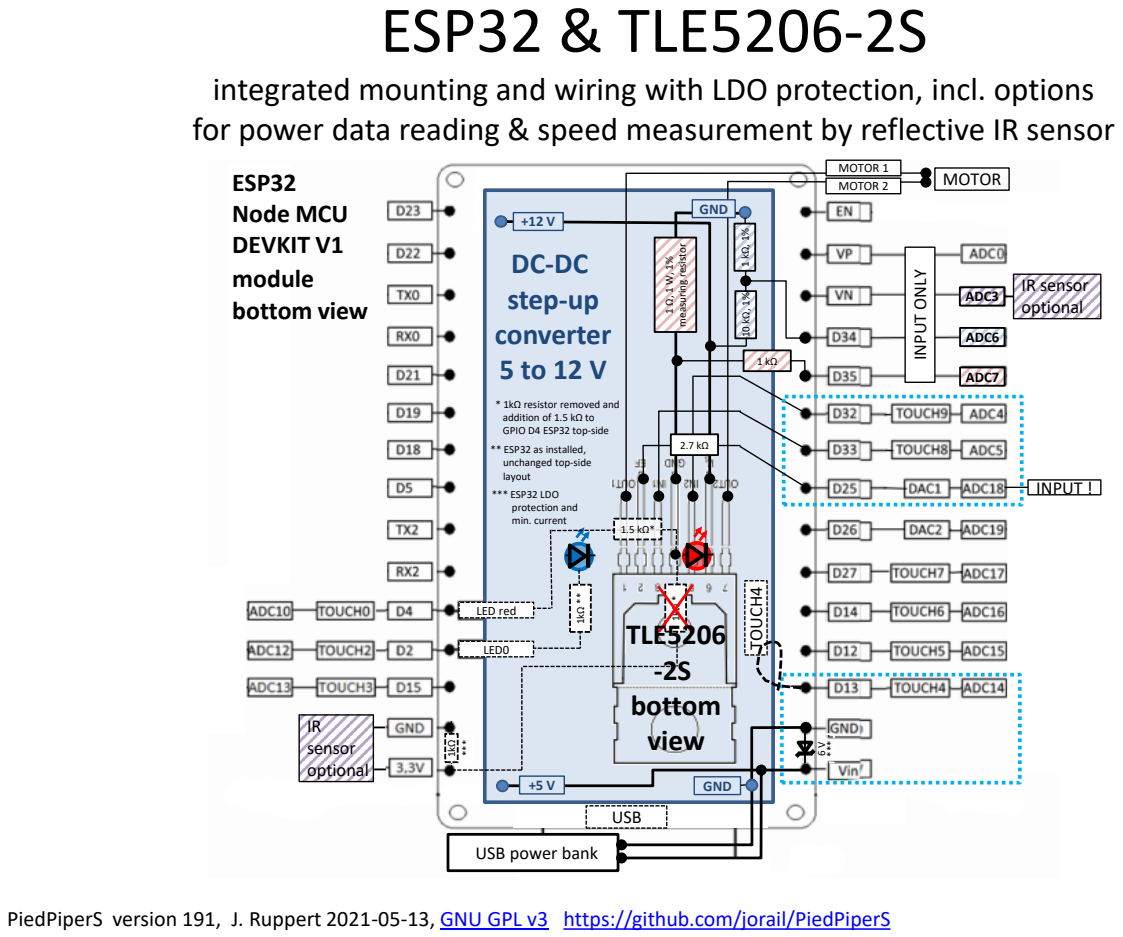
[picture p161: page 65]
ESP32 Node MCU DEVKIT V1 module bottom view; MOTOR; LED0; LED red; GND; DC-DC step-up converter 5 to 12 V1kΩ **; TOUCH4; INPUT ONLY; TLE5206 -2S bottom view; INPUT !; MOTOR 1 MOTOR 2; USB; measuring resistor; ADC7; ADC6; IR sensor optional ADC3; IR sensor optional

for power data reading & speed measurement by reflective IR sensor

* 1kΩ resistor removed and
addition of 1.5 kΩ to
GPIO D4 ESP32 top-side
** ESP32 as installed,
unchanged top-side
layout
*** ESP32 LDO
protection and
min. current

USB power bank

PiedPiperS version 191, J. Ruppert 2021-05-13, GNU GPL v3 (https://www.gnu.org/licenses/gpl-3.0.en.html) https://github.com/jorail/PiedPiperS

# Reflective IR sensor


PiedPiperS version 191, J. Ruppert 2021-05-13, GNU GPL v3 (https://www.gnu.org/licenses/gpl-3.0.en.html) https://github.com/jorail/PiedPiperS

# Reflective IR sensor mounting and preliminary circuit setup on breadboard

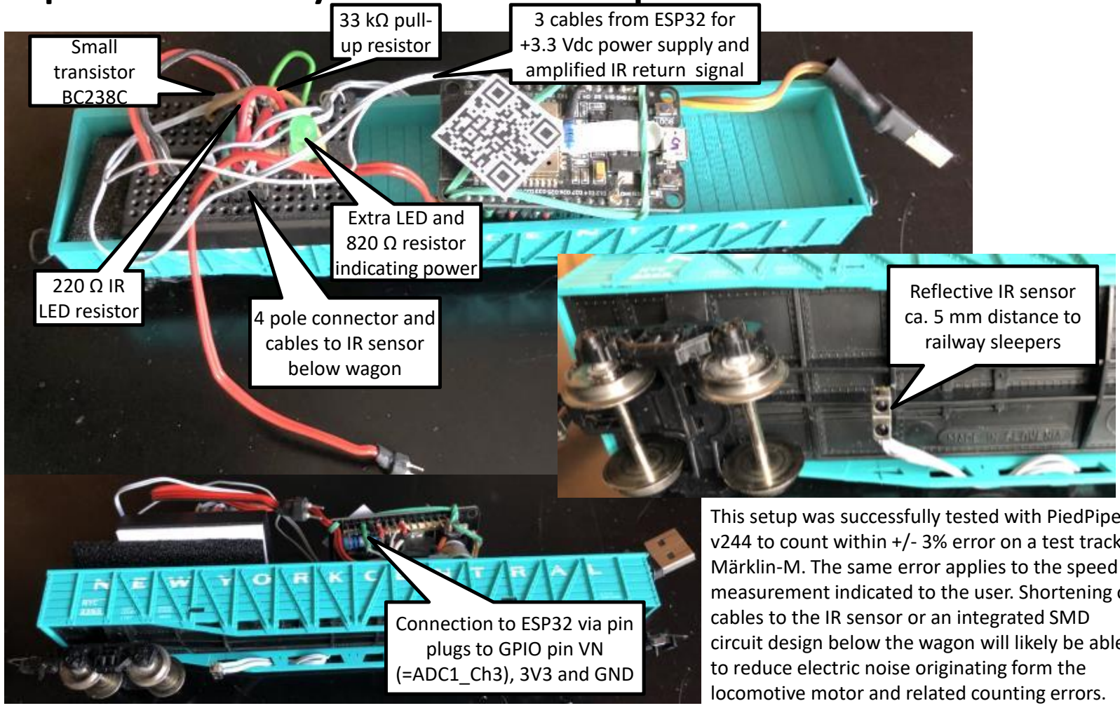
[picture p162: figure]
Small transistor BC238C; 4 pole connector and cables to IR sensor below wagon; Reflective IR sensor ca. 5 mm distance to railway sleepers; Connection to ESP32 via pin plugs to GPIO pin VN (=ADC1_Ch3), 3V3 and GND; 3 cables from ESP32 for +3.3 Vdc power supply and amplified IR return signal; 220 Ω IR LED resistor; 33 kΩ pull- up resistor; Extra LED and 820 Ω resistor indicating power

PiedPiperS version 244, J. Ruppert 2021-08-28, GNU GPL v3 (https://www.gnu.org/licenses/gpl-3.0.en.html) https://github.com/jorail/PiedPiperS

This setup was successfully tested with PiedPiperS v244 to count within +/- 3% error on a test track of Märklin-M. The same error applies to the speed measurement indicated to the user. Shortening of cables to the IR sensor or an integrated SMD circuit design below the wagon will likely be able to reduce electric noise originating form the locomotive motor and related counting errors.

# Design of integrated SMD circuit for

# refelctive IR photo diode sensor HSDL-9100

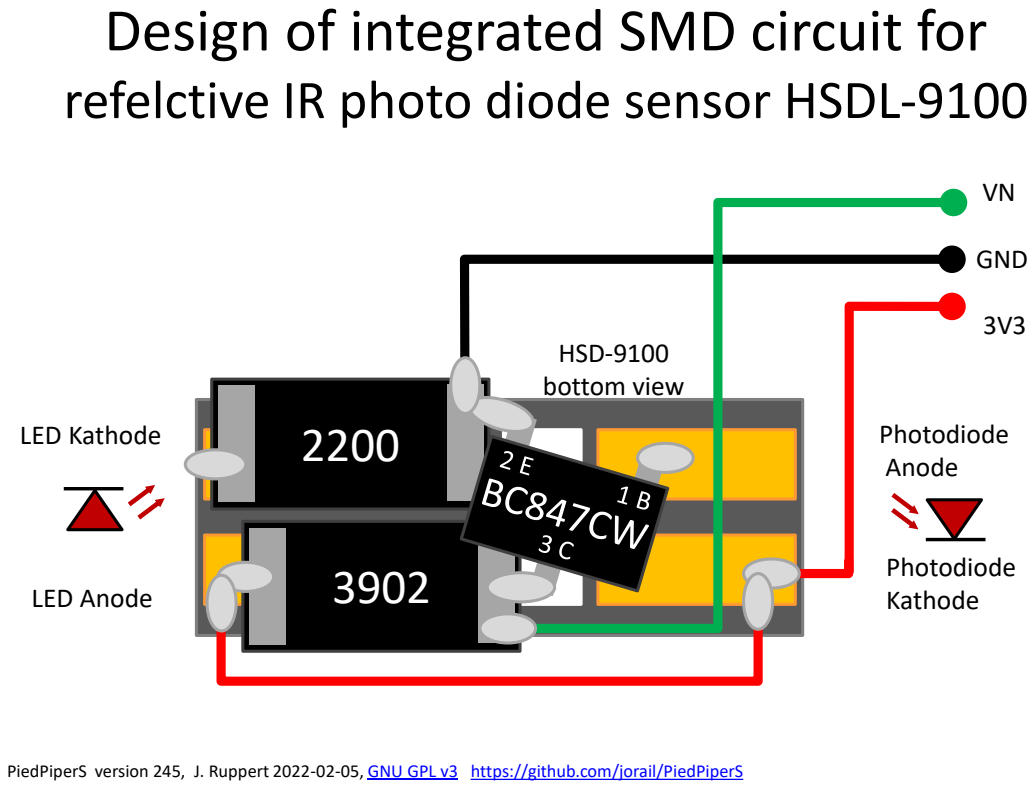
[picture p163: page 68]
LED Kathode; LED Anode; Photodiode Anode; Photodiode Kathode; GND; HSD-9100 bottom view

PiedPiperS version 245, J. Ruppert 2022-02-05, GNU GPL v3 (https://www.gnu.org/licenses/gpl-3.0.en.html) https://github.com/jorail/PiedPiperS

# Start building SMC circuit from the smallest parts

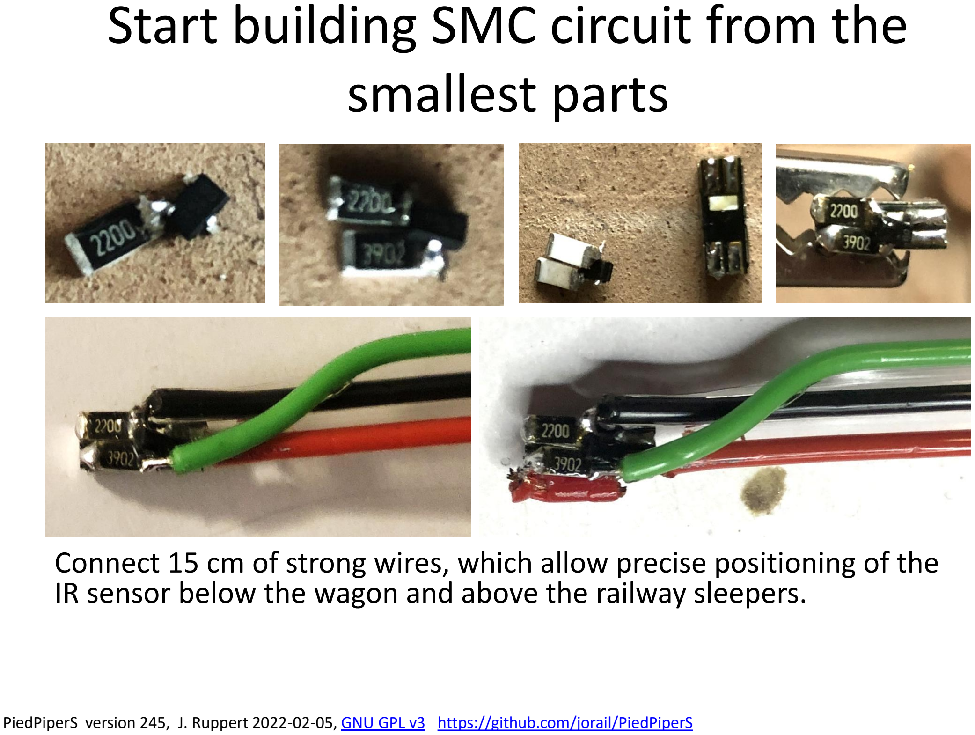
[picture p164: page 69]

# Connect 15 cm of strong wires, which allow precise positioning of the

IR sensor below the wagon and above the railway sleepers.

PiedPiperS version 245, J. Ruppert 2022-02-05, GNU GPL v3 (https://www.gnu.org/licenses/gpl-3.0.en.html) https://github.com/jorail/PiedPiperS

# Bottom view

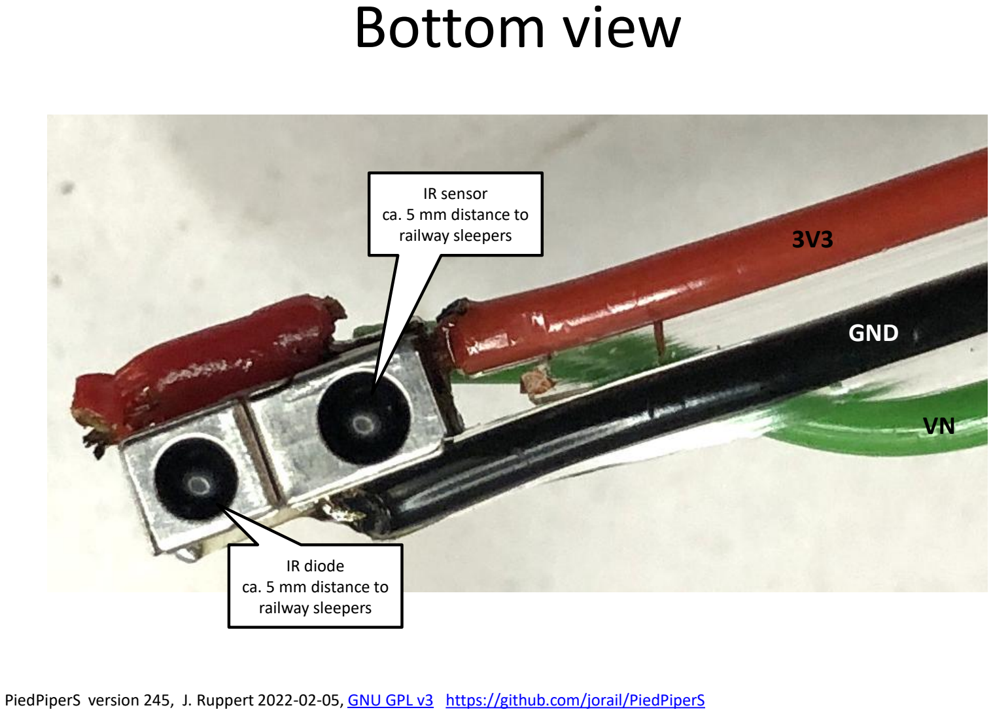
[picture p165: page 70]

IR sensor
ca. 5 mm distance to
railway sleepers

IR diode
ca. 5 mm distance to
railway sleepers

## GND

3V3

VN

PiedPiperS version 245, J. Ruppert 2022-02-05, GNU GPL v3 (https://www.gnu.org/licenses/gpl-3.0.en.html) https://github.com/jorail/PiedPiperS

# Design of integrated SMD circuit for

# refelctive IR photo diode sensor HSDL-9100

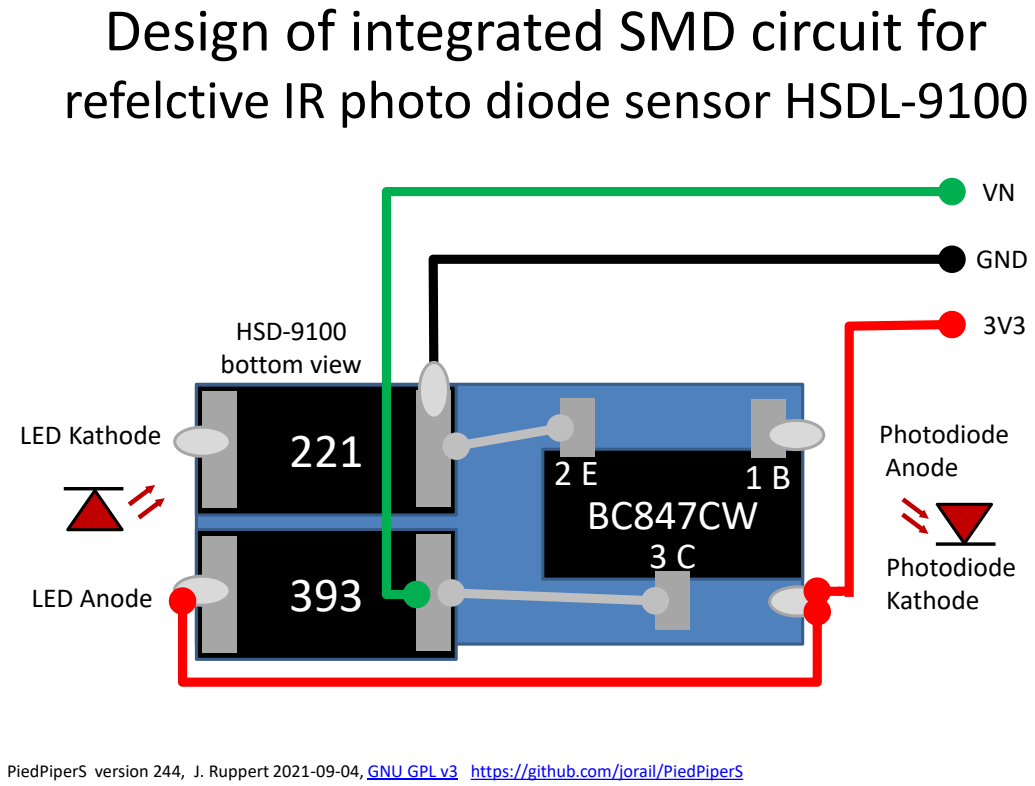
[picture p166: page 71]
LED Kathode; LED Anode; Photodiode Anode; Photodiode Kathode; GND; HSD-9100 bottom view

PiedPiperS version 244, J. Ruppert 2021-09-04, GNU GPL v3 (https://www.gnu.org/licenses/gpl-3.0.en.html) https://github.com/jorail/PiedPiperS

# Reflective IR sensor

# alternative ESP32 using internal pullup resistor


PiedPiperS version 180, J. Ruppert 2021-05, GNU GPL v3 (https://www.gnu.org/licenses/gpl-3.0.en.html) https://github.com/jorail/PiedPiperS

# Reflective IR sensor

# alternative using photo transistor IR module


PiedPiperS version 244, J. Ruppert 2021-09-03, GNU GPL v3 (https://www.gnu.org/licenses/gpl-3.0.en.html) https://github.com/jorail/PiedPiperS

# Design of integrated SMD circuit for refelctive IR sensor SFH 9201

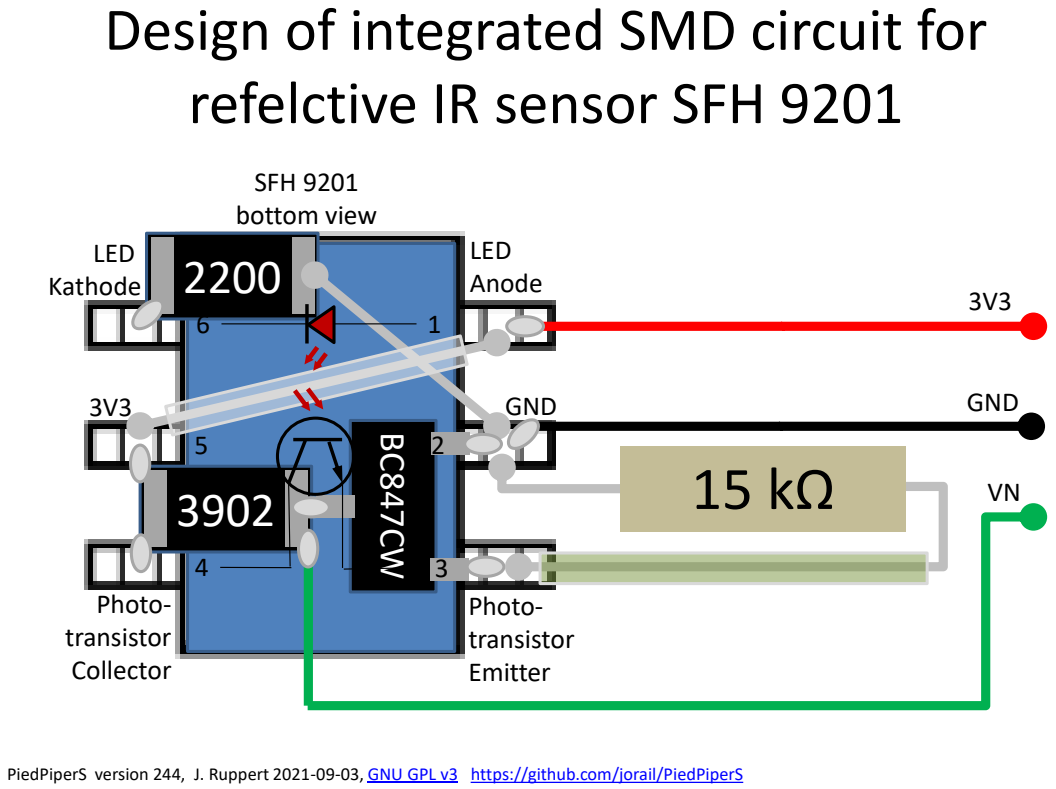
[picture p167: page 74]
LED Kathode; LED Anode; Photo- transistor Emitter; Photo- transistor Collector; GND; SFH 9201 bottom view

PiedPiperS version 244, J. Ruppert 2021-09-03, GNU GPL v3 (https://www.gnu.org/licenses/gpl-3.0.en.html) https://github.com/jorail/PiedPiperS

# Join transistor BC847CW and 39 kΩ resistor

# between IR transistor emitter, collector =3V3 and GND at pin 2

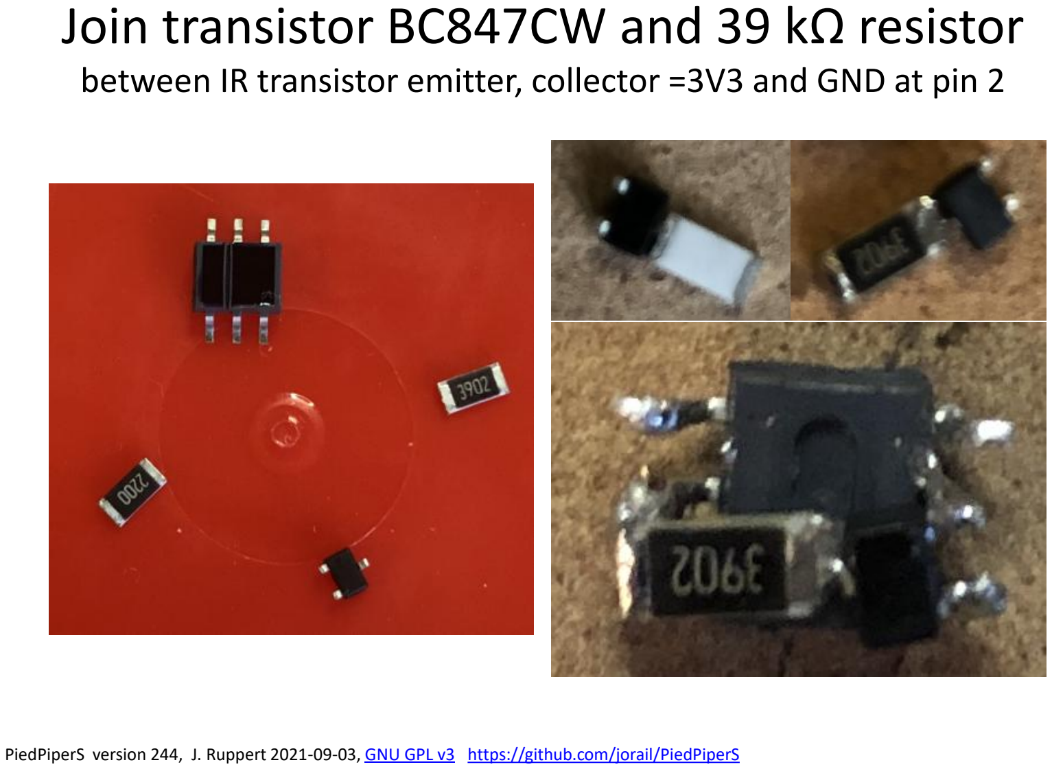
[picture p168: page 75]

PiedPiperS version 244, J. Ruppert 2021-09-03, GNU GPL v3 (https://www.gnu.org/licenses/gpl-3.0.en.html) https://github.com/jorail/PiedPiperS

# Add IR LED current limiting resistor 220 Ω between kathode and GND

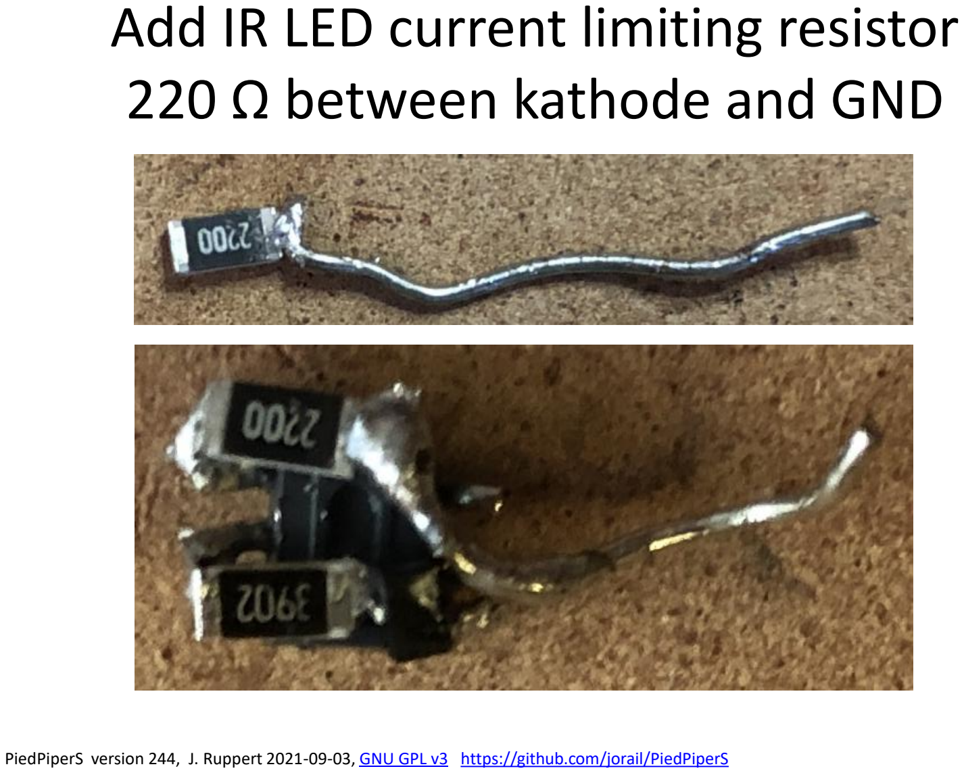
[picture p169: page 76]
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

# Link 3V3 pin 1 at IR LED Anode to pin 4&5 with an isolated wire piece

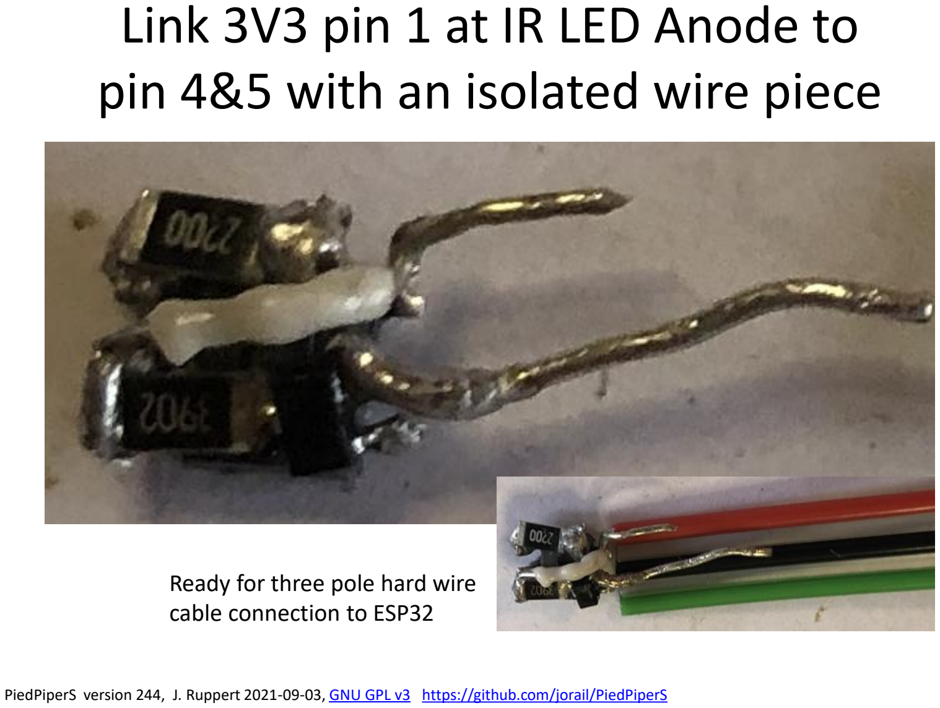
[picture p170: page 77]

## Ready for three pole hard wire cable connection to ESP32

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

# Solder cable for 3V3, GND power supply and analogue signal transmission to ESP32 pin VN

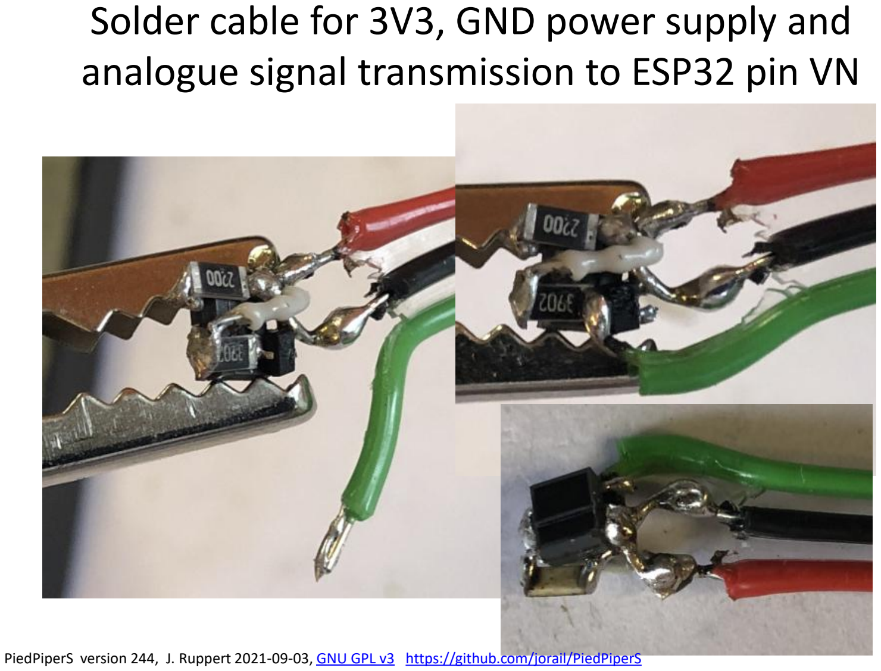
[picture p171: page 78]
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

# 1. Test all resistors, LED and transistor diodes 2. Add 15 kΩ resistor from transistor base pin 3 to GND pin 2

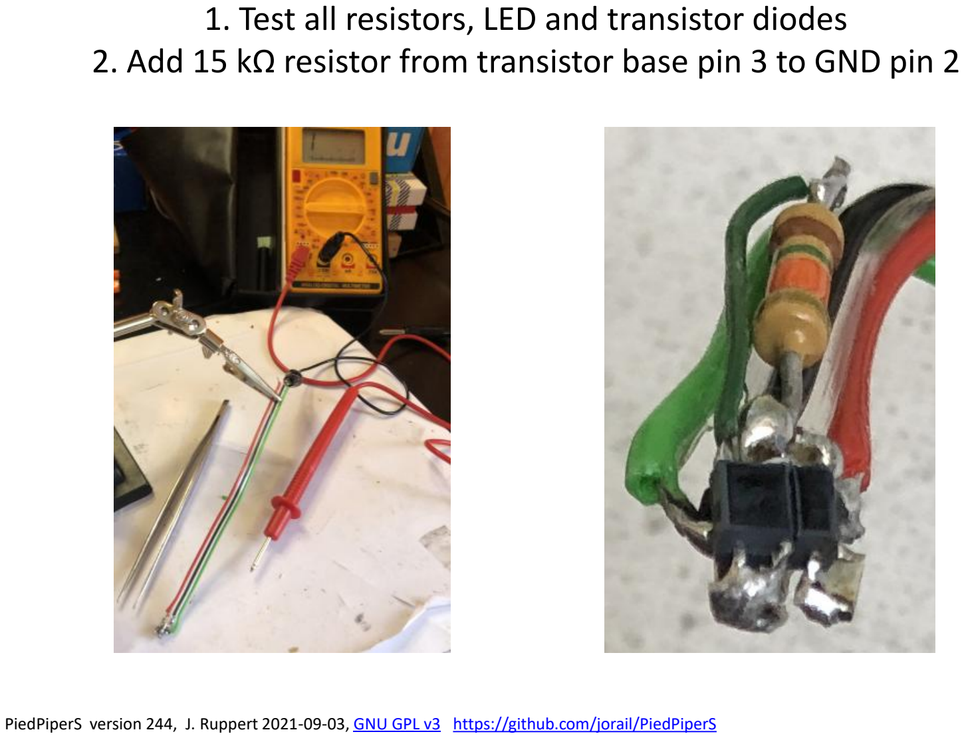
[picture p172: page 79]
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

# Add pin plugs and isolate them with shrink tubing

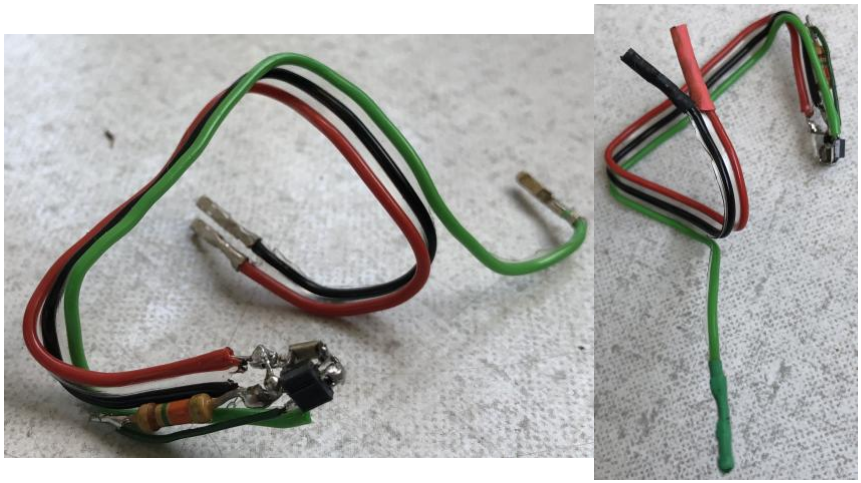
[picture p173: figure]
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

# Connect to ESP32 Analog Input GPIO pin 39 = VN, GND and 3V3 power supply

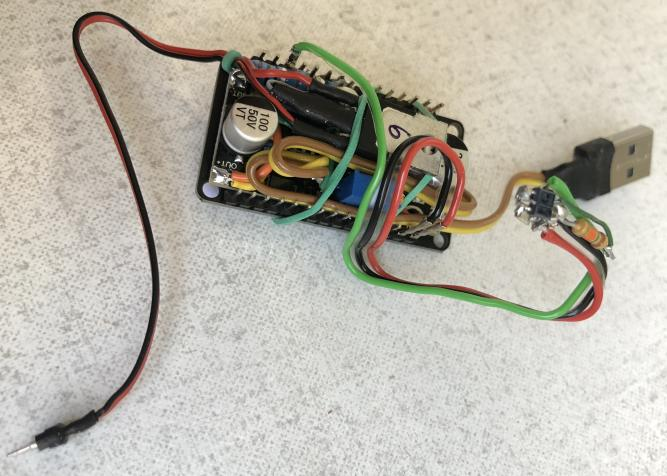
[picture p174: figure]
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
