jorail/PiedPiperS/(threads)

Thread 1 (2021-03-26):

make motor settings adjustable

jorail, 2021-03-26:
use html website with sliders for adjustment of
1. minimum PWM
2. maximum voltage setting
3. store motor settings for next startup in flash
4. use SPIFF file for storing and editing motor settings?

jorail, 2021-03-26:
html website for motor parameters should be linked at bottom of program variable display

jorail, 2021-03-26:
storing setup values for loco type in a lok.ini file in SPIFFS including loco name for index.html display, multiple .ini files could then be used as templates for setting up the loco at initialisation, later adjustments to the motor settings should still be allowed

jorail, 2021-03-26:
additionally allow for microprocessor setup, e.g. different pinout for ESP32 cam module

jorail, 2021-03-26:
review 32 vs 16 speed levels for faster speed-up or slow-down,
a) 16 level but half level increases
b) 32 levels but increase 2 at a time

jorail, 2021-04-18:
addressed in lok.ini branch, version 150, 2021-04-18, reading and writing of key loco parameters from lok.ini file at startup and option for editing and saving adjusted settings in ini.html, solved 32 levels maintained but with faster speed update,
remaining element: lok.ini adjustment of different pinout for ESP32 cam module

Closed 2021-04-18.

Thread 2 (2021-03-26):

optimise scaling of in-code websites

jorail, 2021-03-26:
- use right style commands in in-code print commands
- achieve comparable layout scaling on multiple smartphone devices

jorail, 2021-04-18:
addressed in lok.ini branch, version 150, 2021-04-18

Closed 2021-04-18.

Thread 3 (2021-04-18):

pinout adjustment via lok.ini

jorail, 2021-04-18:
lok.ini adjustment of different pinout for ESP32 cam module

jorail, 2021-05-01:
from lok.ini branch development 1.5.2021:
not (yet) implemente: reading of .ini file pinout parameters, this part was omitted, as it involves the risk of electrical faliures at the microprocessor and should only be applied with in-depth knowledge of the electrical circuit setup and microprocessor functionality, in that case, a change by .ino editing and compilation is an appropriate option and online editing is not required

Closed 2021-05-01.

Thread 4 (2021-04-18):

Monitor motor current via voltage anlogue input

jorail, 2021-04-18:
ADDITIONAL IDEA for continuing the project

define GPIO pin 26 as input for monitoring motor current on a 1 Ohm resistor between ground and motor IC grounding,
display and moinitor its voltage of approximatly up to 1 V, which is proportional to motor current as number on control panel
and its change over time recorded in a buffer and displayed in an extra website, which also allows for speed adjustments,
 so that their effect can be monitored online. Let me know if you like to go for it together.

jorail, 2021-04-19:
moved to discussion as new idea

Closed 2021-04-19.

Thread 10 (2021-05-01):

use ESP32 cam module to take a video view from the locomotive front

jorail, 2021-05-01:
- the cam module is small enough to be mounted in or just behind the locomotive
- it can take a microSD card for enhanced storage
- in/outputs pinout is limited but can be enhanced
- indicator LEDs need to be mounted seperately (no problem)

jorail, 2022-06-05:
At the 5th FYMT the first loco view worked out: Now we have video from an extra wagon served from a ESP32 cam module. Photos will follow soon...

Thread 9 (2021-05-01):

speed measurement from optical reading of passing railroad sleepers

jorail, 2021-05-01:
- optical reading is easily possible with a digital or analog input of ESP32
- black sleepers are equally spaced on model railrod track
- check whether ambient light is good enough to pick the contrast between black sleepers and in between lighter material. alternatively, a light barrier element with an active light source can be used
- the reflective light optical pulses converted to an electrical signal can be converted to a frequency of passing sleepers and a true speed over ground measurement

jorail, 2021-05-13:
reflective infrared (IR) sensor used on analog input at GPIO39, ADC1_CH3, implemented as an optional amendment in PiedPiPerS branch 'speedo', version 191, new website speed.html with online data display, transfer request by get /speeddata, circuit with reflective IR emitting and receiving diode, simple amplifier consisting of one small transistor and two resistors

jorail, 2021-06-02:
implemente in speedo branch, consolidated as version 216, including speed.html for viewing counting results and irsamplerecord.html for monitoring, debugging and adjusting sensor readings

Closed 2021-06-02.
