jorail/PiedPiperS/PiedPiperS/data/PiedPiperS.cpp

/* PiedPiperS
  This code is published with GNU General Public License GPL v3, 
  Copyright (c) J. Ruppert, 2026-06, jorail [at] gmx.de
  
  The program purpose is to control a model train motor with independent power supply
  e.g. from USB power bank for outdoors. Following options exist:
  a) Control fron a smartphone: ESP32 Wifi WebServer for commands from a client browser via WebSocket connection:
     https://github.com/jorail/PiedPiperS
     including options for online power data reading and speed data sampling by IR sensor
  b) Control by a whistle: Original PiedPiper whistle Morse code signals. Works with microphone input and FFT tone 
     analysis in a Teensy 4.0 microcontroller (in this version tone sampling is deactivated for ESP32 by commenting out):
     https://github.com/jorail/PiedPiper
  c) Switch or Touch-Pin Morse code input
  d) SerialMonitor input commands by typing letters, connection via USB

  The project is inspired by the project 'free your model train' (FYMT) proposed by Frei Softwarefreunde
  at  https://freie-software.org/?Projekte___Free_Your_Model_Train

  The code and layout are developed for ESP32 (or Teensy 4.0) but can easily be modified for other micro controllers.
  Asynchronous WebServer libraries are used in combination with WebSocket connection and JSON messages.
  Sound evaluation and tone signal identification is performed by FFT analysis in the microprocessor.
  Identified client commands or Morse code commands from a switch, touch senosor or tone signals are processed to 
  commands for change of the speed level. New motor settings are transfered via pulse width modulation (PWM) output 
  to a H-bridge motor control IC.

  Many thanks and acknowledgments to D.Meschede for support during the debugging of the PiedPiperS code.
  The idea for the FFT analysis for tone identification in PiedPiper and part of the functions are based on 
  'Audio Tone Input' (toneinput.ino) by Tony DiCola, which is published with MIT License (see below) 
  as part of the ardafruit learning guide and examples at http://learn.adafruit.com/fft-fun-with-fourier-transforms/. 
  The corresponding function headings are marked by 'MIT License'.
    
  GNU General Public License Version 3, GPLv3
    
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

  The MIT License (MIT) for marked sections with copyright (c) 2013 Tony DiCola
    
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
  ;PlatformIO Project Configuration File

      [env:ESP32C3_SuperMini] ;works also for ESP32C3_Zero
      platform = espressif32
      board = esp32-c3-devkitm-1

      framework = arduino
      upload_protocol = esptool
      monitor_speed = 115200

      build_flags = 
      ;   -D CORE_DEBUG_LEVEL=3             ;comment out as not working with platformio
        -D ARDUINO_USB_MODE=1             ;use this with ESP32-S3 or ESP32-C3
        -D ARDUINO_USB_CDC_ON_BOOT=1      ;use this with ESP32-S3 or ESP32-C3

      lib_deps = 
        esp32async/AsyncTCP@^3.4.9
        esp32async/ESPAsyncWebServer@^3.9.0
        bbx10/DNSServer@^1.1.0
        bblanchon/ArduinoJson@^7.4.2
        yurilopes/SPIFFSIniFile@^1.0.0

  Version track:
  056 2021-02    PiedPiper_056 stable version before Server module integration

                 Development of ESP32 Server as ESP32_AP_AWebServer_WS_JSON_020.ino
                 including whistle speed control for model trains, using microcontroller, FFT tone analysis, 
                 outdoor compatible with on-board USB power supply 
  061 2021-03-10 PiedPiperS_061 first draft of server integration (create server, before startup)   
  100 2021-03-22 consolidated version, start for github
  103 2021-03-27 consolidated version, prepare for lok.ini branch and further development
  
  lok.ini branch in github: https://github.com/jorail/PiedPiperS/tree/lok.ini
  178 2021-05-09 consolidated code
   
  speedo branch in github: https://github.com/jorail/PiedPiperS/tree/speedo, develop speed-o-meter with reflective ir detector on railway sleepers
  216 2021-06-02 consolidated version for speedo branch
  217 2021-06-03 adjust transmission of irsamplerecord array, toggle ir sample averaging for railway sleeper detection
  218 2021-06-03 add adjustment for IRlow and IRhigh from irsamplerecord.html via websocket message
  219 2021-06-03 modify effect of flag IRSampleRecording: Extension to individual data record and json2 record submission
  220 2021-06-04 change time recording back to individual records instead of 10-fold record averaging
  221 2021-06-05 introduce switch for SpeedSampling in .ino and irsamplerecord.html

  222 2021-06-06 place SpeedSampling in interrupt function IRAverageSample
  223 2021-06-08 debug interrupt function
  224 2021-06-12 define IRArray without valarry but instead with global variable IRArrayPointer 
  225 2021-06-13 manage conflict of analogReading between TimerInterrupt and MotorCurrent Sampling by locking PortMultiplexer
                 according to https://techtutorialsx.com/2017/10/07/esp32-arduino-timer-interrupts/
  226            consolidated
      
  228 2021-08-10 testing attaching ISR timer interrupt to core 0
  229 2021-08-11 debugging void SpeedSampling. For debugging analogRead in ISR timer interrupt refer to https://www.toptal.com/embedded/esp32-audio-sampling
  230 2021-08-16
  231 2021-08-17 using I2S AnalogReading DMA mode and ESP32 I2S example on HighFreq_ADC

  speedo branch in github: https://github.com/jorail/PiedPiperS/tree/speedo, develop speed-o-meter with reflective ir detector on railway sleepers, complete sleeper counting by parallel task on core0
  232 2021-08-17 core0 solution with normal analogRead (no ISR timer interrupt, no IRAM attribute required). 
  235 2021-08-18 SpeedSamplingIRSensor running as parallel task on core0 (https://randomnerdtutorials.com/esp32-dual-core-arduino-ide/, https://www.digikey.de/en/maker/projects/introduction-to-rtos-solution-to-part-12-multicore-systems/369936f5671d4207a2c954c0637e7d50), IRsamplecounter
  236 2021-08-18 optimse task and related IR recorder outputs
  237 2021-08-18 optimse code and comments, delete ISR timer interrupt remains, ca. 6 kHz IRsensor sample frequency achieved, with main loop ca. 0.75 s and 1000 power samples/main loop
  238 2021-08-19 consolidated
  239 2021-08-19 optimised lok.ini parameters, ca. 5.7 kHz IRsensor sample frequency achieved, with main loop ca. 1.76 s and 2000 power samples/main loop, irlow 0.5 V irhigh 0.7 V
  240 2021-08-19 optimise de-noising of IRsensor readings by median filter, did not work well with small number of samples for determination
  241 2021-08-19 optimise de-noising with option to skip min and max from IRSensor reading for averaging
  242 2021-08-19 optimise de-noising with option to skip min and max from IRSensor reading for averaging, ca. 5.6 kHz IRsensor sample frequency achieved, with main loop ca. 1.75 s and 2500 power samples/main loop, irlow 0.5 V irhigh 0.8 V
                 §§§potential further improvment of de-noising: count sleepers only after 3 readings above/below deadband
  243 2021-08-20 code cleaned
  244 2021-08-21 add general switch for 'SpeedSamplingOnOff' in task on core0, merged to Github PiedPiperS 'main' 2021-08-27: https://github.com/jorail/PiedPiperS

  track control, use of infrared reflective sensor TCRT5000 for reading commands from barcodes at the track
  245 2022-02-20 instantanuous speed measurement from railway sleeper interval (draft)
  246 2022-02-25 track commands from bar code
  247 2022-02-26 further optimisation
  248 2022-04-02 debugging
  249 2025-09    backukp
  
  250 2025-11-18 adjust for ESP32-C3-super-mini pinout and debugging
  251 2025-11-23 first successful running via PlatformIO, serial monitor setting baud rate and ARDUINO settings in platformio.ini:
                  monitor_speed = 115200 ;set baud rate according to serial port setup in program
                  build_flags = ;required in platformio for serial monitor to work properly
                    -D ARDUINO_USB_MODE=1
                    -D ARDUINO_USB_CDC_ON_BOOT=1
                  SPIFFS upload see: https://randomnerdtutorials.com/esp32-vs-code-platformio-spiffs/, move data folder to project top level
  252 2025-11-23 option to invert LED output by XOR logic with bool invertLED
  253 2025-11-23 switch to ESP32 C3 super mini and L293D motor IC 
  254 2025-11    same but for ESP32 devkit v1 and TLE5206 motor IC
  255 2026-01-01 same for ESP32 C3 super mini and DRV8871 motor IC with motor_speed=0 implemented as "break", i.e. HIGH pwm=255 on both motor 1 and motor 2 outputs
  256 2026-01-10 option to invertDirection via .ini file, (toggles) the logic of th motor output via XOR function 1=invert, 0=normal, leave as is
  257 2026-01-10 ESP32 C3 zero with NeoPixel LED
  258 2026-01-11 ledWrite function for normal digialWrite or neopixelWrite output
  259 2026-01-17 train light output on GPIO 6 and 7 with changig polarity, allowing white/red light switch depending on direction
  260 2026-01-31 add support for ESP32Cam module
  261 2026-02-13 add Video, see https://RandomNerdTutorials.com/esp32-cam-video-streaming-web-server-camera-home-assistant/ 
  262 2026-06-30 ESP32-C3-supermini incl. PowerSampling with analogReadMilliVolts
  263 2026-07-04 Update of infos and images on html pages
  */

#include <Arduino.h> //required at very top for VS Code and PlatformIO
// #include "SPIFFS.h" //add in file SPIFFSIniFile.h following line: #include "SPIFFS.h" //manually added in order to prevent error: 'SPIFFS' was not declared in this scope 

String SKETCH_INFO = "PiedPiperS.cpp, Version 263, GNU General Public License Version 3, GPLv3, J. Ruppert, 2026-07-04";

////////////////////////////////////////////////////////////////////////////////
// CONIFIGURATION of the microprocessor setup and PWM control for the motor IC 
////////////////////////////////////////////////////////////////////////////////

// Micro Processor Board ///////////////////////////////////////////////////////
#define ESP32          //option to adjust code for interaction with different type of microProcessor 
                       //(default or comment out or empty, i.e. the else option in the if statement = Teensy4.0)
//#define ESP32DevKit    //option to adjust pinout for interaction with ESP32-DevKit V1 DOIT Board
                       //ESP32 DEVKIT V1 DOIT board with 30 pins, https://randomnerdtutorials.com/esp32-pinout-reference-gpios/ 
//#define ESP32Cam       //option to adjust pinout for interaction with ESP32-Cam Board
                       //ESP32 Cam board with 16 pins, https://randomnerdtutorials.com/esp32-cam-ai-thinker-pinout/
#define ESP32C3mini    //option to adjust pinout for interaction with ESP32-C3-SuperMini microProcessor
                       //https://randomnerdtutorials.com/getting-started-esp32-c3-super-mini/
//#define ESP32C3zero    //option to adjust pinout for interaction with ESP32-C3-zero microProcessor
                       //https://www.waveshare.com/wiki/ESP32-C3-Zero

// Motor Driver ////////////////////////////////////////////////////////////////
//#define TLE5206        //option to adjust code for interaction with TLE5206 MotorIC
#define DRV8871        //option to adjust code for interaction with DRV8871 or DRV8833 MotorIC     
                       //(default or comment out or empty, i.e. the else option in the if statement assumes L293D MotorIC)

// Additional Inputs //////////////////////////////////////////////////////////                       
#define  PowerSampling //motor power sampling with ESP32
                       //motor voltage sampling on GBIO pin 34, ADC1_Ch6, up to ca. 1.5 V on 1 kOhm resistor of 1:11 voltage split, i.e. ca. 0 to 1.5 Vdc 
                       //motor current sampling on GBIO pin 35, ADC1_Ch7, up to ca. 0.5 A on 1 Ohm resistor, i.e. ca. 0 to 0.5 Vdc 
//#define  SpeedSampling //monitor speed on track by detecting railway sleeper passage with reflective infrared (IR) detector and ESP32
                       //IR detecter input on GPIO pin 39, ADC1_Ch3, mode INPUT with external pullup resistor ca. 33 kOhm
                       //IR detector signal is amplified by a transistor, to form a low (reflective ground, transistor links pin 39 to ground) 
                       //and high voltage levels (unreflective railway sleeper, transistor inactive, ca. 1.5 V by external 33 kOhm pullup resistor) 
                       //the external pullup resistor can be adjusted to about 27 to 47 kOhm
                       //Reading in parallel task running on core0 results in 5 to 6 kHz sample rate.
//#define ToneSampling //###### comment out, conditional for tone sampling, will be needed for FFT tone signal analysis in PiedPiper
                       //this option adjusts code for tone sampling, for use with additional electret microphone on analogue input, 
                       //sound sampling, FFT analysis and tone signal identification 
                       //this optional code sections originate unchanged from PiedPiper project, version 056:
                       //https://github.com/jorail/PiedPiper
                       //it has not been thoroughly tested in combination with PiedPiperS, version 60 through version 148 and later
                       //https://github.com/jorail/PiedPiperS                  

////////////////////////////////////////////////////////////////////////////////
// Select libraries
////////////////////////////////////////////////////////////////////////////////

#include <valarray>

#ifdef ESP32
  // Import libraries for WebServerControl module
  #include <WiFi.h> // already includes libraries #include <WiFiClient.h> and #include <WiFiAP.h>
  #include <AsyncTCP.h>
  #include <ESPAsyncWebServer.h>
  #include <DNSServer.h>
  #include <ArduinoJson.h>

  //libraries for ini file handling https://github.com/yurilopes/SPIFFSIniFile
  //#include "FS.h"           //not needed here in PlatformIO, is already included in SPIFFSIniFile.h
  //#include <SPIFFS.h>       //not needed here in PlatformIO, to be included in SPIFFSIniFile.h
  #include <SPIFFSIniFile.h>  //add in file SPIFFSIniFile.h following line: #include "SPIFFS.h" //manually added in order to prevent error: 'SPIFFS' was not declared in this scope 
#endif

#ifdef ToneSampling
  // ###### libraries conditional for tone sampling, will be needed for FFT tone signal analysis in PiedPiper
  // Import libraries for TrainMotorDriver module
  #define ARM_MATH_CM4
  #include <arduinoFFT.h>
  
  // Libraries for SoundControl module
  //#include <arm_math.h>
  //#include <dsps_fft4r.h> 
  //#include <wavelib.h>
#endif

#ifdef SpeedSampling  
  //v235, for feeding watchdog timer in task on core0, https://forum.arduino.cc/t/esp32-a-better-way-than-vtaskdelay-to-get-around-watchdog-crash/596889/13
  #include "soc/timer_group_struct.h"
  #include "soc/timer_group_reg.h"
  bool TextStatusSpeedSampling = true; //amending text message for notification to clients()
#else                       
  bool TextStatusSpeedSampling = false;  
#endif

////////////////////////////////////////////////////////////////////////////////
// Microprocessor and Development Board Pin-out definition
////////////////////////////////////////////////////////////////////////////////

#if defined(ESP32C3mini) // for ESP32-C3-SuperMini
  // input output defintions, overwrite ESP32 settings

  int input_switch  = 5;          // D13 (touch switch input: HIGH=steady state; LOW < 60 = activated, Pin 13 = Touch4 = T4 => if((touchRead(input_switch) < 60)
  //int input_switch_level = 60 ;  //+ Set high sensitivity at 60 with very short wire at Touch-Input pin, LOW value < 60 = activated (default with some longer cable at Touch-Input pin: LOW < 50 = activated)
  bool invertInputSwitch = 1;      // inverts (toggles) the logic of the digital input switch via XOR function 1=invert, 0=normal, leave as is
  int powerLED      = 8;           //+ optional output pin for power LED (use ESP32 GPIO pin D15 next to D02 onboard LED pin), alternatively, if no seperate power LED is attached, redLED pin can be used with only minor interference
  int blueLED       = 8;           // PIN of on-board blue LED for simple digitalWrite, GPIO 08 pin
  int redLED        = 8;           // use 4 if two different LED can be activated, use 8 if only one available, + PIN of on-board red LED for simple digitalWrite, after hardware modification by connection via 1kOhm resistero to D04 pin
  bool invertLED    = 1;           // inverts (toggles) the logic of all LED output via XOR function 1=invert, 0=normal, leave as is
  
  int motor2        = 1;           // D32 digital output to motor H-bridge ic input 2 setting motor direction4
  int motor1        = 0;           // D33 digital output to motor H-bridge ic input 1 setting motor direction
  int motor_enable  = 2;           // D32 PWM output to motor H-bridge ic enable setting motor speed
  int error_motoric = 2;           // motor H-bridge ic error flag, for TLE5206 on ESP32 GPIO pin 25 must be defined as input and with internal pullup-resistor, alternatively: D12 
  int motor_voltage = 4;           // ADC1_CH4 analog input for monitoring motor voltage
  int motor_current = 3;           // ADC1_CH3 analog input for monitoring motor current
  bool invertDirection = 0;        // inverts (toggles) the logic of th motor output via XOR function 1=invert, 0=normal, leave as is

  #define LEDC_TIMER_BITS   8      //+ PWM properties, use 8 bit precission for LEDC timer with 256 levels
  #define LEDC_BASE_FREQ    5000   //+ PWM properties, use 5000 Hz as a LEDC base frequency
  const int pwmChannel1   = 0;     //+ required for ESP32 in combination with either L293D, TLE5206 or DRV8871 motor ic
  const int pwmChannel2   = 1;     //+ only required in combination of ESP32 and TLE5206 or DRV8871 motor ic
  int dutyCycle           = 200;

  int light1         = 6;          // Train light output for white/red LED depening on train direction
  int light2         = 7;
  bool lightState    = 0;
  bool invertLight   = 0;          // inverts (toggles) the logic of th train light output via XOR function 1=invert, 0=normal, leave as is

  int AUDIO_INPUT_PIN = 5;         // Input D14 = ADC16 pin for audio signal.
  int LIGHT_INPUT_PIN = 5;         // Input D27 = ADC17 pin for light signal.
  int ANALOG_READ_RESOLUTION = 12; //+ Bits of resolution for the ADC. Increased to 12 bit for motro current monitoring 1 Ohm resistor and ca. 0 to 0.5 Vdc on ADC1_CH7
  int ANALOG_READ_AVERAGING = 8;   //+ Number of samples to average with each ADC reading. Recommanded for ESP32 =8. For Teensy 4.0 successfully tested with =16

#elif defined(ESP32C3zero) // for ESP32-C3-Zero
  // input output defintions, overwrite ESP32 settings

  int input_switch  = 5;          // D13 (touch switch input: HIGH=steady state; LOW < 60 = activated, Pin 13 = Touch4 = T4 => if((touchRead(input_switch) < 60)
  //int input_switch_level = 60 ;  //+ Set high sensitivity at 60 with very short wire at Touch-Input pin, LOW value < 60 = activated (default with some longer cable at Touch-Input pin: LOW < 50 = activated)
  bool invertInputSwitch = 1;      // inverts (toggles) the logic of the digital input switch via XOR function 1=invert, 0=normal, leave as is
  int rgbLED        = 10;          // RGB LED pin
  int powerLED      = 0x001F00;    // green light on RGB LED = 0x00FF00
  int blueLED       = 0x00003F;    // blue  light on RGB LED = 0x0000FF
  int redLED        = 0x3F0000;    // red   light on RGB LED = 0xFF0000
  bool invertLED    = 0;           // inverts (toggles) the logic of all LED output via XOR function 1=invert, 0=normal, leave as is

  int motor2        = 1;           // D32 digital output to motor H-bridge ic input 2 setting motor direction4
  int motor1        = 0;           // D33 digital output to motor H-bridge ic input 1 setting motor direction
  int motor_enable  = 3;           // D32 PWM output to motor H-bridge ic enable setting motor speed
  int error_motoric = 3;           // motor H-bridge ic error flag, for TLE5206 on ESP32 GPIO pin 25 must be defined as input and with internal pullup-resistor, alternatively: D12 
  int motor_voltage = 2;           // ADC1_CH2 analog input for monitoring motor voltage
  int motor_current = 4;           // ADC1_CH4 analog input for monitoring motor current
  bool invertDirection = 0;        // inverts (toggles) the logic of th motor output via XOR function 1=invert, 0=normal, leave as is

  #define LEDC_TIMER_BITS   8      //+ PWM properties, use 8 bit precission for LEDC timer with 256 levels
  #define LEDC_BASE_FREQ    5000   //+ PWM properties, use 5000 Hz as a LEDC base frequency
  const int pwmChannel1   = 0;     //+ required for ESP32 in combination with either L293D, TLE5206 or DRV8871 motor ic
  const int pwmChannel2   = 1;     //+ only required in combination of ESP32 and TLE5206 or DRV8871 motor ic
  int dutyCycle           = 200;

  int light1         = 6;          // Train light output for white/red LED depening on train direction
  int light2         = 7;
  bool lightState    = 0;
  bool invertLight   = 0;          // inverts (toggles) the logic of th train light output via XOR function 1=invert, 0=normal, leave as is
  
  int AUDIO_INPUT_PIN = 5;         // Input D14 = ADC16 pin for audio signal.
  int LIGHT_INPUT_PIN = 5;         // Input D27 = ADC17 pin for light signal.
  int ANALOG_READ_RESOLUTION = 12; //+ Bits of resolution for the ADC. Increased to 12 bit for motro current monitoring 1 Ohm resistor and ca. 0 to 0.5 Vdc on ADC1_CH7
  int ANALOG_READ_AVERAGING = 8;   //+ Number of samples to average with each ADC reading. Recommanded for ESP32 =8. For Teensy 4.0 successfully tested with =16


#elif defined(ESP32DevKit)
  // input output defintions

  int input_switch  = 13;          // D13 (touch switch input: HIGH=steady state; LOW < 60 = activated, Pin 13 = Touch4 = T4 => if((touchRead(input_switch) < 60)
  int input_switch_level = 60 ;    // Set high sensitivity at 60 with very short wire at Touch-Input pin, LOW value < 60 = activated (default with some longer cable at Touch-Input pin: LOW < 50 = activated)
  bool invertInputSwitch = 0;      // inverts (toggles) the logic of the digital input switch via XOR function 1=invert, 0=normal, leave as is
  int powerLED = 4;                // optional output pin for power LED (use ESP32 GPIO pin D15 next to D02 onboard LED pin), alternatively, if no seperate power LED is attached, redLED pin can be used with only minor interference
  int blueLED       = 2;           // PIN of on-board blue LED for simple digitalWrite, D02 pin
  int redLED        = 4;           // PIN of on-board red LED for simple digitalWrite, after hardware modification by connection via 1kOhm resistero to D04 pin
  bool invertLED    = 0;           // inverts (toggles) the logic of all LED output via XOR function 1=invert, 0=normal, leave as is
  
  int motor2        = 32;          // D32 digital output to motor H-bridge ic input 2 setting motor direction4
  int motor1        = 33;          // D33 digital output to motor H-bridge ic input 1 setting motor direction
  int motor_enable  = 25;          // D32 PWM output to motor H-bridge ic enable setting motor speed
  int error_motoric = 25;          // motor H-bridge ic error flag, for TLE5206 on ESP32 GPIO pin 25 must be defined as input and with internal pullup-resistor, alternatively: D12 
  int motor_voltage = 34;          // ADC1_CH6 analog input for monitoring motor voltage
  int motor_current = 35;          // ADC1_CH7 analog input for monitoring motor current
  bool invertDirection = 0;        // inverts (toggles) the logic of th motor output via XOR function 1=invert, 0=normal, leave as is

  #define LEDC_TIMER_BITS   8      // PWM properties, use 8 bit precission for LEDC timer with 256 levels
  #define LEDC_BASE_FREQ    5000   // PWM properties, use 5000 Hz as a LEDC base frequency
  const int pwmChannel1   = 0;     // required for ESP32 in combination with either L293D, TLE5206 or DRV8871 motor ic
  const int pwmChannel2   = 1;     // only required in combination of ESP32 and TLE5206 or DRV8871 motor ic
  int dutyCycle           = 200;

  int light1         = 14;          // Train light output for white/red LED depening on train direction
  int light2         = 15;
  bool lightState    = 0;
  bool invertLight   = 0;          // inverts (toggles) the logic of th train light output via XOR function 1=invert, 0=normal, leave as is

  int AUDIO_INPUT_PIN = 14;        // Input D14 = ADC16 pin for audio signal.
  int LIGHT_INPUT_PIN = 27;        // Input D27 = ADC17 pin for light signal.
  int ANALOG_READ_RESOLUTION = 12; // Bits of resolution for the ADC. Increased to 12 bit for motro current monitoring 1 Ohm resistor and ca. 0 to 0.5 Vdc on ADC1_CH7
  int ANALOG_READ_AVERAGING = 8;   // Number of samples to average with each ADC reading. Recommanded for ESP32 =8. For Teensy 4.0 successfully tested with =16

#elif defined(ESP32Cam)
  // input output defintions

  int input_switch  = 13;           // D13 (touch switch input: HIGH=steady state; LOW < 60 = activated, Pin 13 = Touch4 = T4 => if((touchRead(input_switch) < 60)
  int input_switch_level = 60 ;    // Set high sensitivity at 60 with very short wire at Touch-Input pin, LOW value < 60 = activated (default with some longer cable at Touch-Input pin: LOW < 50 = activated)
  bool invertInputSwitch = 0;      // inverts (toggles) the logic of the digital input switch via XOR function 1=invert, 0=normal, leave as is
  int powerLED      = 33;          // optional output pin for power LED (use ESP32 GPIO pin D15 next to D02 onboard LED pin), alternatively, if no seperate power LED is attached, redLED pin can be used with only minor interference
  int blueLED       = 33;          // PIN of on-board blue LED for simple digitalWrite, D02 pin
  int redLED        = 33;          // PIN of on-board red LED for simple digitalWrite, after hardware modification by connection via 1kOhm resistero to D04 pin
  bool invertLED    = 1;           // inverts (toggles) the logic of all LED output via XOR function 1=invert, 0=normal, leave as is
  
  int motor2        = 16;          // D32 digital output to motor H-bridge ic input 2 setting motor direction4
  int motor1        = 12;          // D33 digital output to motor H-bridge ic input 1 setting motor direction
  int motor_enable  = 4;          // D32 PWM output to motor H-bridge ic enable setting motor speed
  int error_motoric = 2;           // motor H-bridge ic error flag, for TLE5206 on ESP32 GPIO pin 25 must be defined as input and with internal pullup-resistor, alternatively: D12 
  int motor_voltage = 14;          // ADC1_CH6 analog input for monitoring motor voltage
  int motor_current = 15;          // ADC1_CH7 analog input for monitoring motor current
  bool invertDirection = 0;        // inverts (toggles) the logic of th motor output via XOR function 1=invert, 0=normal, leave as is

  #define LEDC_TIMER_BITS   8      // PWM properties, use 8 bit precission for LEDC timer with 256 levels
  #define LEDC_BASE_FREQ    5000   // PWM properties, use 5000 Hz as a LEDC base frequency
  const int pwmChannel1   = 0;     // required for ESP32 in combination with either L293D, TLE5206 or DRV8871 motor ic
  const int pwmChannel2   = 1;     // only required in combination of ESP32 and TLE5206 or DRV8871 motor ic
  int dutyCycle           = 200;

  int light1         = 14;         // Train light output for white/red LED depening on train direction
  int light2         = 15;
  bool lightState    = 0;
  bool invertLight   = 0;          // inverts (toggles) the logic of th train light output via XOR function 1=invert, 0=normal, leave as is

  int AUDIO_INPUT_PIN = 14;        // Input D14 = ADC16 pin for audio signal.
  int LIGHT_INPUT_PIN = 15;        // Input D27 = ADC17 pin for light signal.
  int ANALOG_READ_RESOLUTION = 12; // Bits of resolution for the ADC. Increased to 12 bit for motro current monitoring 1 Ohm resistor and ca. 0 to 0.5 Vdc on ADC1_CH7
  int ANALOG_READ_AVERAGING = 8;   // Number of samples to average with each ADC reading. Recommanded for ESP32 =8. For Teensy 4.0 successfully tested with =16

#else  //uP not definied, defualt for Teensy 4.0
  // input output defintions
  int input_switch  =  5;          // manual switch input: HIGH=steady state, LOW=activated
  bool invertInputSwitch = 1;      // inverts (toggles) the logic of the digital input switch via XOR function 1=invert, 0=normal, leave as is
  int powerLED = 13;               // Output pin for power LED (pin 13 to use Teensy 4.0's onboard LED).
  int blueLED      = 11;           // PIN of LED for simple digitalWrite
  int redLED        = 12;          // PIN of LED for simple digitalWrite
  bool invertLED    = 1;           // inverts (toggles) the logic of all LED output via XOR function 1=invert, 0=normal, leave as is
  int motor1        =  9;          // PWM output to motor H-bridge ic input 1
  int motor2        = 10;          // PWM output to motor H-bridge ic input 2
  int error_motoric =  4;          // motor H-bridge ic error flag
  bool invertDirection = 0;        // inverts (toggles) the logic of th motor output via XOR function 1=invert, 0=normal, leave as is

  int AUDIO_INPUT_PIN = 21;        // Input ADC pin for audio signal.
  int LIGHT_INPUT_PIN = 20;        // Input ADC pin for light signal.
  int ANALOG_READ_RESOLUTION = 10; // Bits of resolution for the ADC.
  int ANALOG_READ_AVERAGING = 16 ; // Number of samples to average with each ADC reading. Recommanded for ESP32 =8. For Teensy 4.0 successfully tested with =16
#endif

////////////////////////////////////////////////////////////////////////////////
// Main loop timing, monitoring, speed adjustments and Morse code processing
////////////////////////////////////////////////////////////////////////////////

// mainloop and monitoring
int MainLoopFrequency     =   90000;                 // Frequency for power LED flashes while void loop running (ca. 1 to 2 seconds, defined by value for main LoopCount), 
                                                     // 90000 in PiedPiperS v263
                                                     // 241000 in PiedPiperS v251 about 1 second
                                                     // default 30000 in PiedPiper v201
                                                     // 20000 in PiedPiper v199c exacts to 1 second MainLoopFrequency
                                                     // 5155 = 3.6 seconds, optimised main loop in v197 and with WebServer, with MorseDecoder, adjustSpeed
                                                     // 10000 = 1 second, optimised main loop in v197 and with WebServer, but without MorseDecoder, adjustSpeed
                                                     // 18815 on ESP32 without WebServer; 2*5059 = 2 seconds on ESP with WebServer v106
int MainLoopFrequencyDark = int(MainLoopFrequency * 0.950); // flash frequency period with unlit power LED, use number close to 1.00, when redLED is used as alternative powerLEDdefault 0.99
float MainLoopFrequencySeconds = 1;                  // vriable for measuring main loop duration and seconds between timestamps and flashes (initial value=1 will be replaced by measrured value in main loop)
std::valarray<unsigned long> Timestamp(2);           // timestamps for MainLoopFrequencySeconds, increase to Array size (11) for averaging of 10 intervals, but speed calculation will become less precise at the same time
int MonitorFrequency      = 20;                      // Frequency of monitoring switch Morse signal input and MotorCurrent (ca. 20 Hz or 0.05 second)
int MonitorLoopCounts     = MainLoopFrequency/MonitorFrequency; // Loop count for monitoring switch Morse signal input and MotorCurrent (ca. 20 Hz or 0.05 second, defined by division of main LOOP COUNT)
bool SerialMonitor        = true;                    // false = switch off Serial.print functionality in main loop for preventing delays in the speed counting

//MorseCodeDecoder
const int dotMinLength    =  200; //dots are more than 100ms long and shorter than dashMinLength
const int dashMinLength   =  800; //dashes are more than 300ms long
const int TerminalLength  = 1500; //wait after last dash/dot for termination of command
const int  morsecode_size = 12;
const char *morsecode[morsecode_size] = {".",  "..",       "...",                              "....", ".....", ".-", ".--",       ".---",             "-", "--", "---", "?"};
const char *commands[morsecode_size]  = {"--", "--------", "--------------------------------", "0",    "0<",   "++",  "++++++++", "++++++++++++++++", "0", "00", "?",   "?"};
const char *meaning[morsecode_size]   = {"decrease speed", "slow down", "break to halt", "fast brake and stop", "fast brake, stop, reverse direction", "increase speed", "speed up", "go fast", "fast brake and stop", "fast brake and stop", "info?", "info?"};
//TrackBarCode
const char *trackcode[morsecode_size] = {"111011111110", "111010000010", "111010011010", "111010011110", "111010010110", "111011000010", "111010101010", "11101?????10", "11101?????10", "11101?????10", "11101?????10", "11101?????10"};
const char *trackcommands[morsecode_size]   = {"00", "--------------------------------", "--------0<", "--------0<++++++++", "--------0www++++++++", "-d-d-d-d-d-d-d-d-d-d-d-d-", "rgrgrgr", "g", "g", "g", "g", "g"};
const char *barcodemeaning[morsecode_size]  = {"fast brake and stop", "break to halt", "break reverse", "break reverse speed up", "break wait speed up", "very slow break to halt", "alternating bar code recognised", " ", " ", " ", " ", " "};
//acceleration is limited to half full speed, i.e. 8x '+' character, while full break is from max and any speed to halt, i.e. 16x '-' character
//use fast brake to immediatly stop the motor by command charcter '0',
//'<'   stands for reverse of direction, which can only be done after a safe full halt, thus multiple leading '0' characters are introduced in front for train inertia
const int MAX_CHARS      = 65;   // Max size of the input command buffer

#ifdef PowerSampling
  int PowerSampleFrequency = 1000; //Frequency of monitoring power data, ca. 1000 Hz,
  int PowerSampleLoopCounts = int(MainLoopFrequency/PowerSampleFrequency);
  std::valarray<int> MotorVoltageArray(PowerSampleFrequency);
  // Offset and Slope are not relevant, if analogReadMilliVolts is used for ESP32-C3-SuperMini or ESP-C3-Zero microprossesors as in PiedPiperS v263
  const float MotorVoltageOffset = 1514.1; //linear parametrisation of stepup converter output voltage in mV with 1/11 kOhm voltage split, y = 8.8878 x + 1514.1. x= anolg reading@pin34, y= multimeter voltage in mV@stepup converter output   2021-04-25
  const float MotorVoltageSlope  = 8.8878; //linear parametrisation of stepup converter output voltage in mV from measurments 2021-04-25
  int MotorVoltageAverage        = 0;      // in millivolts (mV)
  std::valarray<int> MotorCurrentArray(PowerSampleFrequency);
  const float MotorCurrentOffset = 133;    //153     128;   //linear parametrisation of motor current readings from measurments 2021-04-23
  const float MotorCurrentSlope  = 0.91;   //0.8     1.2;   //linear parametrisation of motor current readings from measurments 2021-04-23
  int MotorCurrentAverage        = 0;      // in milliamperes (mA)
  float MotorPower               = 0;      // in Watt (W)
#endif

//////////////////////////////////////////////////////////////////////////////////////////////////
// CONIFIGURATION SpeedSampling by reflective IR detector for railway sleepers and ESP32 counter
// ///////////////////////////////////////////////////////////////////////////////////////////////
#ifdef SpeedSampling
  bool SpeedSamplingOnOff=true;
  bool SpeedFromSleeperInterval=true;

  //global variables for SpeedSampling
  int SpeedSampleFrequency = 5000; //Frequency of monitoring IR sensor for speed sampling, ca. 15000 Hz, with averaging of 3 samples resulting effectively in 5000 Hz
  int IRSampleAveraging = 5;  //attenuation of IR signal, ajust according to max. speed counting frequency, default 5, increase if signal is very noisy
  int SpeedSampleLoopCounts = int(MainLoopFrequency/SpeedSampleFrequency);
  int SpeedLEDLoopCounts    = int(SpeedSampleLoopCounts*IRSampleAveraging);
  bool SpeedLED = true; //for switching on/off speed LED indicator in case of railway sleeper detected by reflective IR sensor
  std::valarray<unsigned long> IRSampleCount(2);
  std::valarray<unsigned long> SpeedCount(2);
  std::valarray<int> SpeedCountDifference(2);
  float SpeedCountDistance = 0.18/24; //distance of one sleeper in meters/count, i.e. from one railway sleeper to the next, 
  //center to center, e.g. 0.18 m = 180 mm length of one piece of track devided by 24 railway sleepers on Maerklin M straight track 5106
  float Speed = 0; // in m/s
  float SpeedAtScale = 0; // in km/h at model scale
  float Scale = 87; //model scale, Spur 1 = 32, H0 = 87, TT = 120, N = 160

  //global variables for TrackInterval and TrackBarCode sampling
  unsigned long PreviousSpeedCounter; //for triggering SleeperInterval assessment in main loop
  int SleeperIntervalArray[5]; //for evaluating median SleeperInterval and instantanuous speed measurment, array rotation and update is done in function SleperIntervalCalculation()
  int SleeperIntervalMedian = 10; // prevent division by 0 for instantanuous speed measurement
  String TrackBarCode = ""; // (00000)11101?????10 reading of bar codes on the railway track (initiated by 5 blanks = white spaces = 0), followed by wide (size three) black bar "111", "01" for check on correct bar code recognition, 5x ? allows for 2^5 = 32 different commands
    
  //global variables for core0 task SpeedSamplingIRSensor() analog readings
  //all variables are "one-way" i.e. no shared writing on variables between interrupt and main loop
  //task is reading from variables:
  volatile int ir_sensor = 39; // GPIO pin 39 is depicted with 'VN' on ESP32 DevKit V1 board
  volatile int IRlow = 600;    //IR analog signal high level threshold in mV, choose value > 150 mV due to analogue input reading offset, default 600 mV
  volatile int IRhigh = 1100;  //IR analog signal high level threshold in mV, default 1100 mV
  //task writes to variables:
  volatile int IRArray[10];    //maximum of 10 for IRSampleAveraging, but only those defined by IRSampleAveraging will be in use in Interrupt Function SpeedSamplingIRSensor()
  volatile int IRArrayPointer; // indicates next position for overwriting
  volatile int IRAverage = 0;
  volatile bool IRAverageSample = false; // IRAverageSample for IR sample recorder: false = raw IR signal, true = use averaged sample
  volatile bool IRSkipMinMax = false;    // IRAverageSample for IR sample recorder: false = use averaged sample, true = skip min and max values for determining the average (introduced in version v241)
  volatile bool SleeperDetected = true;  //start with true value, in order to avoid rising edge count at startup
  volatile unsigned long SpeedCounter = 0;
  volatile unsigned long SleeperIntervalTimestamp = 0; // milliseconds
  volatile int SleeperInterval = 0; // milliseconds, detecttion of interval between two railway sleepers for 1. instantanuous speed measurement and 2. setting interval for track command bar code reading
  bool TrackSampling = false; //flag true, when start sign (> 4 white railway sleeper intervals) is recognised
  int TrackMillis[12];
  int TrackInterval=0;
  
  //IR Sample recording and assessment
  unsigned long IRSampleCounter = 0; // counting number of effective analogReadings on IRSensor
  bool IRSampleRecording = false;
  int IRSampleRecord[500]; //array for display of 500 (nearly consecutive) original IRSensor samples, recorded in main loop from current values produced in parallel core0 task with similar frequency
  int SpeedCountTotal =0;
  int SpeedCountLastTotal =0; 
  unsigned long SpeedCountStartMilli = 0;
  float SpeedCountLastSeconds = 0;
  float LastSpeed = 0; // in m/s, as of last IRSampleRecording: SpeedCountLastTotal*SpeedCountDistance/SpeedCountLastSeconds
  float LastSpeedAtScale = 0; // in km/h at model scale
  bool RoundMarkerDetected = false; //Detection of RoundMarker (= strech with white reflective track ground, paper or tape on track)
#endif

#if defined(PowerSampling) || defined(SpeedSampling)
  // SpeedSampleIRSensorTask settings https://www.digikey.de/en/maker/projects/introduction-to-rtos-solution-to-part-12-multicore-systems/369936f5671d4207a2c954c0637e7d50, https://randomnerdtutorials.com/esp32-dual-core-arduino-ide/
  TaskHandle_t SpeedSampleIRSensorTaskHandle; //Task created to setup parallel processing of analogReading of IR sensor on core0, v232
  portMUX_TYPE analogReadMux = portMUX_INITIALIZER_UNLOCKED; //preventing analogReading conflicts between task on core0 and main loop functions on core1, compare ISR timer interrupt application in https://techtutorialsx.com/2017/10/07/esp32-arduino-timer-interrupts/
  //void IRAM_ATTR SpeedSamplingIRSensor(); //define empty function name before task attachment (was needed in case of timer interrupt, not required for core0 parallel task)
#endif

////////////////////////////////////////////////////////////////////////////////
// CONIFIGURATION tone signal analysis
// ###### conditional for tone sampling, will be needed for FFT tone signal analysis in PiedPiper
// <=######## These values can be changed to alter the behavior of the FFT tone analysis.
// Some values relate to the spectrum display. 
// ////////////////////////////////////////////////////////////////////////////////
#ifdef ToneSampling
  //toneLoop, parameters for tone signal detection
  int SAMPLE_RATE_HZ = 5120;             // Sample rate of the audio in hertz. Default= 9000 Hz => resolution 37 Hz; increased resolution = 5120 => resolution = 20 Hz => highest detectable frequency = 2500 Hz
  const int FFT_SIZE = 256;              // Size of the FFT.  Realistically can only be at most 256 = default: Frequency bin siez (Hz) = SAMPLE_RATE_HZ/FFT_SIZE
  float TONE_THRESHOLD1_DB = 11.0;       // <=########## Sensitivity threshold (in decibels) for energy in tone window, which must be above energy in other frequencies for successful detection, default 10.0. in quite room, default 12.0 with speach in the environment
  std::valarray<int> tone_array(8);      // <=########## setting room for gliding average of tones detected in tone loop, default tone_array size = 10, lower values for faster response time
  float TONE_THRESHOLD2_DB = 9.0;        // <=########## Sensitivity threshold (in decibels) for the gliding average of tones, which must be above other frequencies for successful, default 15.0 in quite room, default 14.0 in noisy environment
  int  LIGHT_THRESHOLD = 20;             // <=######## if below threshold then the light signal is active, choose analog input threshold value between 1 and 1023
  int TONE_FREQ_OFFSET = int(200/(SAMPLE_RATE_HZ/FFT_SIZE)); // Default 200 Hz converted into number of low frequency bins to be skipped for 'windowMean' evaluation and difference of energy in window vs. in other frequencies
  const int TONE_LOWS[] = {              // <=########## Lower bound (in hz) of each tone in the input tone window (or sequence). Default single tone = h'' = 988 Hz. Default tone sequence: 1723, 1934, 1512, 738, 1125. 
    988
  };
  const int TONE_HIGHS[] = {             // <=########## Upper bound (in hz) of each tone in the input tone window (or sequence). Default single tone = h'' = 988 Hz. Default tone sequence: 1758, 1969, 1546, 773, 1160. 
    988
  };
  // Margin for calculation of the low and high frequency bin limites for the currently expected tone.
  int TONE_ERROR_MARGIN_HZ = 50;         // <=########## Allowed fudge factor above and below the bounds for each tone input. Default = 50 Hz
  
  // Tone sequence detection
  int tonePosition = 0;                  // start with first TONE_LOWS[] and TONE_HIGH[], multible values in the array allow for tone sequence code detection
  int TONE_WINDOW_MS = 4000;             // Maximum amount of milliseconds allowed to enter the full tone sequence detection, default 4000. without running out of memory for buffers and other state

/* Tone frequency table, keep this information for adjusting FFT analysis in the code
Tone Hertz      Tone Hertz      Tone Hertz        Tone    Hertz       Tone   Hertz
''A  27,50      C   65,41       c'    261,63      c'''    1.046,50    c''''' 4.186,01
''B  29,14      Des 69,30       des'  277,18      des'''  1.108,73           
''H  30,87      D   73,42       d'    293,66      d'''    1.174,66           
'C   32,70      Es  77,78       es'   311,13      es'''   1.244,51           
'Des 34,65      E   82,41       e'    329,63      e'''    1.318,51           
'D   36,71      F   87,31       f'    349,23      f'''    1.396,91           
'Es  38,89      Ges 92,50       ges'  369,99      ges'''  1.479,98           
'E   41,20      G   98,00       g'    392,00      g'''    1.567,98           
'F   43,65      As  103,83      as'   415,30      as'''   1.661,22           
'Ges 46,25      A   110,00      a'    440,00      a'''    1.760,00           
'G   49,00      B   116,54      b'    466,16      b'''    1.864,66           
'As  51,91      H   123,47      h'    493,88      h'''    1.975,53           
'A   55,00      c   130,81      c''   523,25      c''''   2.093,00           
'B   58,27      des 138,59      des'' 554,37      des'''' 2.217,46           
'H   61,74      d   146,83      d''   587,33      d''''   2.349,32           
                es  155,56      es''  622,25      es''''  2.489,02           
                e   164,81      e''   659,26      e''''   2.637,02           
                f   174,61      f''   698,46      f''''   2.793,83           
                ges 185,00      ges'' 739,99      ges'''' 2.959,96           
                g   196,00      g''   783,99      g''''   3.135,96           
                as  207,65      as''  830,61      as''''  3.322,44           
                a   220,00      a''   880,00      a''''   3.520,00           
                b   233,08      b''   932,33      b''''   3.729,31           
                h   246,94      h''   987,77      h''''   3.951,07           
*/
#endif

////////////////////////////////////////////////////////////////////////////////
// INTERNAL STATE and variable initialisation
// These shouldn't be modified unless you know what you're doing.
////////////////////////////////////////////////////////////////////////////////

#ifdef ToneSampling
  //###### conditional for tone sampling, will be needed for FFT tone signal analysis in PiedPiper
  //toneLoop
  IntervalTimer samplingTimer;  //###TODO correct for use of code with ESP32, compare ISR timer interrupt application in https://techtutorialsx.com/2017/10/07/esp32-arduino-timer-interrupts/
  float samples[FFT_SIZE * 2];
  float magnitudes[FFT_SIZE];
  
  int sampleCounter = 0;
  unsigned long toneStart = 0;
#endif

char commandBuffer[MAX_CHARS];

// mainloop and monitoring
int LoopCount = 0;            // Monitor the void loop running by flashing power LED
int FLASH_COUNT = 0;

int TONE_LoopCount =0; 
int TONE_ACTIVE_COUNT =0;  
String speed_command = "";     // variable for parsing the execution of a morse command
int speed_wait_countdown = 0;  // loop count for delay of next step of speed adjustment, set to 0 for immediate execution of new speed_command
int speed_level = 0;           // speed_level for PWD output to motor
int max_speed_level = 32;      // maximum speed level, default =32 in odrder to get smooth speed increase/decrease, adjust SpeedAdjustmentFrequency and number of *commands speed adjust symbols in appropriately 
                               // (max_speed_level=16 as simplified method up to version 028 with half the number of command symbols)
bool speed_direction = true;   // true=forward, false=backward

//speed adjustment, defined as variables for later adjustment of following default values by reading values from .ini in setup()
float motor_voltage_supply   = 9.5;                 // indicate motor voltage supply level in Vdc, as adjusted at step-up converter output
float motor_voltage_start = 6.0;                    // equivalent voltage for first speed level PWM setting
float speedoffset = 1- ((motor_voltage_supply - motor_voltage_start)/(max_speed_level - 1) * max_speed_level / motor_voltage_supply) ; 
// offset of pulse width modulation (PWM) for speed_level "0" as ratio of maximum pulse width, default 0.60 @ 9.5 V dc, 0.50 @ 10 Vdc, 0.30 @ 12Vdc, default 0.25 @ 16Vdc
int SpeedAdjustmentFrequency = 5;                   // frequency of speed adjustment per MainLoopFrequency in main loop, default = 5, ca. 0.2 seconds
int speed_wait_loops = MonitorFrequency / SpeedAdjustmentFrequency; // Number of monitoring loops for delay of next step of speed adjustment, default = ca. 0.5 seconds = SpeedAdjustmentFrequency =2

// variables from whistle004.ino, partially obsolete?
int Intensity = 0;
int IntensityStep = 8;
int switch_ok = HIGH;          // (not used in version 030)
int motor_ok = HIGH;           // motor ic error flag (not used in version 030 to 45)
int sound = 0;

// variables from MorseCodeDecoder

#ifdef ESP32
  // ESP touch sensor multiple reading for robust results, preventing false positive switch_signals
  std::valarray<int> touch_array(5);      // for assessment of gliding average of touch readings in Morse signal detection loop, default touch_array size = 10, lower values for faster response time
#endif

bool switch_signal        = HIGH;
bool tone_signal          = false;
bool light_signal         = false;
// int  light_level       = 0;    //disabled light level reading
unsigned long SignalTimer = 0;    //for recording the time how long the button was pressed
int SignalDuration        = 0;
bool SignalActive         = false;
bool shortSignalActive    = false;
bool longSignalActive     = false;
bool verylongSignalActive = false; //2xlongSignal as additional signal for emergency brake
bool SignalTerminated     = true;
String currentSignal      = ""; //string to hold what is currently being signalled, complete Morse command after termination




////////////////////////////////////////////////////////////////////////////////
// .ini file handling, according to https://github.com/yurilopes/SPIFFSIniFile, GNU GPL v3
////////////////////////////////////////////////////////////////////////////////
#ifdef ESP32 

  //initialize ini file variables, path to .ini file and buffer length for .ini file line readings
  String inipath           = "";   //initialize pointer to inipath with maximum path length
  const size_t bufferLen   = 41;   //maximum .ini file line length of 40 characters plus '\0' character
  char buffer[bufferLen];
  char loconame[bufferLen] = {0};
  char ssid[bufferLen]     = {0};
  char password[bufferLen] = {0};
  int  channel             = 1;    //default WLAN channel

//for debugging .ini file reading errors
void printErrorMessage(uint8_t e, bool eol = true) {
  switch (e) {
  case SPIFFSIniFile::errorNoError:
    Serial.print("no error");
    break;
  case SPIFFSIniFile::errorFileNotFound:
    Serial.print("file not found");
    break;
  case SPIFFSIniFile::errorFileNotOpen:
    Serial.print("file not open");
    break;
  case SPIFFSIniFile::errorBufferTooSmall:
    Serial.print("buffer too small => ");
    Serial.print("limit .ini line length to bufferLen (default 40 characters!)");
    break;
  case SPIFFSIniFile::errorSeekError:
    Serial.print("seek error");
    break;
  case SPIFFSIniFile::errorSectionNotFound:
    Serial.print("section not found");
    break;
  case SPIFFSIniFile::errorKeyNotFound:
    Serial.print("key not found");
    break;
  case SPIFFSIniFile::errorEndOfFile:
    Serial.print("end of file");
    break;
  case SPIFFSIniFile::errorUnknownError:
    Serial.print("unknown error");
    break;
  default:
    Serial.print("unknown error value");
    break;
  }
  if (eol)
    Serial.println();
}
#endif

////////////////////////////////////////////////////////////////////////////////
////////////////////////////////////////////////////////////////////////////////
// Declare additional functions (which are defined at the very end) ////////////
////////////////////////////////////////////////////////////////////////////////
////////////////////////////////////////////////////////////////////////////////

void SetupLoopCounts();
void ledWrite(int output, int state);
void adjustSpeed();
void InfoText();
void motor_set (int v);
void IndicateMotorError();
void monitor_global_variables();
void parserLoop();
void parseCommand(char* command);
void MorseCodeDecoder();
void TRACK_BAR_CODE (const char* command);
void MORSE_CODE (const char* command);
void setLight (bool state);

#ifdef ESP32 
	void CLIENT_COMMAND (const char* command);
#endif

#ifdef PowerSampling
	void MotorVoltagCurrentSampling();
  void PowerCalculation();
#endif	

#ifdef SpeedSampling
	void SpeedCalculation();
  void SpeedSamplingIRSensor( void * pvParameters );
  int SleeperIntervalCalculation();
#endif

#ifdef ToneSampling
	void toneLoop();
	void toneSequenceDetected();
	void samplingCallback();
	void samplingBegin();

	void windowMean(float* magnitudes, int lowBin, int highBin, float* windowMean, float* otherMean);
	int frequencyToBin(float frequency);
	float intensityDb(float intensity);
#endif


////////////////////////////////////////////////////////////////////////////////
// Create Server Module for ESP32  /////////////////////////////////////////////
////////////////////////////////////////////////////////////////////////////////
#ifdef ESP32 

//Create DNS Server on port 53
const byte DNS_PORT = 53;
DNSServer dnsServer;

// Create AsyncWebServer object on port 80
AsyncWebServer server(80);
AsyncWebSocket ws("/ws");

// Create CaptivePortal, redirect used for any specific device requests for captive portal handling
void captivePortalTarget(AsyncWebServerRequest *request) {
      AsyncResponseStream *response = request->beginResponseStream("text/html");
      response->print("<!DOCTYPE html><html><head><title>Infos zur Lokomotivsteuerung</title>");
      response->print("<meta name=\"viewport\" content=\"width=device-width, initial-scale=1\" charset=\"utf-8\"/>");
      response->print("<style>body{max-width: 1024px; font-size: 1.0rem; font-family: Helvetica; display: inline-block; padding:2%; margin:2% auto; text-align: left;}");
      response->print("h1 {font-size: 1.6rem;} h2 {font-size: 1.2rem;}</style></head><body>");
      response->printf("<h1>Startseite zur Loksteuerung</h1>");
      response->printf("<p>Dies ist die automatische Startseite des ESP32 WLAN-Servers (CaptivePortalTarget). ");
      response->printf("Du hast versucht folgende Seite zu erreichen und bist zur Startseite geleitet worden:</p>");
      response->printf("<p>http://%s%s</p>" , request->host().c_str(), request->url().c_str());
      response->printf("<p>Der ESP32 hat keinen Internet&shy;zugang. Du kannst aber &uuml;ber die Verbindung von deinen Browser zum ESP32 WLAN-Server eine Lokomotive steuern. ");
      response->printf("Es k&ouml;nnen immer nur drei WLAN-Nutzer (Stations) gleichzeitig mit dem WLAN-Netzwerk (AccessPoint) Verbindung aufnehmen. </p>"); 
#ifdef PowerSampling
      response->printf("<h2><a href='/power.html'>Leistungsaufnahme des Lokmotors</a></h2>");
#endif
      response->printf("<h2><a href='http://%s/'>Loksteuerung</a> &nbsp;&nbsp; <a href='http://%s/info'>weitere Informationen</a></h2>", WiFi.softAPIP().toString().c_str(), WiFi.softAPIP().toString().c_str());
      response->printf("<div><a href='http://%s/'><img src=\"/lok.png\" alt='Loksteuerung' style='width:100%%'></a></div>", WiFi.softAPIP().toString().c_str());      
      response->printf("<p>Viel Spa&szlig; beim Zugfahren und Ausprobieren! Jo</p><br>");
      response->printf("<p>Laufender c++ <b><a href='/license.html'>Code</a></b> ist: </p>");
      response->printf("<p>%s</p>", SKETCH_INFO.c_str());
      response->printf("<p>%i WLAN-Nutzer <br>(Stations connected to Access Point)</p>", WiFi.softAPgetStationNum());
      response->print("</body></html>");
      request->send(response);
};

class CaptiveRequestHandler : public AsyncWebHandler {
  public:
    CaptiveRequestHandler() {}
    virtual ~CaptiveRequestHandler() {}
    bool canHandle(AsyncWebServerRequest *request) {
      request->addInterestingHeader("ANY");
      return true;
    }
    void handleRequest (AsyncWebServerRequest *request) {
       //request->redirect("/portal");
      AsyncResponseStream *response = request->beginResponseStream("text/html");
      response->print("<!DOCTYPE html><html><head><title>Infos zur Lokomotivsteuerung</title>");
      response->print("<meta name=\"viewport\" content=\"width=device-width, initial-scale=1\" charset=\"utf-8\"/>");
      response->print("<style>max-width: 1024px; body{font-size: 1.0rem; font-family: Helvetica; display: inline-block; padding:2%; margin:2% auto; text-align: left;}");
      response->print("h1 {font-size: 1.6rem;} h2 {font-size: 1.2rem;}</style></head><body>");
      response->printf("<h1>Startseite zur Loksteuerung</h1>");
      response->printf("<p>Dies ist die automatische Startseite des ESP32 WLAN-Servers (CaptiveRequestHandler). ");
      response->printf("Du hast versucht folgende Seite zu erreichen und bist zur Startseite geleitet worden:</p>");
      response->printf("<p>http://%s%s</p>" , request->host().c_str(), request->url().c_str());
      response->printf("<p>Der ESP32 hat keinen Internetzugang. Du kannst aber &uuml;ber die Verbindung von deinen Browser zum ESP32 WLAN-Server eine Lokomotive steuern. ");
      response->printf("Es k&ouml;nnen immer nur drei WLAN-Nutzer (Stations) gleichzeitig mit dem WLAN-Netzwerk (AccessPoint) Verbindung aufnehmen. </p>"); 
#ifdef PowerSampling
      response->printf("<h2><a href='/power.html'>Leistungsaufnahme des Lokmotors</a></h2>");
#endif
      response->printf("<h2><a href='http://%s/'>Loksteuerung</a> &nbsp;&nbsp; <a href='http://%s/info'>weitere Informationen</a></h2>", WiFi.softAPIP().toString().c_str(), WiFi.softAPIP().toString().c_str());
      response->printf("<div><a href='http://%s/'><img src=\"/lok.png\" alt='Loksteuerung' style='width:100%%'></a></div>", WiFi.softAPIP().toString().c_str());      
      response->printf("<p>Viel Spa&szlig; beim Zugfahren und Ausprobieren! Jo</p><br>");
      response->printf("<p>Laufender c++ <b><a href='/license.html'>Code</a></b> ist: </p>");
      response->printf("<p>%s</p>", SKETCH_INFO.c_str());
      response->printf("<p>%i WLAN-Nutzer <br>(Stations connected to Access Point)</p>", WiFi.softAPgetStationNum());
      response->print("</body></html>");
      request->send(response);
    }
};
#endif

////////////////////////////////////////////////////////////////////////////////
// WebSocket Module for ESP32
////////////////////////////////////////////////////////////////////////////////
#ifdef ESP32 

//pre-declare functions in WebSocket Module and .ini-file handling, defined only after first call
void handleWebSocketMessage(void *arg, uint8_t *data, size_t len); 
void INI_ACTION(uint8_t *data);
void writeFile(fs::FS &fs, const char * path, const char * message);
void iniSetup();

//Websocket Event
void onEvent(AsyncWebSocket *server, AsyncWebSocketClient *client, AwsEventType type,
             void *arg, uint8_t *data, size_t len) {
  switch (type) {
    case WS_EVT_CONNECT:
      Serial.printf("WebSocket client #%u connected from %s\n", client->id(), client->remoteIP().toString().c_str());
      break;
    case WS_EVT_DISCONNECT:
      Serial.printf("WebSocket client #%u disconnected\n", client->id());
      break;
    case WS_EVT_DATA:
      Serial.println("");
      Serial.println("WebSocket event data received, handle WS message");
      handleWebSocketMessage(arg, data, len);
      break;
    case WS_EVT_PONG:
    case WS_EVT_ERROR:
      break;
  }
}

//Create WebSocket
void initWebSocket() {
  ws.onEvent(onEvent);
  server.addHandler(&ws);
};

// Websocket input processing
String client_message ="Bereit..."; //intial command message on index.html 

//Evaluate Websocket Message
void handleWebSocketMessage(void *arg, uint8_t *data, size_t len) {
  AwsFrameInfo *info = (AwsFrameInfo*)arg;
  if (info->final && info->index == 0 && info->len == len && info->opcode == WS_TEXT) {
    Serial.println("+ WebSocket message received with following data in client_message: "); //echo received message for test and monitoring
    data[len] = 0; // null termination for char data
    client_message = (char*)data;
    Serial.println(client_message); //echo received message for test and monitoring
    //ws.textAll(client_message);   //echo websocket received message for test and debugging
    
    if (client_message[0]=='=' || client_message[0]=='+' || client_message[0]=='-' || client_message[0]=='0' || client_message[0]=='?' || client_message[0]=='<' || client_message[0]=='L') {
      CLIENT_COMMAND(client_message.c_str()); //compilation type problem solved by .c_str()       
    }

    #ifdef SpeedSampling
      else if (client_message[0]=='l') { //toggle speed indicator LED from speed.html
        SpeedLED = !SpeedLED;
        SpeedFromSleeperInterval = !SpeedFromSleeperInterval; //######################## simply in parallel to SpeedLED flag, TODO: devolop individual switch or general setting, when functioning is validated
        if (!SpeedLED) {
          ledWrite(blueLED, LOW );    // shut off LED, when indication is switched off 
        }
      }
      else if (client_message[0]=='s' && client_message[1]=='1') { //speedsampling on from irsamplerecorder.html
        SpeedSamplingOnOff = true;
      }
      else if (client_message[0]=='s' && client_message[1]=='0') { //speedsampling off from irsamplerecorder.html
        SpeedSamplingOnOff = false;
      }
      else if (client_message[0]=='r' && client_message[1]=='1') { //irrecording on from irsamplerecorder.html
        IRSampleRecording = true;
      }
      else if (client_message[0]=='r' && client_message[1]=='0') { //irrecording off from irsamplerecorder.html
        IRSampleRecording = false;
      }
      else if (client_message[0]=='a' && client_message[1]=='1') { //IR average sample on from irsamplerecorder.html
        IRAverageSample = true;
      }
      else if (client_message[0]=='a' && client_message[1]=='0') { //IR average sample off from irsamplerecorder.html
        IRAverageSample = false;
      }
      else if (client_message[0]=='x' && client_message[1]=='1') { //IR average sample with skipping of min max values on from irsamplerecorder.html
        IRSkipMinMax = true;
      }
      else if (client_message[0]=='x' && client_message[1]=='0') { //IR average sample with skipping of min max values off from irsamplerecorder.html
        IRSkipMinMax = false;
      }
      else if (client_message[0]=='i' && client_message[1]=='r' && client_message[2]=='l' && client_message[3]=='=') { 
        //adjust IRlow setting from irsamplerecorder.html, start reading client message at position [4] for new number in mV
        IRlow = atoi(&client_message[4]);
      }
      else if (client_message[0]=='i' && client_message[1]=='r' && client_message[2]=='h' && client_message[3]=='=') { 
        //adjust IRlow setting from irsamplerecorder.html, start reading client message at position [4] for new number in mV
        IRhigh = atoi(&client_message[4]);
      }
      else if (client_message[0]=='z') { //zero speed counter
        SpeedCount[0] = 0;
        SpeedCount[1] = 0;
        SpeedCountDifference[0] = 0;
        SpeedCountDifference[1] = 0;
        SpeedCounter  = 0;
      }
    #endif

    else if (client_message[0]=='m' && client_message[1]=='1') { //Switch on Serial monitoring with Serial.print output in MonitorGlobalVariables on from irsamplerecorder.html
      SerialMonitor = true;
    }
    else if (client_message[0]=='m' && client_message[1]=='0') { //Switch off Serial monitor for complete speed counting and preventing delay in main loop 
      SerialMonitor = false;
    }

    else if (client_message[0]=='{') {
      Serial.println("+ { at start of client_message indicates JSON syntax for interpretation in function INI_ACTION()" ); //echo received message for test and monitoring 
//          AsyncResponseStream *response = request->beginResponseStream("application/javascript");
//          response->printf("      window.alert(\'JSON client_message identified: %s\');  ", client_message.c_str());
//          request->send(response);
        INI_ACTION(data);
    }
//          writeIni (&client_message.c_str());
    
    else if (client_message[0]=='#') {
      Serial.println("+ sign '#' identified comment in client_message: ");
      Serial.println(client_message);
      Serial.println();
//          AsyncResponseStream *response = request->beginResponseStream("application/javascript");
//          response->printf("      window.alert(\'comment with # character at start of client_message identified: %s\');  ", client_message.c_str());
//          request->send(response);
    }
    else {
      Serial.println("charcter at start of client_message not identified :" ); //echo received message for test and monitoring 
//          AsyncResponseStream *response = request->beginResponseStream("application/javascript");
//          response->printf("      window.alert(\'character at start of client_message not identified: %s\');  ", client_message.c_str());
//          request->send(response);
    }       
  }
}

// manage action on .ini file
void INI_ACTION(uint8_t *data) {
  String json_message = (char*)data;
  const size_t capacity = JSON_OBJECT_SIZE(3) + json_message.length() + 128;
  Serial.print("+ sizeof JSON message, capacity of jsondoc: ");  
  Serial.print(sizeof(json_message));   
  Serial.print(" : ");   
  Serial.println(capacity); 
  Serial.print(" : ");   
  Serial.println(json_message); 
  DynamicJsonDocument jsondoc(capacity);
  deserializeJson(jsondoc, json_message);

  const char* iniaction = jsondoc["iniaction"]; // "save"
  String inifilestring  = jsondoc["inifile"];   // default "lok.ini"
  inifilestring.toLowerCase();
  inipath = "/"; 
  inipath += inifilestring;
  String iniedit = jsondoc["iniedit"]; // "# lok.ini max line length = buffer = 40\n[loco]\nname = grüne ELok BR 151\n ...
  //Serial.println(jsondoc);
  Serial.print("+ iniaction: ");  
  Serial.println(iniaction); 
  Serial.print("+ inipath: ");  
  Serial.println(inipath); 
  Serial.print("+ iniedit: ");  
  Serial.println(iniedit); 

  if (strcmp(iniaction,"save")==0) {
    Serial.print("+ save ini file: ");  
    writeFile(SPIFFS, inipath.c_str() , iniedit.c_str());
    return;
  }
  
  else if (strcmp(iniaction,"load")==0) {
    Serial.print("+ select .ini file ");
    Serial.println(inipath);  
    Serial.print("+ setup program and load with new .ini file ...");
    delay (1000);
    iniSetup(); //does not work for re-loading wifi settings and pinout, use restart for that
    speed_command = "ggg";  // three green/blue very long flashes 
    return;
  }

  else if (strcmp(iniaction,"start")==0) {
    Serial.print("+ restart with .ini file ");
    Serial.println(inipath);  
    Serial.print("+ restart program and load with new .ini file ...");
    delay (1000);
    ESP.restart(); // LED flash indication at restart   §§§§§§§§§§§§§§§§§§§§§§§§ not working properly
    return;
  }

  else {
    Serial.println("- iniaction could not be interpreted!");
  }
}

// write .ini file
void writeFile(fs::FS &fs, const char * path, const char * message){
    Serial.printf("+ Writing .ini file: %s\r\n", path);

    File file = fs.open(path, FILE_WRITE);
    if(!file){
        Serial.print("- failed to open file for writing: ");
        Serial.println(path);
        speed_command = "rrr";  // three red very long flashes  
        return;
    }
    if(file.print(message)){
        Serial.print("+ file written: ");
        Serial.println(path);
        speed_command = "ggg";  // three green/blue very long flashes 
    } 
    else {
        Serial.print("- file write failed: ");
        speed_command = "ggr";  // two green/blue and one red very long flashes
        Serial.println(path);
    }
    file.close();
}

// Send WebSocket Message as JSON Document to all clients
void notifyClients() {
  // Compute the capacity for the JSON document,
  // which is used to exchange status information 
  // and commands via WebSocket
  // adjust according to members in JSON document, 
  // see https://arduinojson.org/v6/assistant/
  const uint8_t size = 192; //JSON_OBJECT_SIZE(3);
  StaticJsonDocument<size> json;
  String TextStatus ="";
  if (speed_direction) {
    TextStatus="Vorwärts &nbsp;";
  }
  else {
    TextStatus="Rückwärts &nbsp;";
  }
  #ifdef SpeedSampling
    if(TextStatusSpeedSampling) { //TextStatus in case of #ifdef SpeedSampling
      TextStatus = TextStatus + String(int(SpeedAtScale))+" km/h &nbsp;" + String(MotorPower, 1) + " Watt";
    }
    else { //TextStatus in case of !#ifdef Speedsampling
      TextStatus = TextStatus + String(speed_level*5)+" km/h &nbsp;" + String(MotorPower, 1) + " Watt";
    }
  #endif
  json["status"] = TextStatus;
 
  String TextSpeed ="";
  for (int i = 0;  i< speed_level/2; ++i) {
    if (speed_direction) {
      TextSpeed =  TextSpeed + " >";
    }
    else {
      TextSpeed =  TextSpeed + " <";
    }  
  }

  json["speed"] = TextSpeed;
  json["command"] = client_message; 
  char data[size];
  size_t len = serializeJson(json, data);
  ws.textAll(data, len);
  if (SerialMonitor) {
    Serial.print ("Notify clients! ");
    Serial.print(" speed_level: ");
    Serial.print(speed_level);
    Serial.print(" | TextSpeed: ");
    Serial.print(TextSpeed);
    Serial.print(" | WebSocket text to all:");
    data[len] = 0;
    Serial.println((char*)data);    
  }
}

// Adjust index.html variables at start or reload
String processor(const String& var){
    Serial.print("+ processor working on: ");
    Serial.println(var);

    if(var == "LOCONAME"){
      return String(loconame); // send loconame for replacement of the header variable in index.html
    }
   
    //other variables in index.html will not by replaced by processor here
    //but by notifyClients() and by sending a JSON message after a short delay indicated by "Starte..."
    return "Starte...";
  }
#endif

////////////////////////////////////////////////////////////////////////////////
// iniSetup function, called at startup and when reloading a new .ini file
////////////////////////////////////////////////////////////////////////////////
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
void loop() {

  // Indicate void loop i.e. program is running by frequent flashes
  ++LoopCount;
  if (LoopCount == MainLoopFrequencyDark) {
    ledWrite(powerLED, HIGH );  //light power LED after dark phase of main loop
  }
  if (LoopCount >= MainLoopFrequency) {
    ledWrite(powerLED, LOW );   //shut off power LED at end of main loop

    Timestamp = Timestamp.shift(-1); 
    Timestamp[0] = millis(); //add current time reference as timestamp
    MainLoopFrequencySeconds = float(Timestamp[0]-Timestamp[1]) /1000; 

    #ifdef SpeedSampling
    if (SpeedSamplingOnOff) {
      SpeedCalculation();      
    }
    #endif
    
    #ifdef PowerSampling
      PowerCalculation();
    #endif

    //notifyClients(); //send program status incl. statusText with powerdata and speeddata 
    if (SerialMonitor) {
      parserLoop(); // Parse any pending commands from serial port
      //monitor_global_variables(); //Serial print of program variables  
    }
    
    LoopCount = 0;
  }

////////////////////////////////////////////////////////////////////////////////
// MAIN LOOP - SpeedSampling 
////////////////////////////////////////////////////////////////////////////////         
  //if (LoopCount % (SpeedSampleLoopCounts) == 0) {  //disabled for similar frequency as core0 SpeedSamplingIRSensor task and fastest response of IR-Recorder
    
    #ifdef SpeedSampling
    if (SpeedSamplingOnOff) {

      //TrackCommandReadingIRSensor
      if (SpeedCounter > PreviousSpeedCounter) {
        PreviousSpeedCounter = SpeedCounter;
		
		/*
        if (SleeperInterval>4 * SleeperIntervalMedian){ //compare newest measurement of SleeperInterval to median of previous 5 SleeperIntervals
          TrackSampling = true;
          ledWrite(redLED, HIGH );
          ledWrite(blueLED, HIGH );
          speed_command = ""; //stop execution of previous speed_command
          TrackBarCode = "";
          TrackInterval = 0;
          for (int i=0; 11; i++) {
            TrackMillis[i]= millis() + int( (0.2 + 0.5*i) * SleeperIntervalMedian);  //Hit centers on sleepers and between sleepers for bar code reading ############ does this work???
          }
        }
		*/
        SleeperIntervalMedian = SleeperIntervalCalculation(); //update SleperIntervalMedian with newest SleeperInterval data
      }
	  /*		
      if (TrackSampling) {
        if (millis() > TrackMillis[TrackInterval]) {
          if (SleeperDetected) { //black element in TrackBarCode
            TrackBarCode= TrackBarCode + "1";
          }
          else {
            TrackBarCode= TrackBarCode + "0";
          }
          TrackInterval++;
          if (TrackInterval > 11) { 
            TrackSampling = false;
            ledWrite(redLED, LOW );
            ledWrite(blueLED, LOW );
            TRACK_BAR_CODE(TrackBarCode.c_str()); //translate 11101010111 to trackcommands and forward as speed_command to ClientCommand subroutine
          }
        }
      }
      */
	  
      //SpeedSamplingIRSensor(); //deactivated, as SpeedSamplingIRSensor() is running in parallel task on core0 as of v233 and after or alternatively triggerd by ESP32 TimerInterrupt in version v222 to v231, see end of setup loop
      if (IRSampleRecording) {
        // devide LoopCount to streches of 500 data points
        if(!IRAverageSample) { //raw IR signal for sample record
          IRSampleRecord[LoopCount % (500)] = IRArray[0]; //copy individual IR sample value from parallel task readings to recorder
        }
        else {  // use averaged IR signal for sample record
          IRSampleRecord[LoopCount % (500)] = IRAverage; //copy averaged IR samples value from parallel task readings to recorder
        }
      }
    }
    #endif 

  //}

////////////////////////////////////////////////////////////////////////////////
// MAIN LOOP - PowerSampling - Monitoring
////////////////////////////////////////////////////////////////////////////////
  #ifdef PowerSampling 
    if (LoopCount % (PowerSampleLoopCounts) == 0) { 
      MotorVoltagCurrentSampling();     
  #endif
  
      if (LoopCount % MonitorLoopCounts == 0) {
        #if defined(ESP32) && defined(TLE5206) //motor IC TLE5206 offers a comprehensive error flag output
          if (!digitalRead(error_motoric)) {   //TLE5206 error indicated if error_motoric = LOW
            motor_set(0);                      //emergency break
            speed_level = 0;
            motor_ok =0;
            IndicateMotorError();
          }
        #endif   
        #ifdef SpeedSampling
          if(SpeedLED){
            ledWrite(blueLED, SleeperDetected);    // indicate detection of railway sleeper, when activated in /speed.html           
          }
        #endif
        // evaluate manual switch digital reading (or any alternative digital HIGH/LOW signal) for MorseCode
        MorseCodeDecoder();
    
        // use speed_command information 1. for motor speed adjustment and 2. for motor PWM setting
        if (!speed_command.equals("")) {
            //Serial.print("Speed_command_received. Speed_wait_countdown = "); //### for Serial monitoring ###
            //Serial.println(speed_wait_countdown);                            //### for Serial monitoring ###
            if (speed_wait_countdown <= 0) {   
              adjustSpeed();
            }
          --speed_wait_countdown;
        }
      } // end of monitoring loop 
       
  #ifdef PowerSampling 
    } // end of PowerSampling loop     
  #endif
 
////////////////////////////////////////////////////////////////////////////////
// MAIN LOOP - Monitoring - ToneSampling
////////////////////////////////////////////////////////////////////////////////  
  #ifdef ToneSampling
    //###### conditional for tone sampling, will be needed for FFT tone signal analysis in PiedPiper
    // Calculate FFT if a full sample is available.
    if (samplingIsDone()) {
      // Run FFT on sample data.
      arm_cfft_radix4_instance_f32 fft_inst;
      arm_cfft_radix4_init_f32(&fft_inst, FFT_SIZE, 0, 1);
      arm_cfft_radix4_f32(&fft_inst, samples);
      // Calculate magnitude of complex numbers output by the FFT.
      arm_cmplx_mag_f32(samples, magnitudes, FFT_SIZE);
      toneLoop(); // Detect tone sequence.
      samplingBegin(); // Restart audio sampling.
    }
  #endif    

} 

////////////////////////////////////////////////////////////////////////////////
////////////////////////////////////////////////////////////////////////////////
////////////////////////////////////////////////////////////////////////////////
// end of main loop  ///////////////////////////////////////////////////////////
////////////////////////////////////////////////////////////////////////////////
////////////////////////////////////////////////////////////////////////////////
////////////////////////////////////////////////////////////////////////////////


////////////////////////////////////////////////////////////////////////////////
////////////////////////////////////////////////////////////////////////////////
////////////////////////////////////////////////////////////////////////////////
// Additional FUNCTIONS  ///////////////////////////////////////////////////////
////////////////////////////////////////////////////////////////////////////////
////////////////////////////////////////////////////////////////////////////////
////////////////////////////////////////////////////////////////////////////////

void SetupLoopCounts() {
  #ifdef SpeedSampling
    if(SpeedSampleFrequency<1) {SpeedSampleFrequency=1;}  
    SpeedSampleLoopCounts = int(MainLoopFrequency/SpeedSampleFrequency);
    SpeedLEDLoopCounts    = int(SpeedSampleLoopCounts*IRSampleAveraging);
  #endif
  #ifdef PowerSampling
    if(PowerSampleFrequency<1) {PowerSampleFrequency=1;}  
    PowerSampleLoopCounts = int(MainLoopFrequency/PowerSampleFrequency);
  #endif
  if(MonitorFrequency<1) {MonitorFrequency=1;}  
  MonitorLoopCounts       = int(MainLoopFrequency/MonitorFrequency);
  MainLoopFrequencyDark   = int(MainLoopFrequency * 0.995);

  if(SpeedAdjustmentFrequency<1) {SpeedAdjustmentFrequency=1;} 
  speed_wait_loops = int (MonitorFrequency / SpeedAdjustmentFrequency); // Number of monitoring loops for delay of next step of speed adjustment, default = ca. 0.5 seconds       §§§§§§§§§§§§§§§§§§§§§§§§§§§§§§
}

////////////////////////////////////////////////////////////////////////////////
// LED indication
////////////////////////////////////////////////////////////////////////////////

void ledWrite(int output, int state) {
#ifndef ESP32C3zero
  digitalWrite (output, state ^ invertLED);
#else
if(state ^ invertLED) { // state = HIGH
  int red = (output >> 16) & 0xFF;  // Extracts the red component from the output
  int green = (output >> 8) & 0xFF; // Extracts the green component from the output
  int blue = output & 0xFF;         // Extracts the blue component from the output
  neopixelWrite (rgbLED, red, green, blue);
}
else {neopixelWrite (rgbLED, 0, 0, 0);} // state = LOW
#endif
}

////////////////////////////////////////////////////////////////////////////////
// Speed calculation and power sampling and calculation
////////////////////////////////////////////////////////////////////////////////

#ifdef SpeedSampling

  int SleeperIntervalCalculation() {
    int SleeperIntervalData[5]; 
    // rotate and copy previous data in SleeperIntervalArray  
    for(int n=4; n>0; n--) {
      SleeperIntervalArray[n] = SleeperIntervalArray[n-1];
      SleeperIntervalData[n] = SleeperIntervalArray[n];
    }
    // insert newest measurment of sleeper interval in milliseconds     
    SleeperIntervalArray[0]=SleeperInterval; 
    SleeperIntervalData[0]=SleeperInterval; 
    //calculate quickmedian from updated SleeperIntervalData, https://www.arduino.cc/reference/en/libraries/quickmedianlib/
    int i, j, l, m, x;  
    l = 0;
    m = 4; //m= dataLength - 1
    while (l < m){
      x = SleeperIntervalData[2];
      i = l;
      j = m;
      do {
        while (SleeperIntervalData[i] < x) i++;
        while (x < SleeperIntervalData[j]) j--;
        if (i <= j){
          int t = SleeperIntervalData[j];
          SleeperIntervalData[j] = SleeperIntervalData[i];
          SleeperIntervalData[i] = t;
          i++;
          j--;
        }
      } while (i <= j);
      if (j < 2) l = i;
      if (2 < i) m = j;
    }
    return SleeperIntervalData[2]; //Median = Mid value of 5 sorted SleeperIntervalData   
  }

  void SpeedCalculation() {
    //save current values as reference values for next evaluation of the differential
    IRSampleCount = IRSampleCount.shift(-1); 
    IRSampleCount[0]=IRSampleCounter;
    SpeedCount = SpeedCount.shift(-1); 
    SpeedCountDifference = SpeedCountDifference.shift(-1); 
    SpeedCount[0]=SpeedCounter;
    SpeedCountDifference[0]=int(SpeedCount[0]-SpeedCount[1]);

    if (SpeedFromSleeperInterval) {   // #################### switch for SpeedSampling method not yet implemented in websites !!! ###########################
      if (speed_level == 0 ) {Speed = 0;} 
      else { 
        Speed = SpeedCountDistance *1000 / float(SleeperIntervalMedian) ; // speed in m/s  = m*1000/ms
      }
    }
    else {
      Speed = float(SpeedCountDifference[0]) * SpeedCountDistance / MainLoopFrequencySeconds; 
    }
    SpeedAtScale = Speed*Scale*3600/1000; // conversion from m/s to scale m/s to scale km/h  
    
    //IRSampleRecording commands for SpeedCounting
    SpeedCountTotal = SpeedCountTotal + SpeedCount[0]-SpeedCount[1]; 
    if (RoundMarkerDetected) {
      if (SpeedCountDifference[0] > SpeedCountDifference[1]) {RoundMarkerDetected = false;}
    }
    else {
      // no speed, very low speed < 50% compared to previous interval or long white/reflective stripe on rail
      if (2*SpeedCountDifference[0] < SpeedCountDifference[1]) {
        if (SerialMonitor) {Serial.println("Indication of RoundMarker found!");}
        RoundMarkerDetected = true;  
        SpeedCountLastTotal = SpeedCountTotal;
        SpeedCountTotal = 0;
        SpeedCountLastSeconds = float(millis() - SpeedCountStartMilli)/1000; //convert last record in millis to seconds
        SpeedCountStartMilli = millis();
        LastSpeed = SpeedCountLastTotal * SpeedCountDistance / SpeedCountLastSeconds; //calculate speed of last record
        LastSpeedAtScale = LastSpeed*Scale*3600/1000; // conversion from m/s to scale m/s to scale km/h 
      }
    }
  } //end of SpeedCalculation  
#endif

#ifdef PowerSampling
// Sampling motor current from ADC1_Ch7 = GPIO pin 35 as voltage at 1 Ohm resistor in grounding to motor IC
  void MotorVoltagCurrentSampling() {
    MotorVoltageArray = MotorVoltageArray.shift(-1);
    MotorCurrentArray = MotorCurrentArray.shift(-1);   
    //linear parametrisation of analog reading, squared for True-RMS average calculation
    portENTER_CRITICAL(&analogReadMux); //prevent conflict with analogReading in TimerInterrupt
    //§§§§§§§§§§§§§§§§§§ Potential for integrating the analog readings in SpeedSamplingIRSensor task on core0, but works nicely here on core1 in v236, integration could render ADCMux obsolete 
    #if (defined(ESP32C3mini) || defined(ESP32C3zero))
      MotorVoltageArray[0] = int(sq((float(analogReadMilliVolts(motor_voltage)) /10))); //devision by 10 in order to fit MotorVoltageArray.sum in integer range      
      MotorCurrentArray[0] = int(sq(float(analogReadMilliVolts(motor_current)) ));  
    #elif
      //Slope and Offset linear correction for calculating millivolt vlaue
      MotorVoltageArray[0] = int(sq((float(analogRead(motor_voltage)) * MotorVoltageSlope + MotorVoltageOffset)/10)); //devision by 10 in order to fit MotorVoltageArray.sum in integer range      
      MotorCurrentArray[0] = int(sq(float(analogRead(motor_current)) * MotorCurrentSlope + MotorCurrentOffset));  
    #endif
    portEXIT_CRITICAL(&analogReadMux);
  }

  void PowerCalculation() {
    MotorVoltageAverage = 10 * int(sqrt(MotorVoltageArray.sum()/MotorVoltageArray.size()) ); //True-RMS calculation, multiply by 10 for original value
    if (MotorVoltageAverage < 3000) {MotorVoltageAverage = int(motor_voltage_supply * 1000);} // replace missing Motor voltage analog reading by preset motor_voltage_supply value from .ini reading
    if (speed_level > 0) {
      MotorCurrentAverage    = int(sqrt(MotorCurrentArray.sum()/MotorCurrentArray.size()) ); //True-RMS calculation
    }
    else {
      MotorCurrentAverage =0; 
    }
    MotorPower = float(MotorCurrentAverage)/1000*(MotorVoltageAverage - float(MotorCurrentAverage))/1000; //accounting voltage drop at 1 Ohm measuring resistor for effective MotorPower
  } 
#endif

////////////////////////////////////////////////////////////////////////////////
// SPECTRUM DISPLAY FUNCTIONS (J Ruppert 2020, built on principles by Tony DiCola, Copyright 2013, MIT License)
//###### conditional for tone sampling, will be needed for FFT tone signal analysis in PiedPiper
///////////////////////////////////////////////////////////////////////////////
#ifdef ToneSampling
  void toneLoop() {
    ++TONE_LoopCount;
    tone_array = tone_array.shift(-1);
    int lowBin = frequencyToBin(TONE_LOWS[tonePosition] - TONE_ERROR_MARGIN_HZ);
    int highBin = frequencyToBin(TONE_HIGHS[tonePosition] + TONE_ERROR_MARGIN_HZ);
    // Get the average intensity of frequencies inside and outside the tone window.
    float window, other;
    windowMean(magnitudes, lowBin, highBin, &window, &other);
    window = intensityDb(window);
    other = intensityDb(other);
    // Check if tone intensity is above the threshold to detect a step in the sequence.
    if ((window - other) >= TONE_THRESHOLD1_DB) {
      // Start timing the window if this is the first in the sequence.
      ledWrite(redLED, HIGH );
      //toneDetected(); //disable for morse signal detection
      ++TONE_ACTIVE_COUNT;  //just for monitoring
      tone_array[0]= int(window-other);
        
    }
    else {
      ledWrite(redLED, LOW );
      //tone_array[0] = int((window - other)/2);  // record value if below TONE_THRESHOLD1_DB; alternatively use half of TONE_THRESHOLD1_DB (or 0) for adjusting the sensitivity of the gliding average assessment
      tone_array[0] = int(TONE_THRESHOLD1_DB/2);  // record value if below TONE_THRESHOLD1_DB; alternatively use half of TONE_THRESHOLD1_DB (or 0) for adjusting the sensitivity of the gliding average assessment
    }
    //is the gliding average over time of multiple events, which are above TONE_THRESHOLD1_DB, also above TONE_THRESHOLD2_DB?
    if (tone_array.sum()/tone_array.size()>= TONE_THRESHOLD2_DB) { 
      tone_signal=true;
      ledWrite(blueLED, HIGH );
  
      //monitor clarity of active tone signal, comment out for faster processing
      if (TONE_LoopCount % 8 == 0) {
         Serial.print  ("Average tone_array= ");
         Serial.print  (tone_array.sum()/tone_array.size());
         Serial.print  (" Tone_array: ");
         for (int j = 0; j < 8;++j) {
           Serial.print(tone_array[j]);
           Serial.print(", ");
         }     
      Serial.println(" ");
      }
     
    }
    else {
      tone_signal=false;
      ledWrite(blueLED, LOW );
    }
  }
  
  // monitor successful toneSequenceDetection after sequence of tones (not used in version 030)
  void toneSequenceDetected() { //do not call, if uninterrupted main loop is required for morse signal detection
    // Flash the green LED multiple times, when the tone was detected.
    ledWrite(redLED, HIGH );
    int pause = 50;
    for (int i = 0; i < 10; ++i) {
      ledWrite(blueLED, HIGH );
      delay(pause);
      ledWrite(blueLED, LOW );
      delay(pause);
    }
    ledWrite(redLED, LOW );
  }
  
  
  ////////////////////////////////////////////////////////////////////////////////
  // SAMPLING FUNCTIONS (by Tony DiCola, Copyright 2013, MIT License)
  ////////////////////////////////////////////////////////////////////////////////
  // ###### conditional for tone sampling, will be needed for FFT tone signal analysis in PiedPiper
  void samplingCallback() {
    // Read from the ADC and store the sample data
    portENTER_CRITICAL(&analogReadMux); //prevent conflict with analogReading in TimerInterrupt
    samples[sampleCounter] = (float32_t)analogRead(AUDIO_INPUT_PIN);
    // disabled light level reading
    // light_level = analogRead(LIGHT_INPUT_PIN);
    portEXID_CRITICAL(&analogReadMux);
    
    // Complex FFT functions require a coefficient for the imaginary part of the input.
    // Since we only have real data, set this coefficient to zero.
    samples[sampleCounter + 1] = 0.0;
    // Update sample buffer position and stop after the buffer is filled
    sampleCounter += 2;
    if (sampleCounter >= FFT_SIZE * 2) {
      samplingTimer.end();
    }
  }
  
  void samplingBegin() {
    // Reset sample buffer position and start callback at necessary rate.
    sampleCounter = 0;
    samplingTimer.begin(samplingCallback, 1000000 / SAMPLE_RATE_HZ);
  }
  
  boolean samplingIsDone() {
    return sampleCounter >= FFT_SIZE * 2;
  }
#endif

////////////////////////////////////////////////////////////////////////////////
// Recording trck code commands from bar code and active IR signals
////////////////////////////////////////////////////////////////////////////////



////////////////////////////////////////////////////////////////////////////////
// Recording morse code commands active input signals (switch_signal, tone_signal)
////////////////////////////////////////////////////////////////////////////////

void MorseCodeDecoder() {
  //input signal active here by input_switch=LOW, i.e. switch_signal=!switch_switch
  //use alternative inputs (light detection, tone detection together with the switch_signal by logical OR combination '||'

#ifdef ESP32DevKit 
    // Touch input multiple sampling and averaging, necessary due to spikes in the touchRead, for preventing false positive switch_signals
    touch_array = touch_array.shift(-1);
    touch_array[0] = touchRead(input_switch); 
    switch_signal = (touch_array.sum()/touch_array.size() < input_switch_level);      //for robust ESP32 DevKit touch sensor reading
  
#else  // uP = ESP32C3mini, ESP32C3zero or Teensy and normally closed microswitch connected to input_switch
    switch_signal = (!digitalRead(input_switch) ^ invertInputSwitch); //normal = not inverted for use with connected normally closed micro switch connected to HIGH and pull-down 10 kOhm resistor

#endif
  
  //light sampling analysis
  //light_signal =  (light_level < LIGHT_THRESHOLD);    // for disabling the assessment of light level readings
  light_signal = false;                                 // for disabling the assessment of light level readings
  
  if (switch_signal || tone_signal || light_signal) {  //Morse code can be transmitted via switch or tone or light
    if (SignalActive == false) {
      delay(5);// delay(button.debounce);
      // additional update status in case of bounce
      // button.currentState = digitalRead(button.pin);
      //reference to millis() function usage:
      //https://www.baldengineer.com/millis-tutorial.html
      //https://www.baldengineer.com/detect-short-long-button-press.html
      SignalTimer = millis();
      SignalActive = true;
      SignalTerminated = false;
    }
    SignalDuration = int (millis() - SignalTimer);
    if ((SignalDuration > dotMinLength) && (shortSignalActive == false)) {
      shortSignalActive = true;
    }
    if ((SignalDuration > dashMinLength) && (longSignalActive == false)) {
      longSignalActive = true;
    }
    if ((SignalDuration > 2*dashMinLength) && (longSignalActive == true)) {
      //2xlongSignal as additional signal for emergency brake, immediate activity
      SignalActive = false;
      longSignalActive = false;
      shortSignalActive = false;
      SignalTerminated = true;
      currentSignal="--";
      Serial.println("Morse signal: emergency brake by very long signal " + currentSignal);
      MORSE_CODE(currentSignal.c_str());
      currentSignal = "";
    }
  }
  //signal not active
  else {
    //evaluate length of last signal
    if (SignalActive) {
      //Serial.print("##### FOR DEBUGGING: Monitor false positive SignalActive readings ##### millis() - SignalTimer = ");
      //Serial.println(millis() - SignalTimer);
      SignalTimer = millis();
      SignalActive = false;
      if (longSignalActive) {
        currentSignal += ("-");
        Serial.println("Recognized: " + currentSignal);
        longSignalActive = false;
        shortSignalActive = false;
      }
      if (shortSignalActive) {
        currentSignal += (".");
        Serial.println("Recognized: " + currentSignal);
        //longSignalActive = false;
        shortSignalActive = false;
      }
    }
    else {
      if (SignalTerminated == false) {
        SignalDuration = int (millis() - SignalTimer);
        if ((SignalDuration > TerminalLength)) {
          SignalTerminated = true; //command completed
          Serial.println("Morse signal: " + currentSignal);
          // translate Morse code in currentSignal to speed_command; input to MORSE_CODE as: const char *
          MORSE_CODE(currentSignal.c_str());
          currentSignal = "";
        }
      }
    }
  }
}

////////////////////////////////////////////////////////////////////////////////
// Parse TRACK_BAR_CODE and translation to speed_command, sizeof(*morsecode)
////////////////////////////////////////////////////////////////////////////////

void TRACK_BAR_CODE (const char* command) {
  ledWrite(redLED, HIGH );
  ledWrite(blueLED, LOW );
  delay(200);
  ledWrite(redLED, LOW );
  ledWrite(blueLED, HIGH );
  delay(200);
  for (unsigned int i = 0 ; i < morsecode_size ; ++i) {
    if (strcmp(command, trackcode[i]) == 0) {
      Serial.println();
      Serial.print("GOT TRACK BAR CODE: ");
      Serial.print(trackcode[i]);
      ledWrite(redLED, HIGH );
      ledWrite(blueLED, LOW );
      delay(200);
      ledWrite(redLED, LOW );
      ledWrite(blueLED, HIGH );
      delay(200);
      ledWrite(redLED, HIGH );
      ledWrite(blueLED, LOW );
      delay(200);
      ledWrite(redLED, LOW );
      ledWrite(blueLED, HIGH );
      delay(200);
      ledWrite(redLED, HIGH );
      ledWrite(blueLED, LOW );
      delay(200);
      ledWrite(redLED, LOW );
      ledWrite(blueLED, HIGH );
      delay(200);
      ledWrite(redLED, HIGH );
      ledWrite(blueLED, LOW );
      delay(200);
      ledWrite(redLED, LOW );
      ledWrite(blueLED, HIGH );
      delay(200);
      ledWrite(redLED, HIGH );
      ledWrite(blueLED, LOW );
      delay(200);
      ledWrite(redLED, LOW );
      ledWrite(blueLED, HIGH );
      delay(200);
      ledWrite(redLED, HIGH );
      ledWrite(blueLED, LOW );
      delay(200);
      ledWrite(redLED, LOW );
      ledWrite(blueLED, HIGH );
      delay(200);
      CLIENT_COMMAND(trackcommands[i]); //for interpretation of "=??" speed adjustment commands and writing to speed_command
      //speed_command = trackcommands[i]; // do not use 'String' in front of speed_command when passing command in subroutine and in if loop, as this will define a new and !non global vairable, which becomes unavailable outside this if loop!
      //Serial.print(" | SPEED COMMAND: ");
      //Serial.print(speed_command);
      Serial.print(" | ACTIVITY: ");
      Serial.println(barcodemeaning[i]);
      speed_wait_countdown = 0;    // don't wait but immedeatly (countdown value = 0) start adjusting the motor speed
      client_message = "T:"+speed_command;
      #ifdef ESP32
        notifyClients();
      #endif  
    }
  }
  ledWrite(redLED, LOW );
  ledWrite(blueLED, LOW );
}

////////////////////////////////////////////////////////////////////////////////
// Parse MORSE_CODE and translation to speed_command, sizeof(*morsecode)
////////////////////////////////////////////////////////////////////////////////

void MORSE_CODE (const char* command) {
  for (unsigned int i = 0 ; i < morsecode_size ; ++i) {
    if (strcmp(command, morsecode[i]) == 0) {
      Serial.println();
      Serial.print("GOT MORSE CODE: ");
      Serial.print(morsecode[i]);
      speed_command = commands[i]; // do not use 'String' in front of speed_command when passing command in subroutine and in if loop, as this will define a new and !non global vairable, which becomes unavailable outside this if loop!
      Serial.print(" | SPEED COMMAND: ");
      Serial.print(speed_command);
      Serial.print(" | ACTIVITY: ");
      Serial.println(meaning[i]);
      speed_wait_countdown = 0;    // don't wait but immedeatly (countdown value = 0) start adjusting the motor speed
      client_message = speed_command;
      #ifdef ESP32
        notifyClients();
      #endif  
    }
  }
}

////////////////////////////////////////////////////////////////////////////////
// Parse CLIENT COMMAND and translation to speed_command, sizeof(*morsecode)
////////////////////////////////////////////////////////////////////////////////
#ifdef ESP32 
void CLIENT_COMMAND (const char* command) {  //const char * commandstrpointer = command.c_str();

      const char * str = "=";
      if (strncmp(command, str, 1)==0) {         // compare first character
        int new_speed_level = atoi(&command[1]); // convert string to integer after first character
        int difference = new_speed_level - speed_level;
        speed_command = "";   
        if (difference <0) {
          for (int i = 0; i > difference; --i) {
            speed_command = speed_command + "-";
          }
        }
        if (difference >0) {
          for (int i = 0; i < difference; ++i) {
            speed_command = speed_command + "+";
          }
        }
        Serial.print("GOT WIFI WEB CLIENT COMMAND");
        Serial.print(" | SPEED COMMAND: ");
        Serial.print(speed_command);
        Serial.print(" | ACTIVITY: ");
        Serial.print("adjust speed by ");
        Serial.println(difference);
        speed_wait_countdown = 0;    // don't wait but immedeatly (countdown value = 0) start adjusting the motor speed
      }
      else {
        speed_command = command;
        Serial.print("GOT WIFI WEB CLIENT COMMAND");
        Serial.print(" | SPEED COMMAND: ");
        Serial.print(speed_command);
        Serial.print(" | ");
        speed_wait_countdown = 0;    // don't wait but immedeatly (countdown value = 0) start adjusting the motor speed
      }   
  notifyClients();
}
#endif

////////////////////////////////////////////////////////////////////////////////
// MOTOR SPEED ADJUSTMENT
////////////////////////////////////////////////////////////////////////////////

void adjustSpeed() {
  Serial.print("Adjust speed: ");
  Serial.print(speed_command.charAt(0)); //evaluate first speed_command character
  Serial.print(" | ");

  //evaluate first speed_command character here: speed_command.charAt(0)
  switch (char(speed_command.charAt(0))) {
    case '0':        //fast brake, speed_level =0
      speed_level = 0;
      motor_set(speed_level);
      ledWrite(redLED, HIGH );
      ledWrite(blueLED, HIGH );
      Serial.print("fast brake, speed level set to 0 | ");
      delay(1000);
      break;
    case '-':        //decrease speed
      --speed_level;
      if (speed_level < 0) {
        speed_level = 0;
        break;
      }
      ledWrite(redLED, HIGH );
      Serial.print("speed level decreased - | ");
      delay(200);
      break;
    case '+':        //increase speed
      ++speed_level;
      if (speed_level > max_speed_level) {
        speed_level = max_speed_level;
        break;
      }
      ledWrite(blueLED, HIGH );
      Serial.print("speed level increased + | ");
      delay(200);
      break;
    case '<':        //reverse direction
      speed_direction = !speed_direction;
      setLight (lightState); 
      if (speed_direction) {
        ledWrite(blueLED, HIGH );
        delay (200);
        ledWrite(blueLED, LOW );
        ledWrite(redLED, HIGH );
        delay (200);
        ledWrite(redLED, LOW );
        ledWrite(blueLED, HIGH );
        delay (200);
        ledWrite(blueLED, LOW );
        delay (200);
        ledWrite(blueLED, HIGH );
        delay (600);
        Serial.print("direction reversed forward >>> | ");
      }
      else {
        ledWrite(redLED, HIGH );
        delay (200);
        ledWrite(redLED, LOW );
        ledWrite(blueLED, HIGH );
        delay (200);
        ledWrite(blueLED, LOW );
        ledWrite(redLED, HIGH );
        delay (200);
        ledWrite(redLED, LOW );
        delay (200);
        ledWrite(redLED, HIGH );
        delay (600);
        Serial.println("direction reversed backward <<< | ");
      }
      break;

    case 'L':        //toggle train light
      lightState = !lightState;
      setLight (lightState); 
      break;

    case 'd': //delay 1 seconds, no LED
      delay (980);     
      Serial.print("delay 1 s | ");
      break;
    case 'g': //light blue (or green) LED
      ledWrite(blueLED, HIGH );
      delay (1980);
      ledWrite(blueLED, LOW );
      Serial.print("light blue LED very long flash | ");
      break;
    case 'r': //light red LED
      ledWrite(redLED, HIGH );
      delay (1980);
      ledWrite(redLED, LOW );
      Serial.print("light red LED very long flash | ");
      break;
    case 'w': //wait 10 seconds
      ledWrite(blueLED, HIGH );
      delay (1800);
      ledWrite(blueLED, LOW );
      delay (1800);
      ledWrite(blueLED, HIGH );
      delay (1500);
      ledWrite(blueLED, LOW );
      delay (1500);
      ledWrite(blueLED, HIGH );
      delay (1200);
      ledWrite(blueLED, LOW );
      delay (1200);
      ledWrite(blueLED, HIGH );
      delay (800);
      ledWrite(blueLED, LOW );
      delay (180);     
      Serial.print("wait 10 s, blue LED flashes | ");
      break;
    case '?': //info
      #ifdef ESP32
        notifyClients();  // Send current speed_level information via Wifi WebSocket to clients, additional early call for updating index.html
      #endif
      InfoText(); //print info text to serial monitor
              
      //indicate motor direction by green and red LED long flash
      if (speed_direction) {
        ledWrite(blueLED, HIGH );
        delay(1500);
        ledWrite(blueLED, LOW );
      }
      else {
        ledWrite(redLED, HIGH );
        delay(1500);
        ledWrite(redLED, LOW );
      }
      delay(100);

      //indicate motor speed by green or red LED short flashes
      for (int i = 0; i < speed_level/2; ++i) {
        delay(480);
        if (speed_direction) {
          ledWrite(blueLED, HIGH );
          delay(20);
          ledWrite(blueLED, LOW );
        }
        if (!speed_direction) {
          ledWrite(redLED, HIGH );
          delay(20);
          ledWrite(redLED, LOW );
        }
      }    
      delay (1000);
      Serial.println();
      break;
    default:
      // if nothing else matches, do the default
      ledWrite(blueLED, HIGH );
      ledWrite(redLED, HIGH );
      delay (200);
      ledWrite(blueLED, LOW );
      ledWrite(redLED, LOW );
      delay (200);
      ledWrite(blueLED, HIGH );
      ledWrite(redLED, HIGH );
      delay (200);
      ledWrite(blueLED, LOW );
      ledWrite(redLED, LOW );
      delay (200);
      ledWrite(blueLED, HIGH );
      ledWrite(redLED, HIGH );
      delay (200);
      Serial.println("unknown command ??? no change of speed");
      break;
  } // end of switch case

  //switch_ok = (digitalRead(input_switch) ^ invertInputSwitch);  // (no condition and value not used after version 029)
  //motor_ok = digitalRead(error_motoric);  // (no condition and value not used after version 029)
  
  // forward new speed_level to motor set
  motor_set(speed_level);

  #ifdef ESP32
    notifyClients();  // Send current speed_level information via Wifi WebSocket to clients
  #endif
  
  // prepare for next round of speed_command
  speed_wait_countdown = speed_wait_loops;
  ledWrite(blueLED, LOW );
  ledWrite(redLED, LOW );
  speed_command.remove(0, 1); //ersase first charcter of speed_command, i.e. the command, which was just executed
} 

////////////////////////////////////////////////////////////////////////////////
// Info Text Layout
////////////////////////////////////////////////////////////////////////////////

void InfoText(){
  Serial.println();
  Serial.println();
  Serial.print("Running arduino/c++ sketch is: ");
  Serial.println(SKETCH_INFO); //print sketch name, license, author
  Serial.println();
  
  //Serial.print morse code information
  Serial.println("Morse code  | speed adjustment                   | meaning ");
  for (int i = 0; i < morsecode_size ; ++i) {
    Serial.print(morsecode[i]);
    int l=(10 - strlen(morsecode[i]));
    for (int i=0; i < l; i++) {
      Serial.print(' ');
    }
    Serial.print("  |  ");
    Serial.print(commands[i]);
    l=(max_speed_level - strlen(commands[i]));
    for (int i=0; i < l; i++) {
      Serial.print(' ');
    }
    Serial.print("  |  ");
    Serial.println(meaning[i]);
  }
  Serial.println();

  //indicate motor speed level by green and red LED very short flashes
  Serial.println("LED INDICATORS"); 
  Serial.println("Information on motor direction:   forward = 1 = green LED; backward = 0 = red LED"); 
  Serial.println("Information on motor speed_level: 0 to 16 short LED flashes");
  Serial.println("Adjustment of motor speed:        green LED flash = speed level + 1; red LED flash = speed level - 1; green & red LEDs long flash = brake, speed level = 0");
  Serial.println("Adjustment of motor direction:    green/red/green + green LED flash = forward = 1;  red/green/red + red LED flash = backward = 0;");
  Serial.println("Tone signal detected:             Single FFT with frequency window > THRESHOLD1: red LED; averaged FFTs frequency windows > THRESHOLD2: green LED = tone signal active");  
  Serial.print  ("Program loop frequencies:         orange flash after ");     
  Serial.print  (MainLoopFrequency);
  Serial.print  (" main loop cycles, "); 
  Serial.print  (MainLoopFrequency/MonitorFrequency);
  Serial.print  (" times monitoring for input activity, "); 
  Serial.print  (MonitorFrequency/ speed_wait_loops); //=SpeedAdjustmentFrequency
  Serial.println(" steps for speed adjustment");
  Serial.print  ("Motor speed setting:              ");     
  Serial.print  (max_speed_level);
  Serial.print  (" speed levels, PWM at lowest speed level "); 
  Serial.print  (speedoffset);
  Serial.print  (" , current PWM: "); 
  if (speed_level > 0){
  Serial.print  ((static_cast<float>(speed_level)/max_speed_level) * (1 - speedoffset) + speedoffset);
  }
  Serial.print  (" @ "); 
  Serial.print  (speed_level); 
  Serial.println(" speed levels");
}

////////////////////////////////////////////////////////////////////////////////
// MOTOR SET: set motor speed level through PWM output
////////////////////////////////////////////////////////////////////////////////

void motor_set (int v) {
  #if defined(ESP32) && (defined(TLE5206) || defined(DRV8871))
      if (v > 0 && v <= max_speed_level) {  // speed level 1 to max_speed_level (default=32), not stopped, motor running
                                            //for TLE5206 and start with exact speedoffset at speed_level 1 use: ledcWrite(pwmChannel2, (1 - static_cast<float>(v)/max_speed_level) * (1-speedoffset) * 256);
        if (speed_direction ^ invertDirection) { //forward direction, invertDirection (toggles) the logic of th motor output via XOR function 1=invert, 0=normal, leave as is
          ledcWrite(pwmChannel1, 255);  // for setting motor1 = HIGH      
          ledcWrite(pwmChannel2, (1 - static_cast<float>(v)/max_speed_level) * (1-speedoffset) * 256);   // for setting motor 2 to PWM settinig for TLE5206 or DRV8871 H-Bridge IC motor driver
          Serial.print("motor set: speed_level ");
          Serial.print(v);
          Serial.print(" forward | PWM analog write motor1 = 255, motor2 = ");
          Serial.println( (1 - static_cast<float>(v)/max_speed_level) * (1-speedoffset) * 256);     
        }
        else { //backward direction
          ledcWrite(pwmChannel1, (1 - static_cast<float>(v)/max_speed_level) * (1-speedoffset) * 256);   // for setting motor 2 to PWM settinig for TLE5206 or DRV8871 H-Bridge IC motor driver
          ledcWrite(pwmChannel2, 255);  // for setting motor2 = HIGH      
          Serial.print("motor set: speed level ");
          Serial.print(v);
          Serial.print(" backward | PWM analog write motor2 = 255, motor1 = ");
          Serial.println( (1 - static_cast<float>(v)/max_speed_level) * (1-speedoffset) * 256);          
        }
      }
      else { // speed level 0 or out of range 1 to max_speed_level: 
             // brake motor by HIGH level on motor 1 and motor 2 inputs = Brake; Out1 and Out2 both on low-side = slow decay of motor current = continued motor current is supporting a fast brake, see DRV8871 manual https://www.ti.com/lit/ds/symlink/drv8871.pdf
        ledcWrite(pwmChannel1, 255);  // for setting motor 1 = HIGH
        ledcWrite(pwmChannel2, 255);  // for setting motor 2 = HIGH
        Serial.print("motor set: ============== BRAKE ============== | ");
        Serial.print(v);
        Serial.print(" | PWM analog write motor1&2 = HIGH, PWM = ");
        Serial.println(0);   
    }

  #elif defined(ESP32) && !defined(TLE5206) && !defined(DRV8871) // for ESP32 in combination with L293D Motor IC
      if (v > 0 && v <= max_speed_level) {  // speed level 1 to max_speed_level (default=32), not stopped, motor running
                                            //for L293D and start with exact speedoffset at speed_level 1 use: ledcWrite(pwmChannel1, ((static_cast<float>(v)/max_speed_level) * (1 - speedoffset) + speedoffset)* 256);
        if (speed_direction ^ invertDirection) { //forward direction, invertDirection (toggles) the logic of th motor output via XOR function 1=invert, 0=normal, leave as is
          digitalWrite(motor1, HIGH);
          digitalWrite(motor2, LOW);          
          ledcWrite(pwmChannel1, ((static_cast<float>(v)/max_speed_level) * (1 - speedoffset) + speedoffset)* 256);   // PWM settinig for L293D H-Bridge IC motor driver
          Serial.print("motor set: speed_level ");
          Serial.print(v);
          Serial.print(" forward | PWM analog write motor1 = HIGH, motor2 = LOW, PWM = ");
          Serial.println(((static_cast<float>(v)/max_speed_level) * (1 - speedoffset) + speedoffset)* 256);     
        }
        else { //backward direction
          digitalWrite(motor1, LOW);
          digitalWrite(motor2, HIGH);   
          ledcWrite(pwmChannel1, ((static_cast<float>(v)/max_speed_level) * (1 - speedoffset) + speedoffset)* 256);   // PWM settinig for L293D H-Bridge IC motor driver
          Serial.print("motor set: speed level ");
          Serial.print(v);
          Serial.print(" backward | PWM analog write motor1 = LOW, motor2 = HIGH, PWM = ");
          Serial.println(((static_cast<float>(v)/max_speed_level) * (1 - speedoffset) + speedoffset)* 256);          
        }
      }
      else { // speed level 0 or out of range 1 to max_speed_level: stop motor
        digitalWrite(motor1, LOW);
        digitalWrite(motor2, LOW);
        ledcWrite(pwmChannel1, 0);  
        Serial.print("motor set: ============== STOP ============== | ");
        Serial.print(v);
        Serial.print(" | PWM analog write motor1&2 = LOW, PWM = ");
        Serial.println(0);    
    }
    
  #else  // mP= default e.g. Teensy 4.0 or Arduino assumed to be in combination with TLE5206 motor IC
    if (v > 0 && v <= max_speed_level) {  // speed level 1 to max_speed_level (default=32), not stopped, motor running
                                          //for start with exact speedoffset at speed_level 1 use: analogWrite(motor2, (max_speed_level - v) * (1 - speedoffset) * 256/max_speed_level);
                                          //approximate and for maximum of 16 speed levels use:   analogWrite(motor2,(16-v)*(1-speedoffset)*16); 
      if (speed_direction ^ invertDirection) { //forward direction, invertDirection (toggles) the logic of th motor output via XOR function 1=invert, 0=normal, leave as is)
        analogWrite(motor1, 255);
        analogWrite(motor2, (max_speed_level - v) * (1 - speedoffset) * 256/max_speed_level);   // Teensy 4.0 PWM settinig for TLE5206S H-Bridge IC motor driver
        Serial.print("motor set: speed_level ");
        Serial.print(v);
        Serial.print(" forward | PWM analog write motor2 = ");
        Serial.println((max_speed_level - v) * (1 - speedoffset) * 256/max_speed_level);
      }
      else { //backward direction
        analogWrite(motor1, (max_speed_level - v) * (1 - speedoffset) * 256/max_speed_level);   // Teensy 4.0 PWM settinig for TLE5206S H-Bridge IC motor driver
        analogWrite(motor2, 255);
        Serial.print("motor set: speed level ");
        Serial.print(v);
        Serial.print(" backward | PWM analog write motor1 = ");
        Serial.println(((max_speed_level - v) * (1 - speedoffset) * 256/max_speed_level));
      }
    }
    else { // speed level 0 or out of range 1 to max_speed_level: stop motor
      analogWrite(motor1, 0);
      analogWrite(motor2, 0);
      Serial.print("motor set: ============== STOP ============== | ");
      Serial.print(v);
      Serial.print(" | PWM analog write motor1&2 = ");
      Serial.println(0);
    }
  #endif
}

////////////////////////////////////////////////////////////////////////////////
// Indicate Motor Error in main loop
////////////////////////////////////////////////////////////////////////////////

void IndicateMotorError() {
  Serial.println();
  Serial.println("============================================");
  Serial.println("=== TLE5206 motor IC error indicated !!! ===");
  Serial.println("============================================");
  Serial.println();
  #ifdef ESP32
    client_message = "!!! Störung am MotorIC !!!";
    notifyClients();
  #endif
  for (int i = 0; i < 50; i++) { //indicate motor error by fast flashing of red and green LED for 10 seconds
    ledWrite(redLED, HIGH );
    ledWrite(blueLED, HIGH );
    delay(100);
    ledWrite(redLED, LOW );
    ledWrite(blueLED, LOW );
    delay(100);
  }

  #ifdef ESP32DevKit
    while (!(touchRead(input_switch) < input_switch_level)) { //wait for touch signal at startup in order to alliviate start-up brown-out cycle
      Serial.print("Waiting for restart signal at GPIO pin ");
      Serial.print(input_switch);
      Serial.print(" TOUCH read= ");
      Serial.println(touchRead(input_switch)); 
      ledWrite(redLED, HIGH );
      ledWrite(blueLED, HIGH );
      delay(950);
      ledWrite(redLED, LOW );
      ledWrite(blueLED, LOW );
      delay(50);
      ledWrite(redLED, HIGH );
      ledWrite(blueLED, HIGH );
      delay(950);
      ledWrite(redLED, LOW );
      ledWrite(blueLED, LOW );
      delay(50);
      #ifdef ESP32
        client_message = "!!! Störung behoben?"; // Wenn ja, Freigabe über den TouchRead pin geben // if yes, release via TouchRead pin
        notifyClients();
      #endif  
    } 
    motor_ok=1; //manual re-setting, but will come back by !error_motoric in main loop, if electrical error is not resolved   
  #endif      
}

////////////////////////////////////////////////////////////////////////////////
// set train light
////////////////////////////////////////////////////////////////////////////////

void setLight (bool state) {
  if (state) { // train light on, one digital output HIGH, other LOW, change of direction will reverse HIGH/LOW, which allows for white/red LED light coulour switch
    digitalWrite(light1, speed_direction ^ invertLight);
    digitalWrite(light2, !(speed_direction ^ invertLight));
  }
  else{        //train light off
    digitalWrite(light1,LOW);
    digitalWrite(light2,LOW);
  }
}

////////////////////////////////////////////////////////////////////////////////
// Monitoring global variables in main loop
////////////////////////////////////////////////////////////////////////////////
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
