jorail/PiedPiperS/PiedPiperS/data/backup1.ini

# lok.ini max line length = buffer = 40
# v263, 2026-07-04
[loco]
name = gr&uuml;ne Dampflok 3915
direction = 1
light = 0
#inverts the logic of the motor PWM
#and light digital outputs via 
#XOR 1=invert 0=normal leave as is
[wifi]
ssid = _gruene_Dampflok_3915
password =
channel = 9
[voltage]
supply = 7.5
#indicate motor Vdc supply 
# = output of step-up converter 
start  = 4.5
#for PWM @ 1st level = speedoffset
#7.0 for Diesellok, supply 14.0
#6.0 for Dampflok
#4.5 for ELok
[speedsampling]
speedcountdistance = 7.5
#distance to next railway sleeper 
#in mm/count, e.g. Maerklin M 5106
#180 mm/24 sleepers = 7.5 mm/count
scale = 87
#model scale, Spur 1 = 32, H0 = 87 
#TT = 120, N = 160
irlow = 0.5
irhigh = 1.6
#IR sensor thresholds in V
#for railway sleeper detection, 
#default deadband from 0.6 to 1.6 V 
averaging = 5
#=IRSampleAveraging
#for averaging of ir samples and
#mitigation of large spikes,
#reduces effective sample frequency
speedled = 0
#1/0 switch detector led indication
[loopfrequency]
#without PowerSampling
#mainloop = 241000 
#with PowerSampling
mainloop = 90000
#frequencies per no. mainloops
#speedsampling = 5000
powersampling = 1000
monitor = 20
speedadjustment = 5  
#per main loop as integer value,
#default speedadjustment = 5
#= 0.2 s delay between speed steps
