jorail/PiedPiperS/(commit log)

2021-03-21 Create PiedPiperS_095_mounting_layout.pdf
    add data and docs folders
    add mounting and layout pdf doc v095
2021-03-22 first code release version 100
    PiedPiperS Version 100
    running and tested with ESP32 NodeMCU DevKit V1
    The PiedPiperS code is placed in a subfolder with the same name as required e.g. by Arduino IDE
2021-03-23 decrease image folder size
    two images moved to archive for meeting size limitation of ESP32 flash memory
2021-03-26 Version 101: ESP32 TouchRead debug
    Debugging the ESP32 TouchRead, preventing false positives due to spikes in the reading by averaging a valarray of readings; add info to image 007
2021-03-26 scale html websites in the code
    Add layout information <meta name=\"viewport\" content=\"width=device-width, initial-scale=1\">
    add img003 ESP32 modification detail to parts.html
2021-03-29 read .ini speed managment info
    read from lok.ini variables on max and start voltage and for speed adjust frequency for easily adjusting PWM setting to a specific loco motor
2021-04-18 improvement v151, ini.html instruction
    minor improvements, reduction of total file size in data folder, in order to prevent .ini file writing errors on ESP32 DevKit v1, instruction for use of ini.html extended, new PiedPiperS.zip generated
2021-04-27 v170 with power data display
    Addition of power data, voltage, current analog input reading on website power.html using chart.js
2021-04-27 v171 add wifi channel from .ini, update of parts.html
    parts.html: measuring resistors
    WiFi: option to modify wifi channel from lok.ini parameters
2021-04-28 docs
    photo documentation, screenshot of /powerdata
2021-04-28 v173, docs
    circuit with measuring resistor option, screenshot index.html
2021-04-28 v173, power data circuit
2021-05-02 v177 html charcter set and layout
    change github.html to devices screen scaling
2021-05-07 v176
    update PiedPiperS.ino, amend html /info by description of motor IC error and its LED indication
2021-05-10 v180 reflective IR detector
    circuit and code amended for testing on GPIO 15, with pinMode INPUT_PULLUP
2021-05-13 v191 IR sensor, speed.html, /speeddata
    complete and functional package for detecting railway sleepers for online speed over ground measurement by reflective IR sensor on analog input ADC1_Ch3. Asmall IR amplifier circuit with a small transistor and two resistors is required to get measurable voltage levels for ESP32 ADC.
2021-05-15 v193 SpeedSampling
    SpeedSampling implemented in PiedPiperS via monitoring from main loop, request for /speeddate, display at speed.html and in StatusText, adjustment of parameters for SpeedSampling and infrared detection of railway sleepers in lok.ini, technical description of optional SpeedSampling in parts.html and electrical circuit as image
2021-05-15 v195 speedo
    development in branch speedo consolidated, speed measurement by IR sensor detection of railway sleepers, parameter adjustment via lok.ini, online display of measured speed data and power data in status text and chart.js line diagrams
2021-05-26 v208 speedo
    speedo: adjusting ini setup for main loop timing, optimise IR sensor sampling for speed measurement
2021-05-31 v208 main loop timing v211 IR sample data recording
    improved variable definition for main loop timing with corresponding redifinition in lok.ini
    addition of irsamplerecord.html
    as viewer for ir data aquision, for fine tuning of deadband (irlow, irhigh voltage thresholds) and counting of sleepers in one train round (terminated by white paper on railway track, > 1s IR reflective ground) for check of completness of railway sleeper counting
2021-06-01 v212
    irsamplerecord.html with internal switch for 'irrecordreading' and explanation
2021-08-18 v237 speedo
    Version 237 has overcome a problem with interrupted and incomplete counting of railway sleepers by assigning the analog reading of IR sensor data to a parallel task
    running on the second core0 of the ESP32 microprocessor. Complete sets of ca. 6000 Hz IR sensor samples are achieved.
    [BR151_lok.ini, BR35_lok.ini, V200_lok.ini, lok.ini]
2021-08-19 v239 speedo optimised
    optimised lok.ini parameters, ca. 5.7 kHz IRsensor sample frequency achieved, with main loop ca. 1.76 s and 2000 power samples/main loop, irlow 0.5 V irhigh 0.7 V
2021-08-19 v241 speedo
    optimise de-noising with option to skip min and max from IRSensor reading for averaging
    [lok.ini]
2021-08-19 v242 speedo
    optimise de-noising with option to skip min and max from IRSensor reading for averaging, ca. 5.6 kHz IRsensor sample frequency achieved, with main loop ca. 1.75 s and 2500 power samples/main loop, irlow 0.5 V irhigh 0.8 V
    [BR151_lok.ini, BR35_lok.ini, V200_lok.ini]
2021-08-20 v234 speedo
    code cleaning , additional descriptions and linking between websites for ease of use related to settings for speed sampling IR sensor
2021-08-21 v244 speedo
    add speedsamplingonoff switch on core0 task
2021-08-27 v244 add description and version track after successful to main
2022-06-05 Train video cam
    2nd version for serving video stream from modelrailroad via from SoftAP on ESP32 cam module
2025-11-23 Add files via upload
    PiedPiperS file built in PlatformIO for ESP32C3 supermini driving L293D motor ic
2026-03-25 Add files via upload
    New smaller design based on ESP32-C3 zero/supermini for placement inside loco and with front/rear lights switching
2026-07-05 Upload PiedPiperS v263 for PlatformIO
    Versions v252 to v259 and v263 were coded with PlatformIO and support use of smaller size Microprocessors ESP32-C3-SuperMini and ESP32-C3-Zero as well as commonly available Motordriver H-Bridge boards DRV8871 and DRV8833. Refer to README.md and PiedPiperS_Instruction.pdf for further detail.
2026-07-05 Update battery type and version information in README
    Corrected 'LiPo' to 'Li-Ion' and updated version details.
2026-07-05 QR codes for printout
