jorail/PiedPiperS/(notices)

Notices in the files:
PiedPiperS/data/PiedPiperS.cpp:
Open .ini file, according to https://github.com/yurilopes/SPIFFSIniFile, GNU GPL v3
UTILITY FUNCTIONS (by Tony DiCola, Copyright 2013, MIT License)
COMMAND PARSING FUNCTIONS (by Tony DiCola, Copyright 2013, MIT License, amended J. Ruppert 2020)
