jorail/PiedPiperS/docs/PiedPiperS_095_indoor_9459.JPG

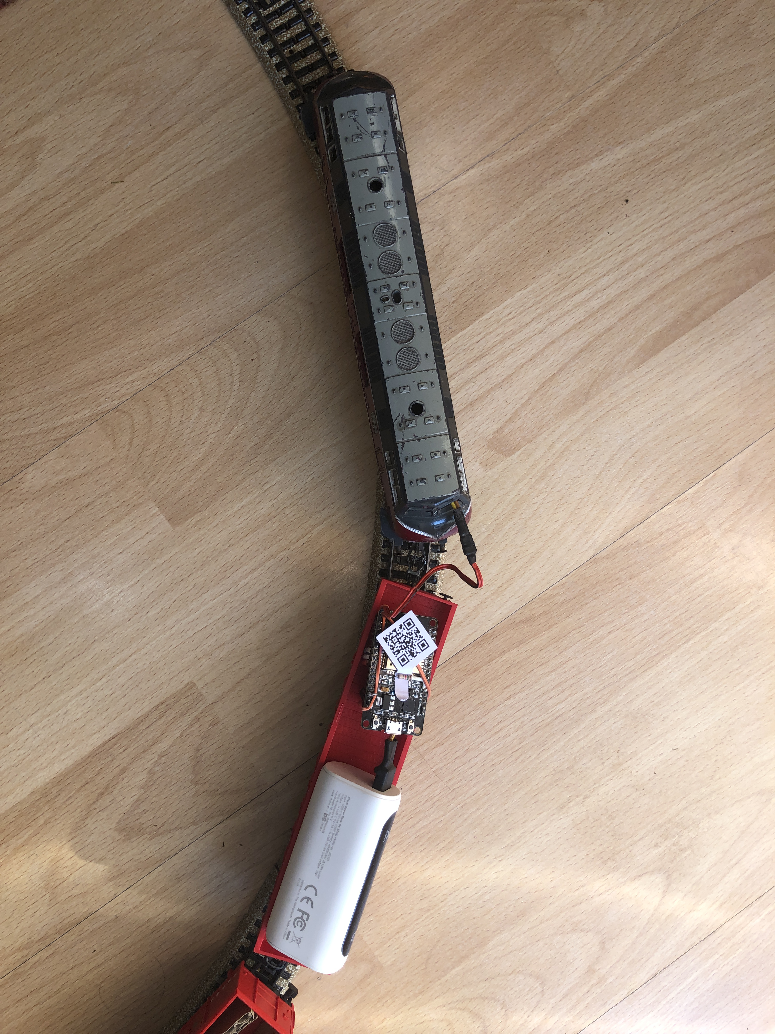
docs/PiedPiperS_095_indoor_9459.JPG
